borzeman/PzbElectronics/qr_code/requirements.md

## Общие сведения
Плата QR кода предназначена для подключения встраиваемых сканеров QR кода узлов
выдачи

## Назначение платы
Питать сканер QR кода и получать с него данные

## Функции
[[../requirements.md#Общие требования для всех плат]]

[[../requirements.md#Общие требования для дочерних плат]]
    Исключение:
    Нет отдельного отладочного UART порта (иначе не хватит на текущем
    контроллере; да и без надобности - любой из UART сканера можно для отладки
    использовать)

1. Сканер QR
   1. Число сканеров: 2
   2. Напряжение питания: 3.2..3.4 В
   3. Выдаваемый ток на каждый сканер: \>= 0.3 А
   4. Интерфейс подключения: UART, изолированный
      Каждый сканер подключается на отдельный UART
   5. Baudrate: \> 115200
   6. Задержка передачи: \< 100 мкс
      (от фронта на коннекторе до фронта на пине мк)
   6. Нужны и чтение, и запись
      сканер настраивается отправкой на него определённых байтов

## Механические свойства
### Изолированные крепления
Все места на плате, которые должны быть куда-то закреплены, должны быть
изолированы (т.е., например, если на плате есть выносной симистор, он должен
быть на изолированной подложке)
Т.е. монтаж платы выглядит так: взяли плату, вкрутили винты в отверстия, всё.
Никаких изоляторов (втулок и прочего) во время монтажа не используется

## Разъёмы
- Выведены штырьковые разъёмы обоих UART'ов
