borzeman/PzbElectronics/requirements.md

## Общие требования для всех плат
1. Наличие отладочных функций
   1. диоды
   2. gpio
   3. usart

2. Разъём отладочный универсальный
   1. содержит пины программатора, отладочные gpio
   2. дополнительный пин как ключ (чтоб не подключиться не той полярностью)

3. Тестовые площадки
   универсальные по контурам (контур rs одинаковые точки прозвонки на всех
   платах)

4. Кварц. внешний тактовый генератор

5. Соблюдён лимит тока пинов мк

6. Гальваническая изоляция питания, входов, выходов (в т.ч. от внешних
   исполнительных устройств типа драйверов)

7. Бирка на шелкографии
    Для идентификации версии платы. Содержит:
    1. лого
    2. тип и версия платы
    3. место под метку номера экземпляра (будем вручную вписывать)

## Общие требования для дочерних плат
1. Шина питания
   Обощая линия питания логики дочерних плат
   1. Напряжение линии: 22-25 В
   2. Допустимый потребляемый платой ток: \< 1 А
2. Шина данных
   Общая линия rs-485 с питанием для изоляторов, плюс отдельная линия rts у
   каждой дочерней платы
   1. Питание
      - Напряжение линии: 3.3 В
      - Допустимый потребляемый платой ток: \< 0.1 А
   2. Контур rs
      - Изолированный
      - Baudrate: \>115200
      - Задержка передачи: \< 100 мкс
      (от фронта на дочернем мк до фронта на линиях A/B)
   3. Линия rts
      - Изолированная
      - Время передачи сигнала: \< 10 мкс
        (от фронта на дочернем мк до фронта на коннекторе)
