borzeman/PzbElectronics/triac_board/requirements.md

# Симисторная плата
## Назначение платы
Управлять двумя ячейками печи (по 2 спирали в каждой)
Независимое управление по полупериодам (=> обнаруживать переход через 0)

## Функции
[[../requirements.md#Общие требования для всех плат]]

[[../requirements.md#Общие требования для дочерних плат]]

1. Входное питание
   1. Напряжение: бытовая сеть (210..230 В переменного)
   2. Потребляемый платой ток: \<= 20 А
2. Управление спиралями
   1. Управление по полупериодам (открыт/закрыт, синусоиду не обрезаем)
   2. Независимое управление
      (в любой момент можем включить/выключить любые спирали)
   3. Не более 2х спиралей включено одновременно (в рамках полупериода)
   4. Ток на спираль: до 9 А
   5. Напряжение на спираль: \>= 95% входного напряжения
   6. Режим работы
      Для каждой спирали: до двух минут непрерывной работы на максимальной
      мощности, далее не менее одного часа паузы
3. Переход через 0
   1. Время реакции: \<= 100 мкс
   (время от перехода через 0 до фронта на мк)
4. Защита от пробоя симистора
5. Защита от короткого замыкания выходов
   (спираль оборвалась и закоротила на себя или на корпус печи)

## Габаритные размеры
????

## Коннекторы и распиновка
Силовые коннекторы 230V должны иметь запас по току минимум в 2 раза от рассчётных значений
  
## Питание
Питание 230V заводится на каждую симисторную плату отдельно (предпочтительно выполнить в виде двухпроводной медной шины с проводником не менее 1.5 кв.мм) 
Питание управляющей части заводится с внешнего блока питания через коннектор материнской платы 

## Шина данных
Шина представляет собой RS485 с одним лишь дополнением. Используется дополнительно линия RTS, по одной линии на каждый дочерний модуль, за исключением "процессорного модуля"
На "процессорном модуле" количество RTS линий соотвествует количеству возможных дочерних модулей исполнительных устройств, например 16. На "процессорном модуле"
линии RTS - входы. На дочерних - выходы.

## Режим работы нагревательного элемента
Режим работы нагревательного элемента представляет собой нагрев в течение 2 минут на высокой мощности с дальнейшей работой в режиме поддержания температуры (5-10% мощности) в течение 20 минут.

## Дополнительно
- Помехи от коммутации напряжения питания нагревательных элементов не должны влиять на работу других узлов платы управления.
- Силовая шина должна проходить через датчик тока, сигнал с которого должен обрабатываться управляющим контроллером платы
- Свободное место слоев платы должно быть покрыто медной фольгой и подтянуто на землю.
- На печатной плате должны быть обозначены в виде примитивов с нумерацией, все микросхемы и основные элементы. Все разъемы должны быть пронумерованы с обозначением первой ноги. Ножки и разъемы эл. питания должны быть подписаны с указанием уровней напряжений.
- Печатная плата должна быть покрыта защитной маской со всех сторон.
- Первичную трассировку проводов имеет смысл провести до начала разводки плат, дабы исключить коллизии проводов и чтоб появилось понимание оптимального расположения коннекторов на платах.
- Все входы-выходы должны иметь защиту от перенапряжения, обратной полярности, статики и т.п.(см IEC 61131 и прочие посказки)
