borzeman/PzbElectronics/digit_in_board/requirements.md

# Плата дискретных входов выходов

## Общие сведения
Плата с универсальными входами для сигналов и выходами для управления нагрузкой
Входы и выходы назависимые, выходы могут напрямую управлять небольшой нагрузкой

## Назначение платы
- Управлять npn транзисторами, коммутирующими светодиодные ленты
  каждым каналом независимо, с изменением яркости
- Управлять магнитными замками напрямую
- Открывать реле для управления ультразвуковыми генераторами
- Питать диоды и фототранзисторы платы led\_board
- Принимать сигналы от платы led\_board

## Функции
[[../requirements.md#Общие требования для всех плат]]

[[../requirements.md#Общие требования для дочерних плат]]

1. Входы
   логика 24 В, дискретные, независимые, с гистерезисом
   1. Время реакции: \< 1 мс
      (время от фронта на коннекторе до фронта на пине мк)
   2. Напряжение
      1. Максимум: 25 В
      2. Минимум: -0.5 В
      3. Нижний уровень: \<= 3 В
      4. Верхний уровень: \>= 20 В
   3. Ток
      1. Потребляемый: \<= 10 мА
         (т.е. плата ограничивает потребялемый ток этим значением)
      2. Достаточный для срабатывания: \<= 2 мА
   4. Независимые
      (мк получает сигналы отдельно для каждого входа)
2. Выходы
   24 В, дискретные, независимые, с ШИМом
   1. Время реакции: \< 10 мкс
      (время от фронта на пине мк до фронта на выходе)
   2. Напряжение: 0..24+-0.5 В
   3. Выдаёт ток
      1. до 1 А на канал
      2. до 3 А в сумме постоянно
      3. до 6 А в сумме в течение 30 секунд
   4. Независимое управление
   5. ШИМ
      1. Частота: \>= 500 Гц
      2. Шаг скважности: \>= 1%
3. Защита от переполюсовки питания
   Плата не должна выйти из строя от переполюсовки внешнего питания
   (выдерживает \>= 2 минуты подключения питания с обратной полярностью)
4. Без питания логической части не должен подаваться ток на выходы
   (даже если силовая часть запитана, а логика нет)
