borzeman/PzbElectronics/analog_io_board/requirements.md

## Общие сведения
Вспомогательная плата для узла печи - вмещает элементы, не вошедшие в другие,
более универсальные, платы

Её функции - управление вентиляторами, замер тока и температуры, управление
входным реле печи

Дополнительно предполагаем использовать её в холодильнике (т.к. периферия
сильно пересекается) для управления вентиляторами, компрессором и получения
температуры с датчика холодильника

## Дочерняя плата
Данная плата является дочерней, вопросы ниже в ней такие же, как в дочерних
платах:
- Питание
- Шинна данных
- Собственный контроллер
- Защита входов-выходов

## Периферия
### Вентиляторы
2 канала, управляемых независимо (на одном канале вентилятор или группа
вентиляторов)
    [в холодильнике вентиляторы объединены в 2 группы]
220VAC
До 100 Вт
    [в холодильнике на одном канале до 4х вентиляторов по 20 Вт, плюс 20%
    запас]
Должны уметь регулировать скорость вращения
    [Вентилятор инертен, поэтому предполагаем, что низкой частоты ШИМ хватит, и
    что сможем делать это симисторами]

### Датчик тока
1 штука, трансформатор
Диапазон: 0..50А
Разрешение: не менее 1А
    [на контроллер должна приходить информация о текущем токе с шагом не более
    1А
    датчик и вся схемотехника должны обеспечить такое разрешение]

Должна быть фильтрация сигнала

### Датчик температуры
2 штуки, термопара

Диапазон: -10..150 градусов Цельсия
    [чтоб использовать в т.ч. датчики из холодильника]
Разрешение: не менее 1 градуса
    [точность в градус для управления холодильником
    для печи хватило бы и 5 градусов]
Обеспечить режим работы холодильника 2..8 градусов
    [вся схемотехника и датчики такие, чтоб можно было получить нужный
    гистерезис]

Должна быть фильтрация сигнала

### Входное реле
Реле, размыкающее питание на всю силовую часть печи
Используется для программной защиты от ошибок (например, когда какой-то
симистор пробит, автомат не сработает, т.к. ток через него не превышает лимит;
программно обнаружим превышение тока и отключим реле)
Пример: SSR-100-DA

1 штука
Тип: твердотельное или механическое
    учесть диод для подключения механического реле
Управляющий сигнал:
    Включение: 24VDC
    Выключение: <3.5VDC
    НЕ ограничивать ток (будут использоваться реле с входным сопротивлением)

## Механические свойства
### Изолированные крепления
Все места на плате, которые должны быть куда-то закреплены, должны быть
изолированы (т.е., например, если на плате есть выносной симистор, он должен
быть на изолированной подложке)
Т.е. монтаж платы выглядит так: взяли плату, вкрутили винты в отверстия, всё.
Никаких изоляторов (втулок и прочего) во время монтажа не используется
