borzeman/PzbElectronics/led_and_photodiode_board/led_and_photodiode_board.kicad_pcb

## KiCad design led_and_photodiode_board/led_and_photodiode_board.kicad_pcb (2025-10-31)

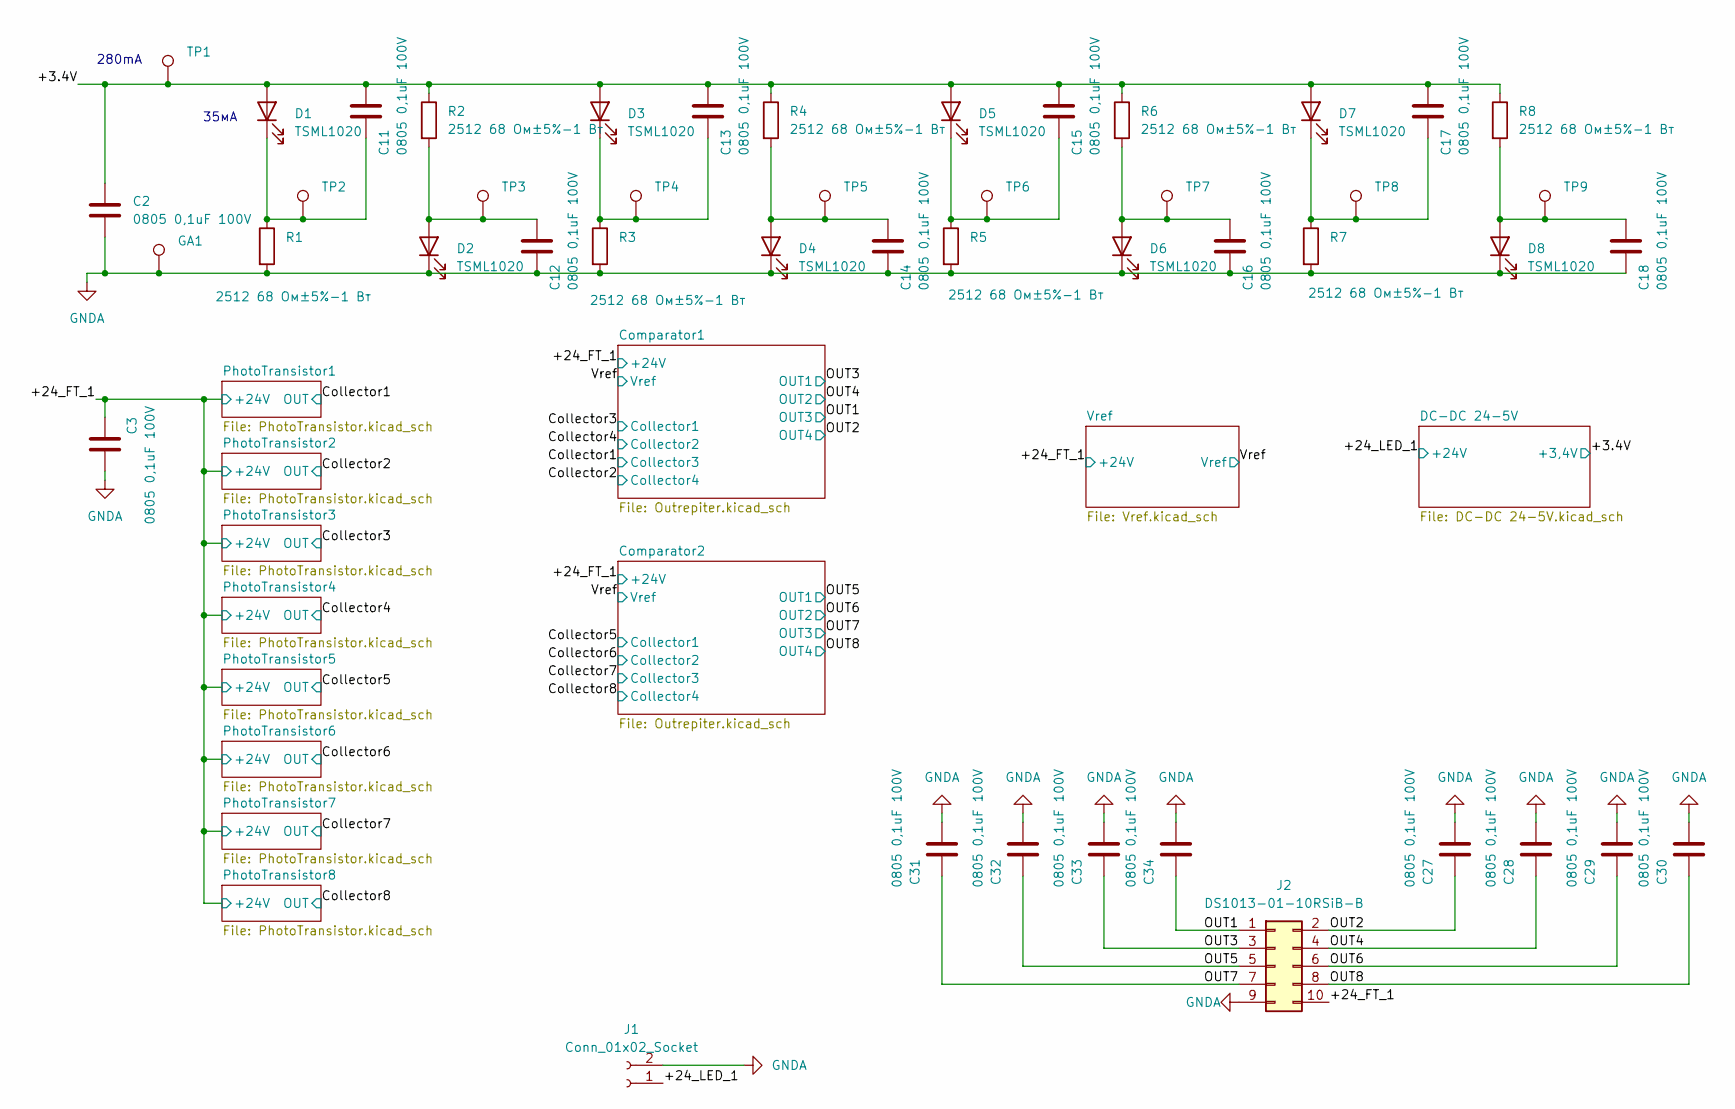
[picture p1: schematic led_and_photodiode_board.kicad_sch]

Parts:
C2, C3, C11, C12, C13, C14, C15, C16, C17, C18, C27, C28, C29, C30, C31, C32, C33, C34: 0805 0,1uF 100V; C_0805_2012Metric
D1, D2, D3, D4, D5, D6, D7, D8: TSML1020; D_MiniMELF
GA1: TestPoint; TestPoint_Pad_D1.0mm
J1: Conn_01x02_Socket; SolderWire-0.75sqmm_1x02_P7mm_D1.25mm_OD3.5mm
J2: DS1013-01-10RSiB-B; IDC-Header_2x05_P2.54mm_Horizontal
R1, R2, R3, R4, R5, R6, R7, R8: 2512 68 Ом±5%-1 Вт; R_2512_6332Metric
TP1, TP2, TP3, TP4, TP5, TP6, TP7, TP8, TP9: TestPoint; TestPoint_Pad_D1.0mm

Connections:
/+3.4V: C2.1, C11.1, C13.1, C15.1, C17.1, D1.2 (A), D3.2 (A), D5.2 (A), D7.2 (A), R2.1, R4.1, R6.1, R8.1, TP1.1; also elsewhere on the board
/+24_FT_1: C3.1, J2.10; also elsewhere on the board
/+24_LED_1: J1.1; also elsewhere on the board
/OUT1: C34.1, J2.1; also elsewhere on the board
/OUT2: C27.1, J2.2; also elsewhere on the board
/OUT3: C33.1, J2.3; also elsewhere on the board
/OUT4: C28.1, J2.4; also elsewhere on the board
/OUT5: C32.1, J2.5; also elsewhere on the board
/OUT6: C29.1, J2.6; also elsewhere on the board
/OUT7: C31.1, J2.7; also elsewhere on the board
/OUT8: C30.1, J2.8; also elsewhere on the board
GNDA: C2.2, C3.2, C12.2, C14.2, C16.2, C18.2, C27.2, C28.2, C29.2, C30.2, C31.2, C32.2, C33.2, C34.2, D2.1 (K), D4.1 (K), D6.1 (K), D8.1 (K), GA1.1, J1.2, J2.9, R1.2, R3.2, R5.2, R7.2; also elsewhere on the board
unnamed: C11.2, D1.1 (K), R1.1, TP2.1
unnamed: C12.1, D2.2 (A), R2.2, TP3.1
unnamed: C13.2, D3.1 (K), R3.1, TP4.1
unnamed: C14.1, D4.2 (A), R4.2, TP5.1
unnamed: C15.2, D5.1 (K), R5.1, TP6.1
unnamed: C16.1, D6.2 (A), R6.2, TP7.1
unnamed: C17.2, D7.1 (K), R7.1, TP8.1
unnamed: C18.1, D8.2 (A), R8.2, TP9.1

Notes on the sheet:
35мА
280mA

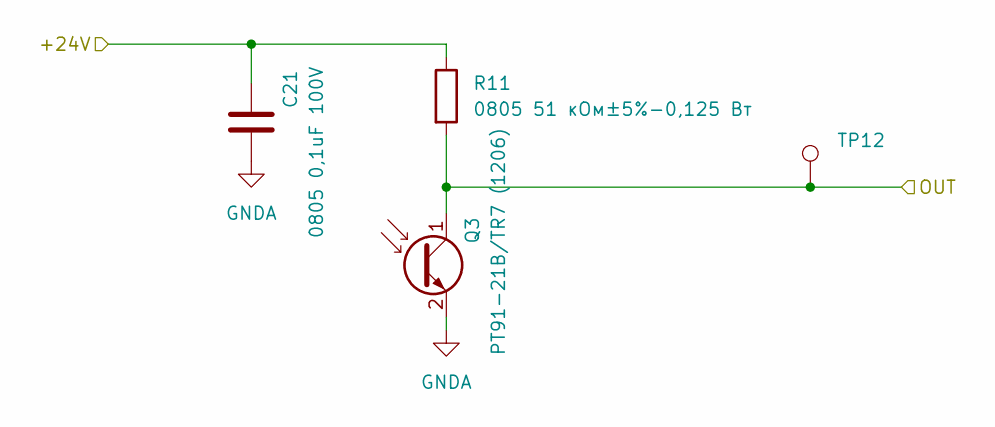
[picture p2: schematic PhotoTransistor.kicad_sch]

Parts:
C21: 0805 0,1uF 100V; C_0805_2012Metric
Q3: PT91-21B/TR7 (1206); D_1206_3216Metric_Pad1.42x1.75mm_HandSolder
R11: 0805 51 кОм±5%-0,125 Вт; R_0805_2012Metric
TP12: TestPoint; TestPoint_Pad_D1.0mm

Connections:
/+24_FT_1: C21.1, R11.1; also elsewhere on the board
/Collector3: Q3.1 (C), R11.2, TP12.1; also elsewhere on the board
GNDA: C21.2, Q3.2 (E); also elsewhere on the board

Parts of its further copies:
C19, C20, C22, C23, C24, C25, C26: 0805 0,1uF 100V; C_0805_2012Metric
Q1, Q2, Q4, Q5, Q6, Q7, Q8: PT91-21B/TR7 (1206); D_1206_3216Metric_Pad1.42x1.75mm_HandSolder
R9, R10, R12, R13, R14, R15, R16: 0805 51 кОм±5%-0,125 Вт; R_0805_2012Metric
TP10, TP11, TP13, TP14, TP15, TP16, TP17: TestPoint; TestPoint_Pad_D1.0mm

Connections of its further copies:
/+24_FT_1: C19.1, C20.1, C22.1, C23.1, C24.1, C25.1, C26.1, R9.1, R10.1, R12.1, R13.1, R14.1, R15.1, R16.1; also elsewhere on the board
/Collector1: Q1.1 (C), R9.2, TP10.1; also elsewhere on the board
/Collector2: Q2.1 (C), R10.2, TP11.1; also elsewhere on the board
/Collector4: Q4.1 (C), R12.2, TP13.1; also elsewhere on the board
/Collector5: Q5.1 (C), R13.2, TP14.1; also elsewhere on the board
/Collector6: Q6.1 (C), R14.2, TP15.1; also elsewhere on the board
/Collector7: Q7.1 (C), R15.2, TP16.1; also elsewhere on the board
/Collector8: Q8.1 (C), R16.2, TP17.1; also elsewhere on the board
GNDA: C19.2, C20.2, C22.2, C23.2, C24.2, C25.2, C26.2, Q1.2 (E), Q2.2 (E), Q4.2 (E), Q5.2 (E), Q6.2 (E), Q7.2 (E), Q8.2 (E); also elsewhere on the board

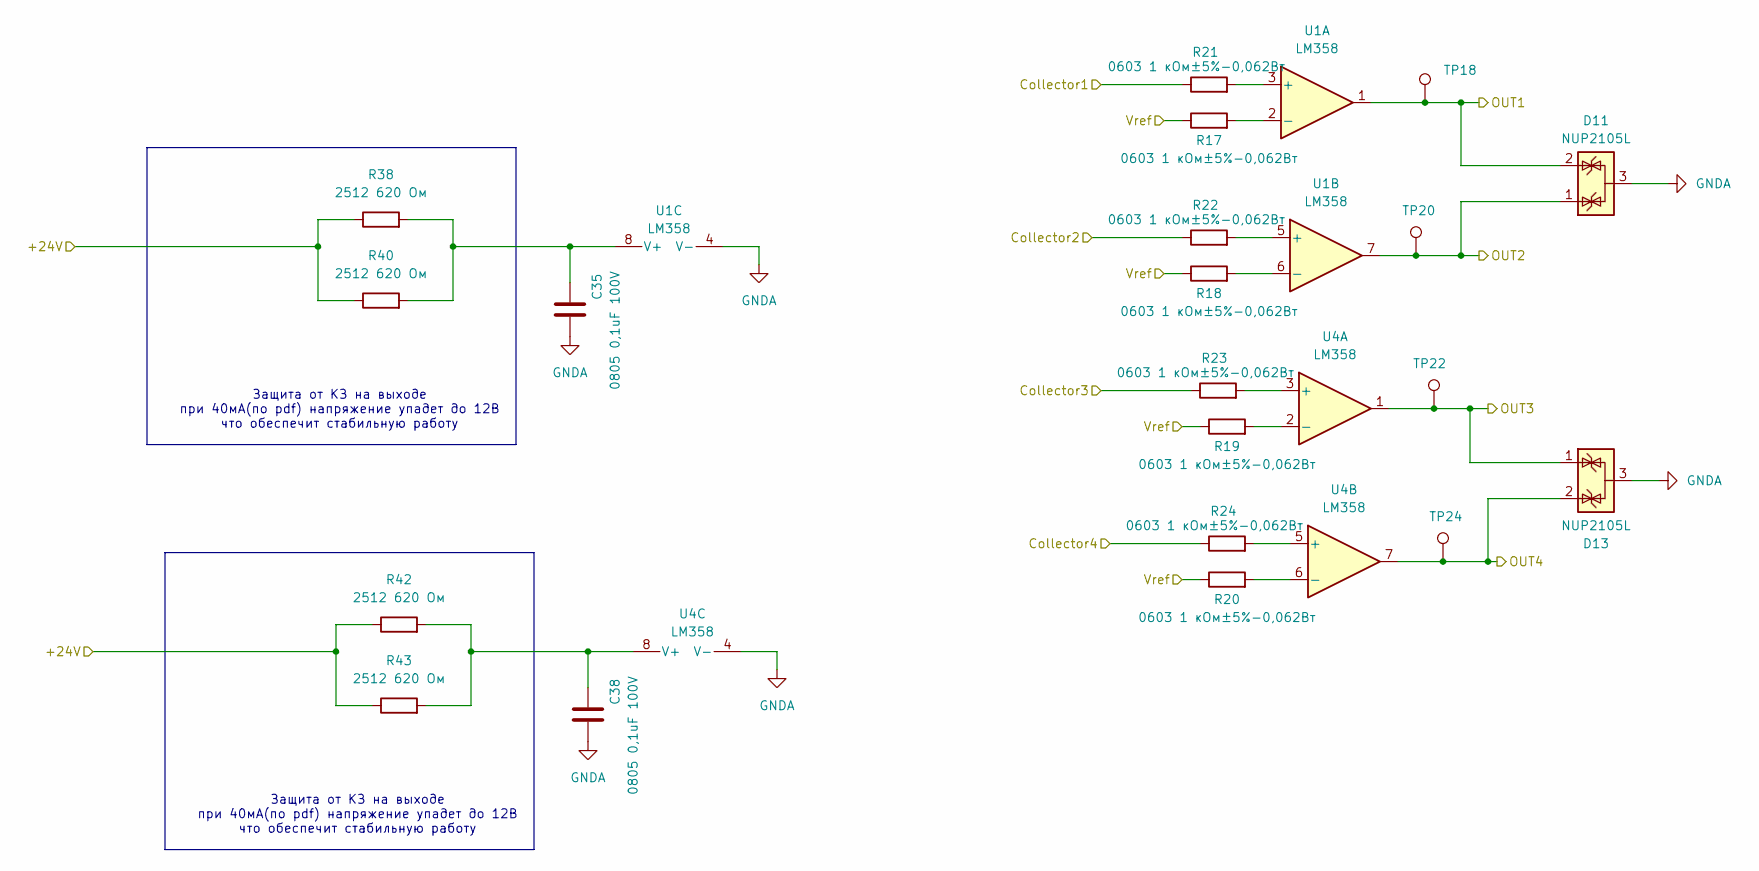
[picture p3: schematic Outrepiter.kicad_sch]

Parts:
C35, C38: 0805 0,1uF 100V; C_0805_2012Metric
D11, D13: NUP2105L; SOT-23
R17, R18, R19, R20, R21, R22, R23, R24: 0603 1 кОм±5%-0,062Вт; R_0603_1608Metric
R38, R40, R42, R43: 2512 620 Ом; R_2512_6332Metric
TP18, TP20, TP22, TP24: TestPoint; TestPoint_Pad_D1.0mm
U1, U4: LM358; SOIC-8_3.9x4.9mm_P1.27mm

Connections:
/+24_FT_1: R38.1, R40.1, R42.1, R43.1; also elsewhere on the board
/Collector1: R23.1; also elsewhere on the board
/Collector2: R24.1; also elsewhere on the board
/Collector3: R21.1; also elsewhere on the board
/Collector4: R22.1; also elsewhere on the board
/OUT1: D13.1 (K), TP22.1, U4.1; also elsewhere on the board
/OUT2: D13.2 (K), TP24.1, U4.7; also elsewhere on the board
/OUT3: D11.2 (K), TP18.1, U1.1; also elsewhere on the board
/OUT4: D11.1 (K), TP20.1, U1.7; also elsewhere on the board
/Vref: R17.1, R18.1, R19.1, R20.1; also elsewhere on the board
GNDA: C35.2, C38.2, D11.3 (A), D13.3 (A), U1.4 (V-), U4.4 (V-); also elsewhere on the board
unnamed: R21.2, U1.3 (+)
unnamed: R17.2, U1.2 (-)
unnamed: R22.2, U1.5 (+)
unnamed: R18.2, U1.6 (-)
unnamed: C35.1, R38.2, R40.2, U1.8 (V+)
unnamed: R23.2, U4.3 (+)
unnamed: R19.2, U4.2 (-)
unnamed: R24.2, U4.5 (+)
unnamed: R20.2, U4.6 (-)
unnamed: C38.1, R42.2, R43.2, U4.8 (V+)

Parts of its further copies:
C1, C39: 0805 0,1uF 100V; C_0805_2012Metric
D12, D14: NUP2105L; SOT-23
R25, R26, R27, R28, R29, R30, R31, R32: 0603 1 кОм±5%-0,062Вт; R_0603_1608Metric
R39, R41, R44, R45: 2512 620 Ом; R_2512_6332Metric
TP19, TP21, TP23, TP25: TestPoint; TestPoint_Pad_D1.0mm
U2, U5: LM358; SOIC-8_3.9x4.9mm_P1.27mm

Connections of its further copies:
/+24_FT_1: R39.1, R41.1, R44.1, R45.1; also elsewhere on the board
/Collector5: R25.1; also elsewhere on the board
/Collector6: R27.1; also elsewhere on the board
/Collector7: R29.1; also elsewhere on the board
/Collector8: R31.1; also elsewhere on the board
/OUT5: D12.2 (K), TP19.1, U2.1; also elsewhere on the board
/OUT6: D12.1 (K), TP21.1, U2.7; also elsewhere on the board
/OUT7: D14.1 (K), TP23.1, U5.1; also elsewhere on the board
/OUT8: D14.2 (K), TP25.1, U5.7; also elsewhere on the board
/Vref: R26.1, R28.1, R30.1, R32.1; also elsewhere on the board
GNDA: C1.2, C39.2, D12.3 (A), D14.3 (A), U2.4 (V-), U5.4 (V-); also elsewhere on the board
unnamed: R25.2, U2.3 (+)
unnamed: R26.2, U2.2 (-)
unnamed: R27.2, U2.5 (+)
unnamed: R28.2, U2.6 (-)
unnamed: C1.1, R39.2, R41.2, U2.8 (V+)
unnamed: R29.2, U5.3 (+)
unnamed: R30.2, U5.2 (-)
unnamed: R31.2, U5.5 (+)
unnamed: R32.2, U5.6 (-)
unnamed: C39.1, R44.2, R45.2, U5.8 (V+)

Notes on the sheet:
Защита от КЗ на выходе при 40мА(по pdf) напряжение упадет до 12В что обеспечит стабильную работу

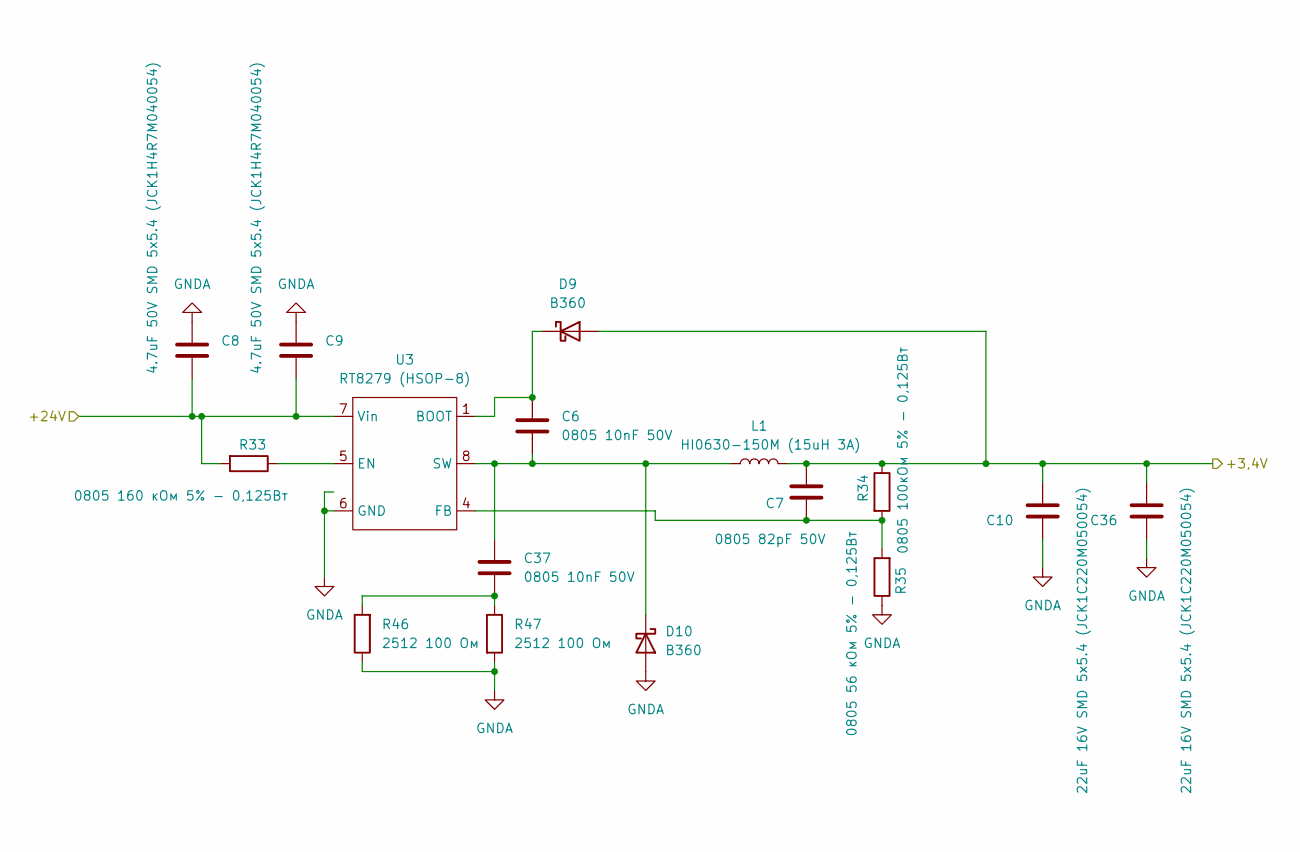
[picture p4: schematic DC-DC 24-5V.kicad_sch]

Parts:
C6, C37: 0805 10nF 50V; C_0805_2012Metric
C7: 0805 82pF 50V; C_0805_2012Metric
C8, C9: 4.7uF 50V SMD 5x5.4 (JCK1H4R7M040054); C_Elec_5x5.4
C10, C36: 22uF 16V SMD 5x5.4 (JCK1C220M050054); C_Elec_5x5.4
D9, D10: B360; D_SMC
L1: HI0630-150M (15uH 3A); L_APV_APH0630
R33: 0805 160 кОм 5% - 0,125Вт; R_0805_2012Metric
R34: 0805 100кОм 5% - 0,125Вт; R_0805_2012Metric
R35: 0805 56 кОм 5% - 0,125Вт; R_0805_2012Metric
R46, R47: 2512 100 Ом; R_2512_6332Metric_Pad1.40x3.35mm_HandSolder
U3: RT8279 (HSOP-8); HSOP-8-1EP_3.9x4.9mm_P1.27mm_EP2.41x3.1mm

Connections:
/+3.4V: C7.1, C10.2, C36.2, D9.2 (A), L1.2, R34.1; also elsewhere on the board
/+24_LED_1: C8.2, C9.2, R33.2, U3.7 (Vin); also elsewhere on the board
GNDA: C8.1, C9.1, C10.1, C36.1, D10.2 (A), R35.1, R46.1, R47.2, U3.2 (NC), U3.3 (NC), U3.6 (GND), U3.9 (GND); also elsewhere on the board
unnamed: C37.1, R46.2, R47.1
unnamed: C6.1, D9.1 (K), U3.1 (BOOT)
unnamed: C6.2, C37.2, D10.1 (K), L1.1, U3.8 (SW)
unnamed: R33.1, U3.5 (EN)
unnamed: C7.2, R34.2, R35.2, U3.4 (FB)

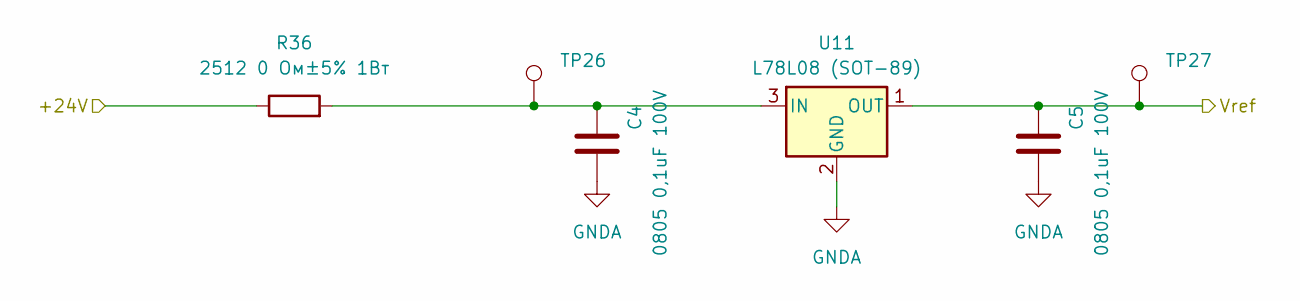
[picture p5: schematic Vref.kicad_sch]

Parts:
C4, C5: 0805 0,1uF 100V; C_0805_2012Metric
R36: 2512 0 Ом±5% 1Вт; R_2512_6332Metric
TP26, TP27: TestPoint; TestPoint_Pad_D1.0mm
U11: L78L08 (SOT-89); SOT-89-3

Connections:
/+24_FT_1: R36.1; also elsewhere on the board
/Vref: C5.1, TP27.1, U11.1 (OUT); also elsewhere on the board
GNDA: C4.2, C5.2, U11.2 (GND); also elsewhere on the board
unnamed: C4.1, R36.2, TP26.1, U11.3 (IN)

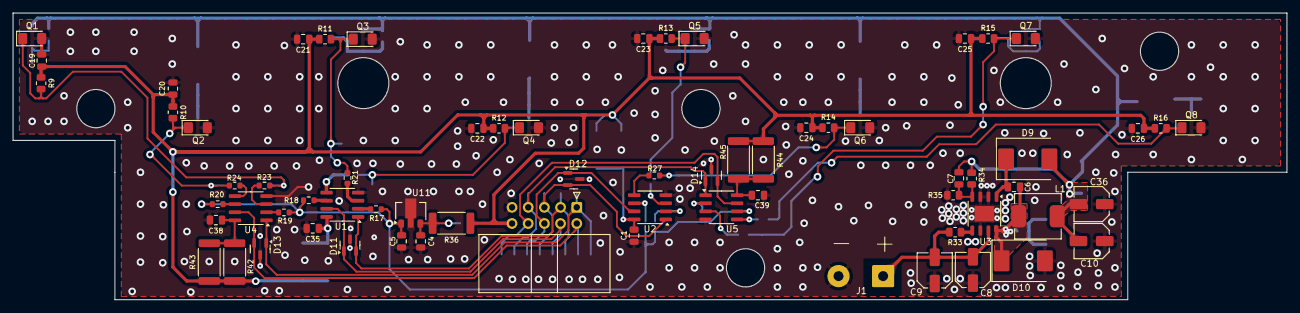
[picture p6: board led_and_photodiode_board.kicad_pcb from above]

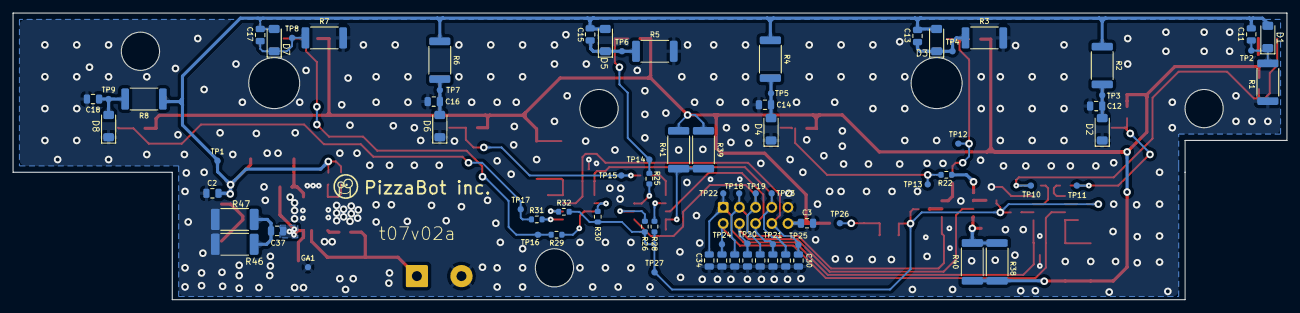
[picture p7: board led_and_photodiode_board.kicad_pcb from below]

Board: 2 copper layers, 200.0 x 45.0 mm, 144 parts (77 on the bottom side), 55 nets.
