borzeman/PzbElectronics/dc_motor_board/dc_motor_board.kicad_pcb

## KiCad design dc_motor_board/dc_motor_board.kicad_pcb (2025-10-31)

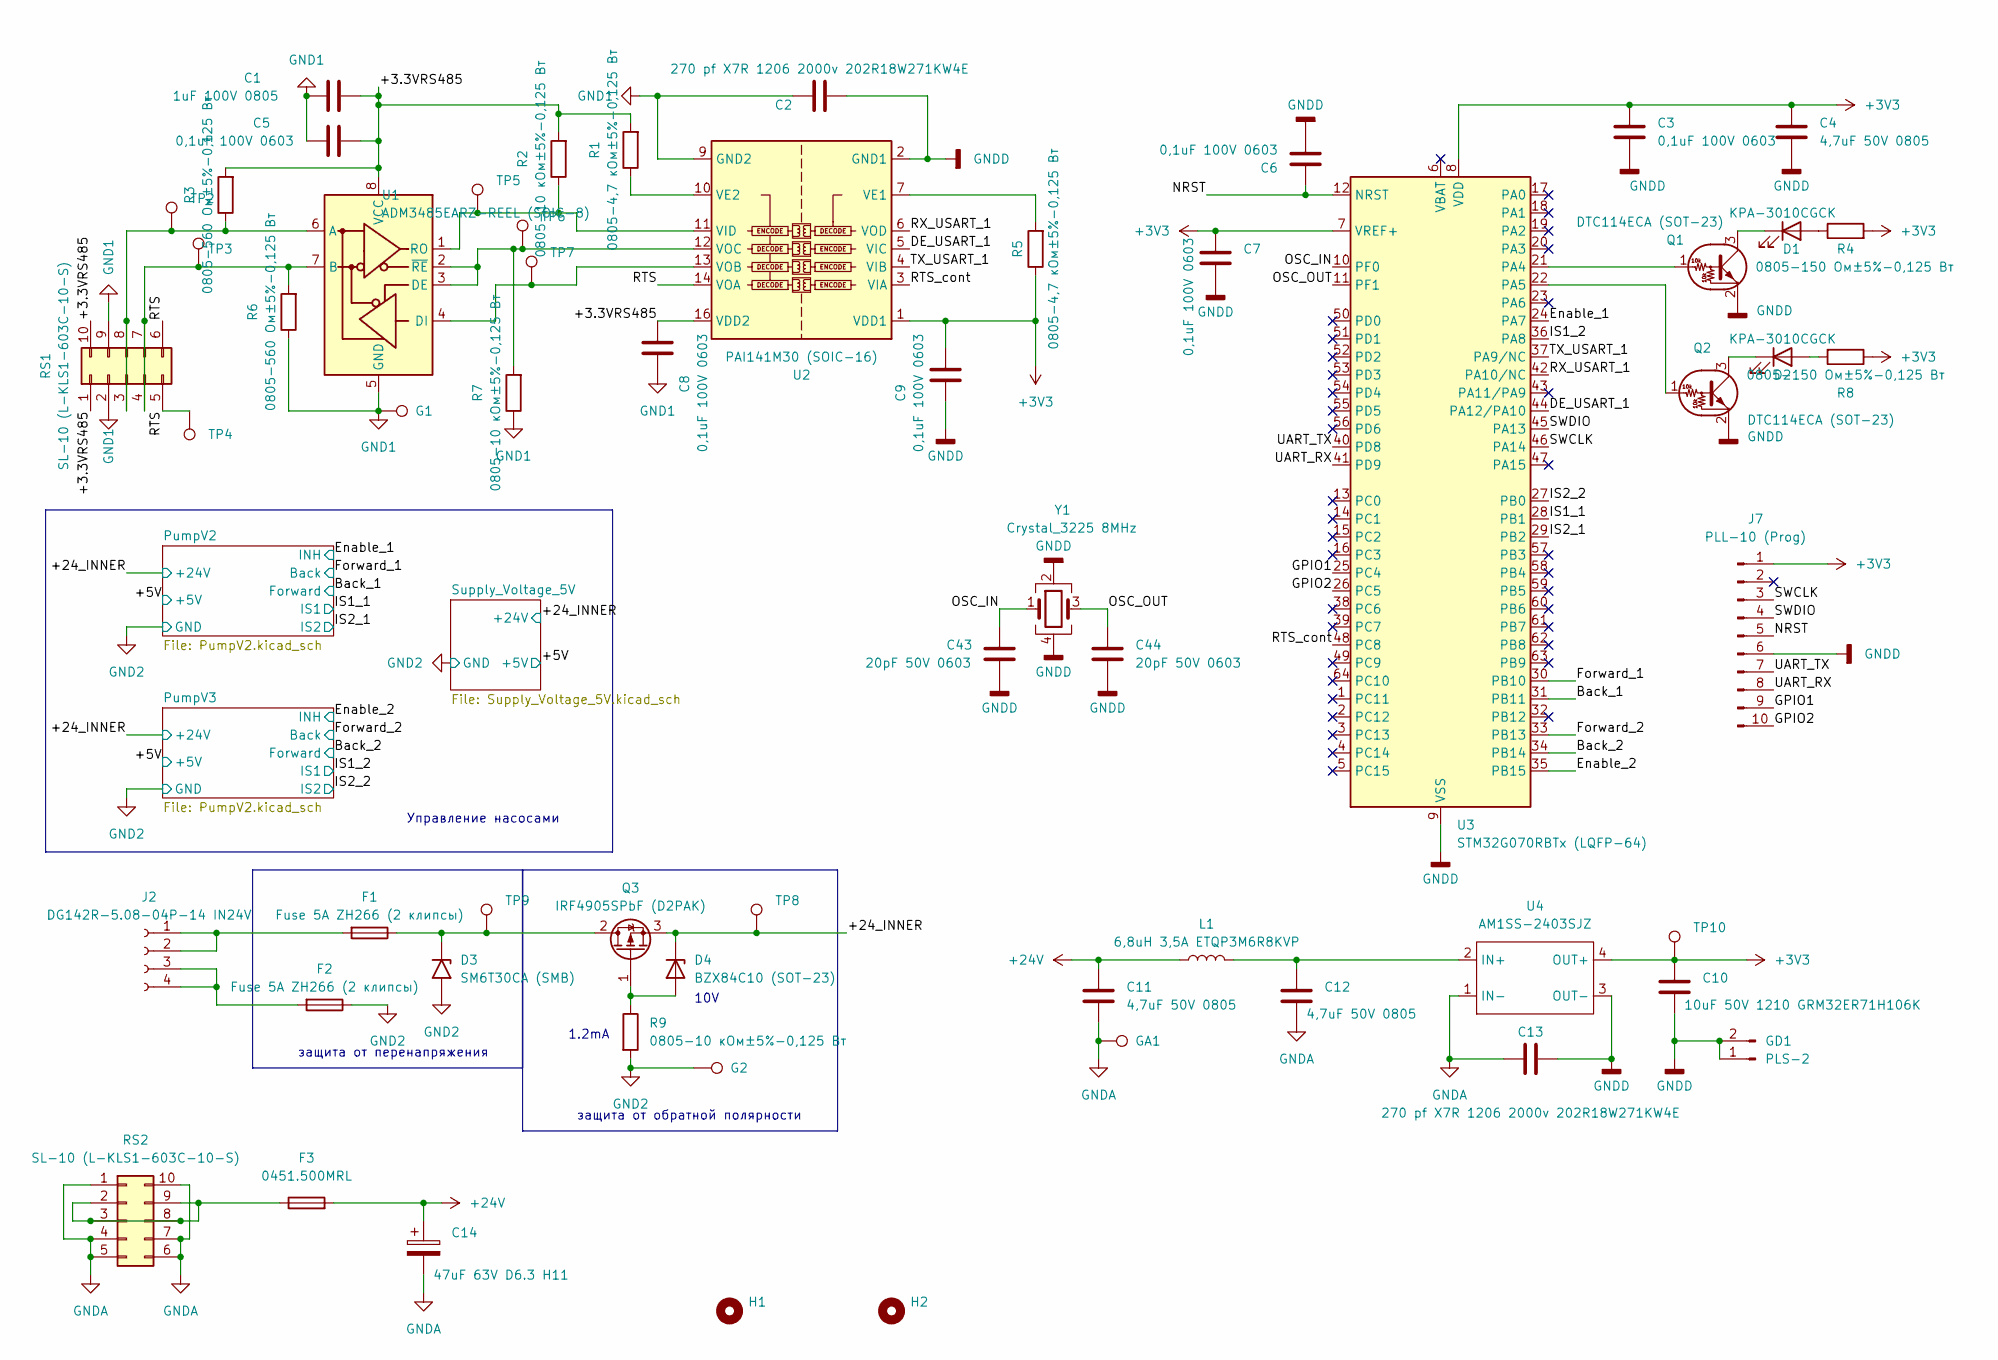
[picture p8: schematic dc_motor_board.kicad_sch]

Parts:
C1: 1uF 100V 0805; C_0805_2012Metric
C2, C13: 270 pf X7R 1206 2000v 202R18W271KW4E; C_1210_3225Metric
C3, C5, C6, C7, C8, C9: 0,1uF 100V 0603; C_0603_1608Metric
C4, C11, C12: 4,7uF 50V 0805; C_0805_2012Metric
C10: 10uF 50V 1210 GRM32ER71H106K; C_1210_3225Metric
C14: 47uF 63V D6.3 H11; CP_Radial_D6.3mm_P2.50mm
C43, C44: 20pF 50V 0603; C_0603_1608Metric
D1, D2: KPA-3010CGCK; LED_Kingbright_KPA-3010_3x2x1mm
D3: SM6T30СA (SMB); D_SMB
D4: BZX84C10 (SOT-23); SOT-23
F1, F2: Fuse 5A ZH266 (2 клипсы); Fuseholder_100_series_5x20mm_D1,5
F3: 0451.500MRL; Fuse_Littelfuse-NANO2-451_453
G1, G2: TestPoint; TestPoint_Pad_D1.0mm
GA1: TestPoint; TestPoint_Pad_D1.0mm
GD1: PLS-2; PinHeader_1x02_P2.54mm_Vertical
H1, H2: MountingHole; MountingHole_3.2mm_M3
J2: DG142R-5.08-04P-14 IN24V; DG142R-5.08-04P-14
J7: PLL-10 (Prog); PinHeader_1x10_P1.27mm_Vertical
L1: 6,8uH 3,5A ETQP3M6R8KVP; L_Bourns-SRN6028
Q1, Q2: DTC114ECA (SOT-23); SOT-23
Q3: IRF4905SPbF (D2PAK); TO-263-2
R1, R5: 0805-4,7 кОм±5%-0,125 Вт; R_0805_2012Metric
R2, R7, R9: 0805-10 кОм±5%-0,125 Вт; R_0805_2012Metric
R3, R6: 0805-560 Ом±5%-0,125 Вт; R_0805_2012Metric
R4, R8: 0805-150 Ом±5%-0,125 Вт; R_0805_2012Metric
RS1, RS2: SL-10 (L-KLS1-603C-10-S); Edge_Conn_KLS1-603-10
TP2, TP3, TP4, TP5, TP6, TP7, TP8, TP9, TP10: TestPoint; TestPoint_Pad_D1.0mm
U1: ADM3485EARZ-REEL (SOIC-8); SOIC-8_3.9x4.9mm_P1.27mm
U2: PAI141M30 (SOIC-16); SOIC-16_3.9x9.9mm_P1.27mm
U3: STM32G070RBTx (LQFP-64); LQFP-64_10x10mm_P0.5mm
U4: AM1SS-2403SJZ; Converter_DCDC_Murata_MEE1SxxxxSC_THT
Y1: Crystal_3225 8MHz; Crystal_SMD_TXC_7M-4Pin_3.2x2.5mm

Connections:
+3V3: C3.1, C4.1, C7.1, C9.2, C10.1, J7.1, R4.2, R5.1, R8.1, TP10.1, U2.1 (VDD1), U3.7 (VREF+), U3.8 (VDD), U4.4 (OUT+); also elsewhere on the board
+24V: C11.1, C14.1, F3.2, L1.1
/+3.3VRS485: C1.2, C5.2, C8.2, R1.2, R2.2, R3.2, RS1.1, RS1.10, U1.8 (VCC), U2.16 (VDD2)
/+24_INNER: D4.3 (K), Q3.3 (S), TP8.1; also elsewhere on the board
/Back_1: U3.31 (PB11); also elsewhere on the board
/Back_2: U3.34 (PB14); also elsewhere on the board
/DE_USART_1: U2.5 (VIC), U3.44 (PA12/PA10)
/Enable_1: U3.24 (PA7); also elsewhere on the board
/Enable_2: U3.35 (PB15); also elsewhere on the board
/Forward_1: U3.30 (PB10); also elsewhere on the board
/Forward_2: U3.33 (PB13); also elsewhere on the board
/GPIO1: J7.9, U3.25 (PC4)
/GPIO2: J7.10, U3.26 (PC5)
/IS1_1: U3.28 (PB1); also elsewhere on the board
/IS1_2: U3.36 (PA8); also elsewhere on the board
/IS2_1: U3.29 (PB2); also elsewhere on the board
/IS2_2: U3.27 (PB0); also elsewhere on the board
/NRST: C6.1, J7.5, U3.12 (NRST)
/OSC_IN: C43.1, U3.10 (PF0), Y1.1
/OSC_OUT: C44.1, U3.11 (PF1), Y1.3
/RTS: RS1.5, RS1.6, TP4.1, U2.14 (VOA)
/RTS_cont: U2.3 (VIA), U3.48 (PC8)
/RX_USART_1: U2.6 (VOD), U3.42 (PA10/NC)
/SWCLK: J7.3, U3.46 (PA14)
/SWDIO: J7.4, U3.45 (PA13)
/TX_USART_1: U2.4 (VIB), U3.37 (PA9/NC)
/UART_RX: J7.8, U3.41 (PD9)
/UART_TX: J7.7, U3.40 (PD8)
GND1: C1.1, C2.1, C5.1, C8.1, G1.1, R6.1, R7.1, RS1.2, RS1.9, U1.5 (GND), U2.9 (GND2), U2.15 (GND2)
GND2: D3.2 (A2), F2.1, G2.1, R9.2; also elsewhere on the board
GNDA: C11.2, C12.2, C13.1, C14.2, GA1.1, RS2.1, RS2.4, RS2.5, RS2.6, RS2.7, RS2.10, U4.1 (IN-)
GNDD: C2.2, C3.2, C4.2, C6.2, C7.2, C9.1, C10.2, C13.2, C43.2, C44.2, GD1.1, GD1.2, J7.6, Q1.2 (E), Q2.2 (E), U2.2 (GND1), U2.8 (GND1), U3.9 (VSS), U4.3 (OUT-), Y1.2, Y1.4; also elsewhere on the board
unnamed: D1.2 (A), R4.1
unnamed: D1.1 (K), Q1.3 (C)
unnamed: D2.2 (A), R8.2
unnamed: D2.1 (K), Q2.3 (C)
unnamed: D3.1 (A1), F1.1, Q3.2 (D), TP9.1
unnamed: D4.1 (A), Q3.1 (G), R9.1
unnamed: F1.2, J2.1, J2.2
unnamed: F2.2, J2.3, J2.4
unnamed: Q1.1 (B), U3.21 (PA4)
unnamed: Q2.1 (B), U3.22 (PA5)
unnamed: R3.1, RS1.3, RS1.8, TP2.1, U1.6 (A)
unnamed: R6.2, RS1.4, RS1.7, TP3.1, U1.7 (B)
unnamed: F3.1, RS2.2, RS2.3, RS2.8, RS2.9
unnamed: R7.2, TP6.1, U1.2 (~RE), U1.3 (DE), U2.12 (VOC)
unnamed: TP7.1, U1.4 (DI), U2.13 (VOB)
unnamed: R2.1, TP5.1, U1.1 (RO), U2.11 (VID)
unnamed: R5.2, U2.7 (VE1)
unnamed: R1.1, U2.10 (VE2)
unnamed: C12.1, L1.2, U4.2 (IN+)

Notes on the sheet:
Управление насосами
10V
защита от перенапряжения
1.2mA
защита от обратной полярности

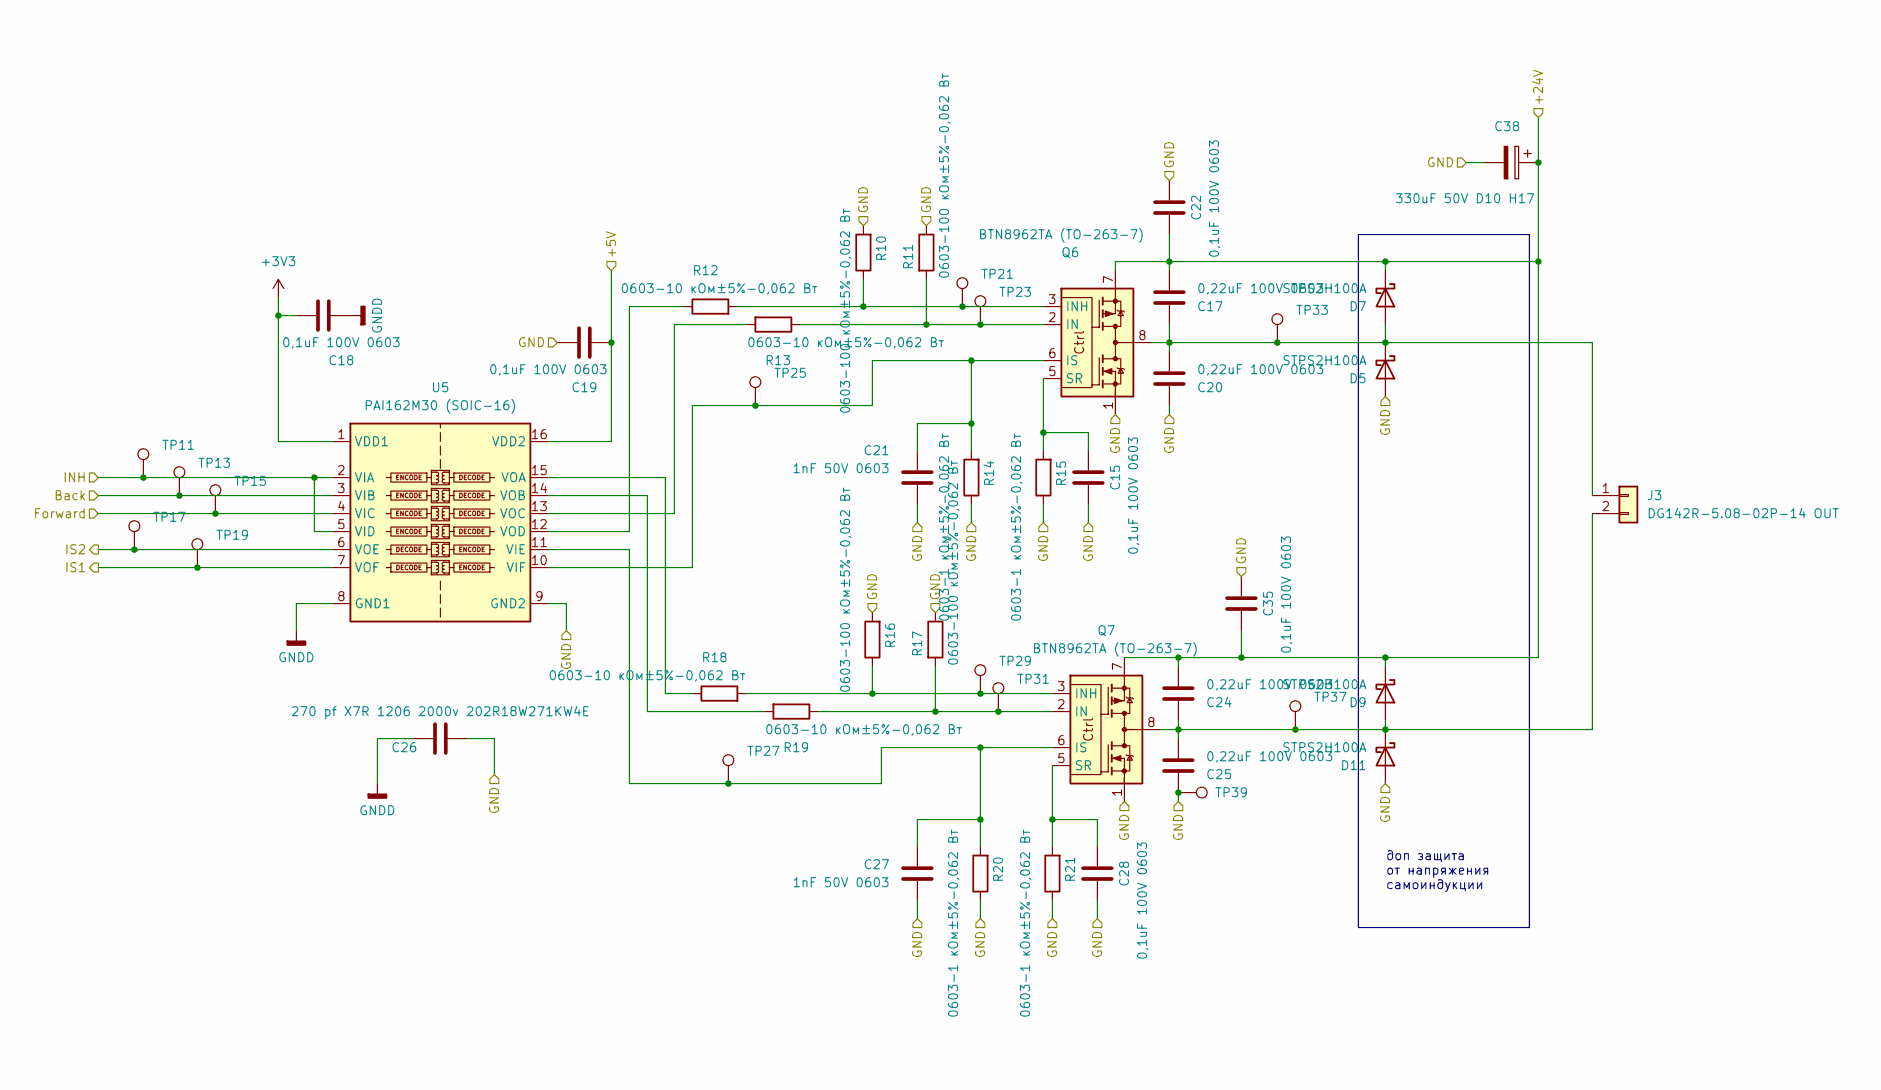
[picture p9: schematic PumpV2.kicad_sch]

Parts:
C15, C18, C19, C22, C28, C35: 0,1uF 100V 0603; C_0603_1608Metric
C17, C20, C24, C25: 0,22uF 100V 0603; C_0603_1608Metric_Pad1.08x0.95mm_HandSolder
C21, C27: 1nF 50V 0603; C_0603_1608Metric_Pad1.08x0.95mm_HandSolder
C26: 270 pf X7R 1206 2000v 202R18W271KW4E; C_1210_3225Metric
C38: 330uF 50V D10 H17; CP_Radial_D10.0mm_P5.00mm
D5, D7, D9, D11: STPS2H100A; D_SMA
J3: DG142R-5.08-02P-14 OUT; DG142R-5.08-02P-14
Q6, Q7: BTN8962TA (TO-263-7); TO-263-7_TabPin8
R10, R11, R16, R17: 0603-100 кОм±5%-0,062 Вт; R_0603_1608Metric
R12, R13, R18, R19: 0603-10 кОм±5%-0,062 Вт; R_0603_1608Metric
R14, R15, R20, R21: 0603-1 кОм±5%-0,062 Вт; R_0603_1608Metric
TP11, TP13, TP15, TP17, TP19, TP21, TP23, TP25, TP27, TP29, TP31, TP33, TP37, TP39: TestPoint; TestPoint_Pad_D1.0mm
U5: PAI162M30 (SOIC-16); SOIC-16_3.9x9.9mm_P1.27mm

Connections:
+3V3: C18.2, U5.1 (VDD1); also elsewhere on the board
/+5V: C19.1, U5.16 (VDD2); also elsewhere on the board
/+24_INNER: C17.2, C22.1, C24.2, C35.1, C38.1, D7.1 (K), D9.1 (K), Q6.7, Q7.7; also elsewhere on the board
/Back_2: TP15.1, U5.4 (VIC); also elsewhere on the board
/Enable_2: TP11.1, U5.2 (VIA), U5.5 (VID); also elsewhere on the board
/Forward_2: TP13.1, U5.3 (VIB); also elsewhere on the board
/IS1_2: TP19.1, U5.7 (VOF); also elsewhere on the board
/IS2_2: TP17.1, U5.6 (VOE); also elsewhere on the board
GND2: C15.1, C19.2, C20.1, C21.1, C22.2, C25.1, C26.2, C27.1, C28.1, C35.2, C38.2, D5.2 (A), D11.2 (A), Q6.1, Q7.1, R10.2, R11.1, R14.1, R15.1, R16.2, R17.1, R20.1, R21.1, TP39.1, U5.9 (GND2); also elsewhere on the board
GNDD: C18.1, C26.1, U5.8 (GND1); also elsewhere on the board
unnamed: C17.1, C20.2, D5.1 (K), D7.2 (A), J3.1, Q6.4, Q6.8, TP33.1
unnamed: C24.1, C25.2, D9.2 (A), D11.1 (K), J3.2, Q7.4, Q7.8, TP37.1
unnamed: Q6.2 (IN), R11.2, R13.1, TP23.1
unnamed: Q6.3 (INH), R10.1, R12.2, TP21.1
unnamed: C21.2, Q6.6 (IS), R14.2, TP25.1, U5.10 (VIF)
unnamed: C15.2, Q6.5 (SR), R15.2
unnamed: Q7.2 (IN), R17.2, R19.1, TP31.1
unnamed: Q7.3 (INH), R16.1, R18.2, TP29.1
unnamed: C27.2, Q7.6 (IS), R20.2, TP27.1, U5.11 (VIE)
unnamed: C28.2, Q7.5 (SR), R21.2
unnamed: R18.1, U5.15 (VOA)
unnamed: R19.2, U5.14 (VOB)
unnamed: R13.2, U5.13 (VOC)
unnamed: R12.1, U5.12 (VOD)

Parts of its further copies:
C16, C23, C30, C31, C34, C41: 0,1uF 100V 0603; C_0603_1608Metric
C29, C32, C36, C37: 0,22uF 100V 0603; C_0603_1608Metric_Pad1.08x0.95mm_HandSolder
C33, C46: 1nF 50V 0603; C_0603_1608Metric_Pad1.08x0.95mm_HandSolder
C42: 330uF 50V D10 H17; CP_Radial_D10.0mm_P5.00mm
C45: 270 pf X7R 1206 2000v 202R18W271KW4E; C_1210_3225Metric
D6, D8, D10, D12: STPS2H100A; D_SMA
J4: DG142R-5.08-02P-14 OUT; DG142R-5.08-02P-14
Q4, Q5: BTN8962TA (TO-263-7); TO-263-7_TabPin8
R22, R23, R28, R29: 0603-100 кОм±5%-0,062 Вт; R_0603_1608Metric
R24, R25, R30, R31: 0603-10 кОм±5%-0,062 Вт; R_0603_1608Metric
R26, R27, R32, R33: 0603-1 кОм±5%-0,062 Вт; R_0603_1608Metric
TP12, TP14, TP16, TP18, TP20, TP22, TP24, TP26, TP28, TP30, TP32, TP34, TP38, TP40: TestPoint; TestPoint_Pad_D1.0mm
U6: PAI162M30 (SOIC-16); SOIC-16_3.9x9.9mm_P1.27mm

Connections of its further copies:
+3V3: C30.2, U6.1 (VDD1); also elsewhere on the board
/+5V: C31.1, U6.16 (VDD2); also elsewhere on the board
/+24_INNER: C23.1, C29.2, C36.2, C41.1, C42.1, D8.1 (K), D10.1 (K), Q4.7, Q5.7; also elsewhere on the board
/Back_1: TP16.1, U6.4 (VIC); also elsewhere on the board
/Enable_1: TP12.1, U6.2 (VIA), U6.5 (VID); also elsewhere on the board
/Forward_1: TP14.1, U6.3 (VIB); also elsewhere on the board
/IS1_1: TP20.1, U6.7 (VOF); also elsewhere on the board
/IS2_1: TP18.1, U6.6 (VOE); also elsewhere on the board
GND2: C16.1, C23.2, C31.2, C32.1, C33.1, C34.1, C37.1, C41.2, C42.2, C45.2, C46.1, D6.2 (A), D12.2 (A), Q4.1, Q5.1, R22.2, R23.1, R26.1, R27.1, R28.2, R29.1, R32.1, R33.1, TP40.1, U6.9 (GND2); also elsewhere on the board
GNDD: C30.1, C45.1, U6.8 (GND1); also elsewhere on the board
unnamed: C29.1, C32.2, D6.1 (K), D8.2 (A), J4.1, Q4.4, Q4.8, TP34.1
unnamed: C36.1, C37.2, D10.2 (A), D12.1 (K), J4.2, Q5.4, Q5.8, TP38.1
unnamed: Q4.2 (IN), R23.2, R25.1, TP24.1
unnamed: Q4.3 (INH), R22.1, R24.2, TP22.1
unnamed: C33.2, Q4.6 (IS), R26.2, TP26.1, U6.10 (VIF)
unnamed: C16.2, Q4.5 (SR), R27.2
unnamed: Q5.2 (IN), R29.2, R31.1, TP32.1
unnamed: Q5.3 (INH), R28.1, R30.2, TP30.1
unnamed: C46.2, Q5.6 (IS), R32.2, TP28.1, U6.11 (VIE)
unnamed: C34.2, Q5.5 (SR), R33.2
unnamed: R30.1, U6.15 (VOA)
unnamed: R31.2, U6.14 (VOB)
unnamed: R25.2, U6.13 (VOC)
unnamed: R24.1, U6.12 (VOD)

Notes on the sheet:
доп защита от напряжения самоиндукции

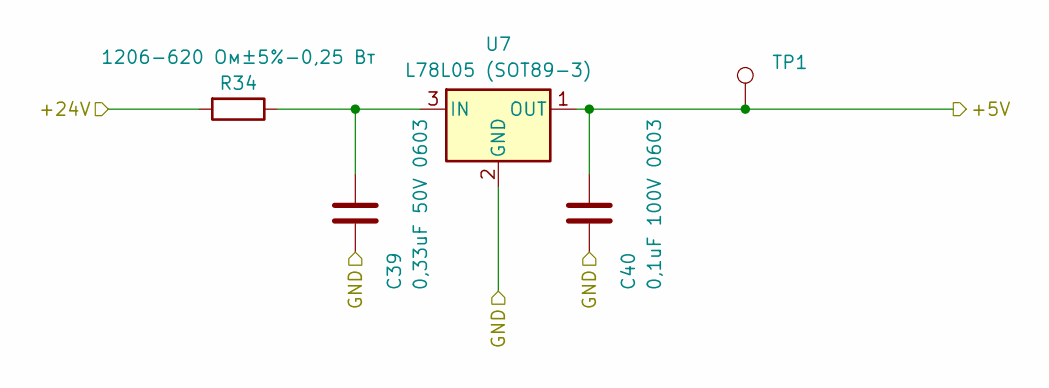
[picture p10: schematic Supply_Voltage_5V.kicad_sch]

Parts:
C39: 0,33uF 50V 0603; C_0603_1608Metric_Pad1.08x0.95mm_HandSolder
C40: 0,1uF 100V 0603; C_0603_1608Metric
R34: 1206-620 Ом±5%-0,25 Вт; R_1206_3216Metric
TP1: TestPoint; TestPoint_Pad_D1.0mm
U7: L78L05 (SOT89-3); SOT-89-3

Connections:
/+5V: C40.1, TP1.1, U7.1 (OUT); also elsewhere on the board
/+24_INNER: R34.2; also elsewhere on the board
GND2: C39.2, C40.2, U7.2 (GND); also elsewhere on the board
unnamed: C39.1, R34.1, U7.3 (IN)
