borzeman/PzbElectronics/dc_motor_board/dc_motor_board.kicad_pcb

## KiCad design dc_motor_board/dc_motor_board.kicad_pcb (continued)

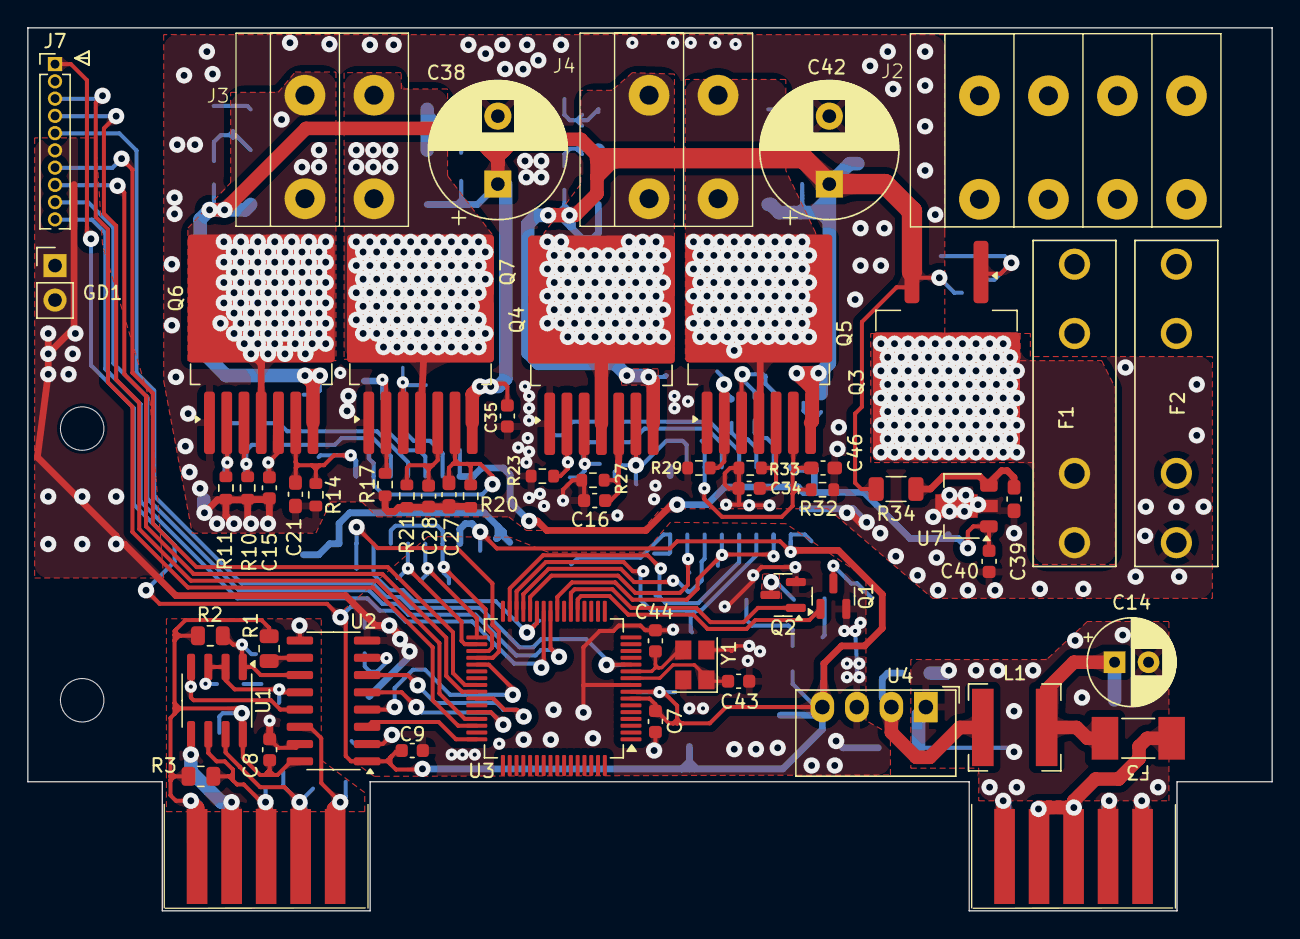
[picture p11: board dc_motor_board.kicad_pcb from above]

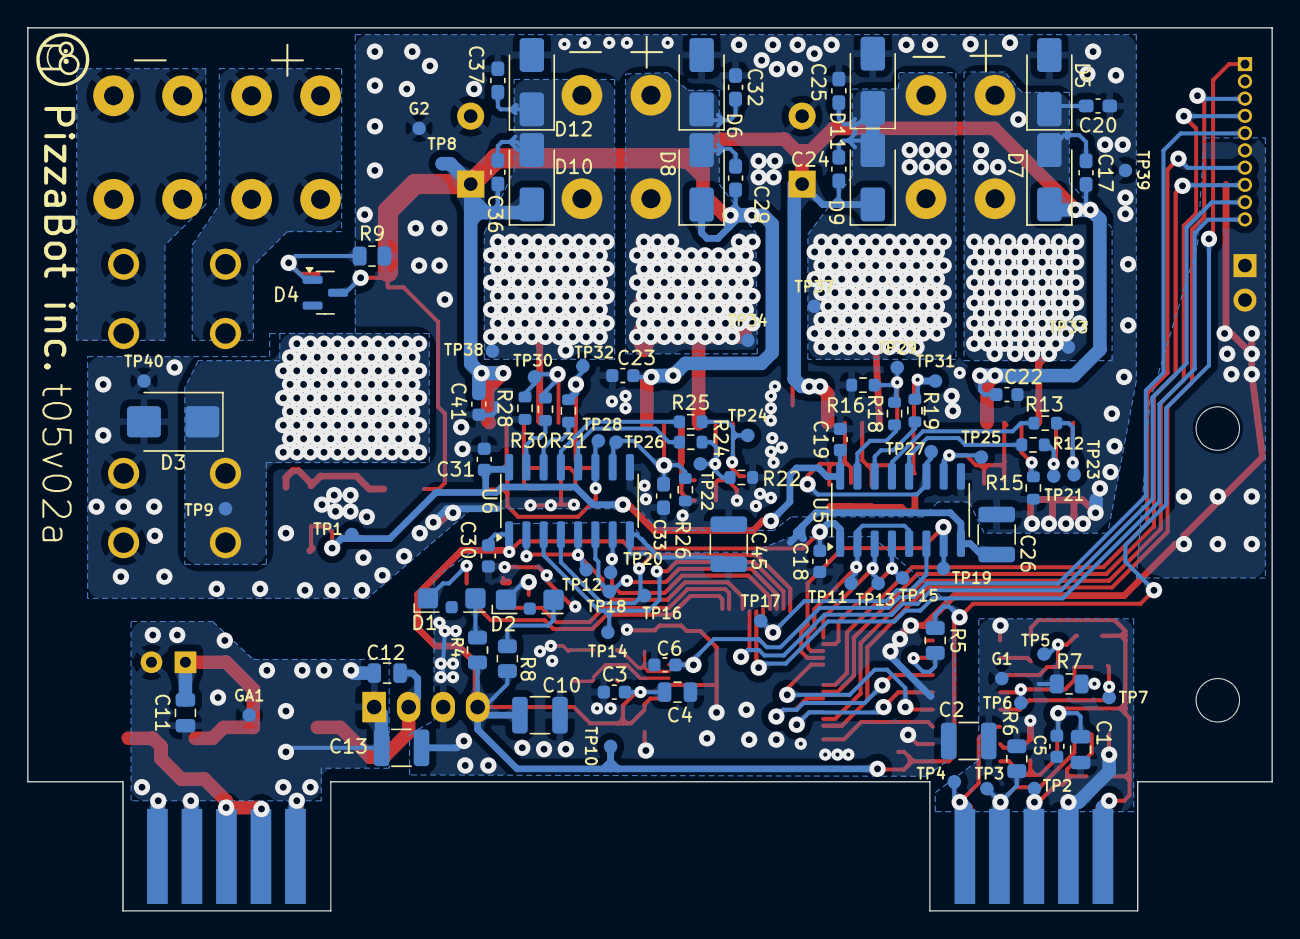
[picture p12: board dc_motor_board.kicad_pcb from below]

Board: 2 copper layers, 91.6 x 65.0 mm, 161 parts (102 on the bottom side), 81 nets.
