borzeman/PzbElectronics/step_motor_board/step_motor_board.kicad_pcb

## KiCad design step_motor_board/step_motor_board.kicad_pcb (2025-10-31)

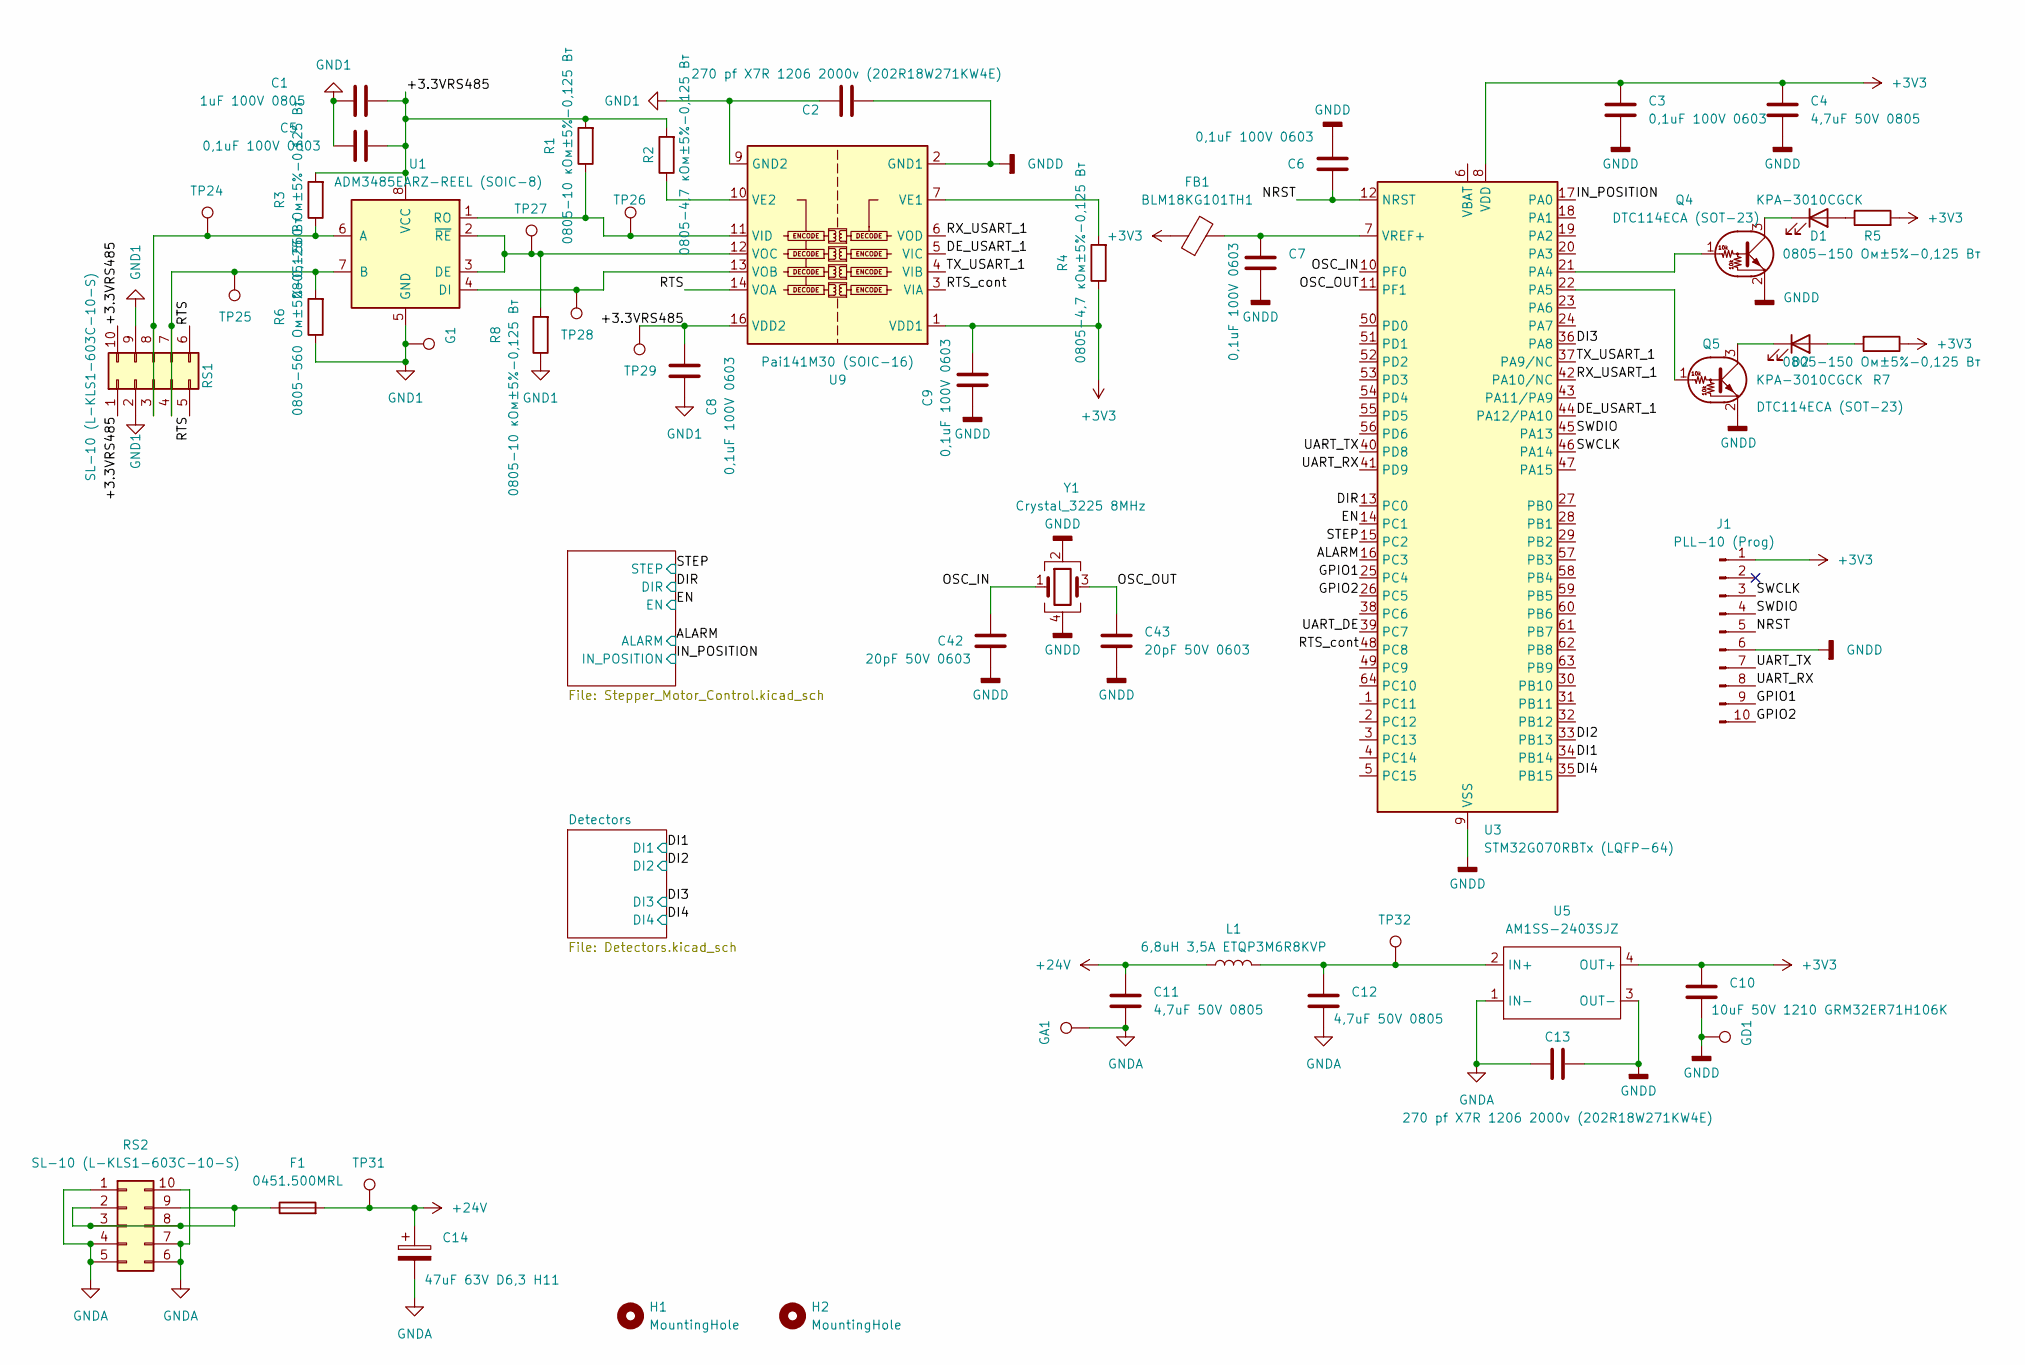
[picture p13: schematic step_motor_board.kicad_sch]

Parts:
C1: 1uF 100V 0805; C_0805_2012Metric
C2, C13: 270 pf X7R 1206 2000v (202R18W271KW4E); C_1210_3225Metric
C3, C5, C6, C7, C8, C9: 0,1uF 100V 0603; C_0603_1608Metric
C4, C11, C12: 4,7uF 50V 0805; C_0805_2012Metric
C10: 10uF 50V 1210 GRM32ER71H106K; C_1210_3225Metric
C14: 47uF 63V D6,3 H11; CP_Radial_D6.3mm_P2.50mm
C42, C43: 20pF 50V 0603; C_0603_1608Metric
D1, D2: KPA-3010CGCK; LED_Kingbright_KPA-3010_3x2x1mm
F1: 0451.500MRL; Fuse_Littelfuse-NANO2-451_453
FB1: BLM18KG101TH1; L_0603_1608Metric
G1: TestPoint; TestPoint_Pad_D1.0mm
GA1: TestPoint; TestPoint_Pad_D1.0mm
GD1: TestPoint; TestPoint_Pad_D1.0mm
H1, H2: MountingHole; MountingHole_3.2mm_M3
J1: PLL-10 (Prog); PinHeader_1x10_P1.27mm_Vertical
L1: 6,8uH 3,5A ETQP3M6R8KVP; L_Bourns-SRN6028
Q4, Q5: DTC114ECA (SOT-23); SOT-23
R1, R8: 0805-10 кОм±5%-0,125 Вт; R_0805_2012Metric
R2, R4: 0805-4,7 кОм±5%-0,125 Вт; R_0805_2012Metric
R3, R6: 0805-560 Ом±5%-0,125 Вт; R_0805_2012Metric
R5, R7: 0805-150 Ом±5%-0,125 Вт; R_0805_2012Metric
RS1, RS2: SL-10 (L-KLS1-603C-10-S); Edge_Conn_KLS1-603-10
TP24, TP25, TP26, TP27, TP28, TP29, TP31, TP32: TestPoint; TestPoint_Pad_D1.0mm
U1: ADM3485EARZ-REEL (SOIC-8); SOIC-8_3.9x4.9mm_P1.27mm
U3: STM32G070RBTx (LQFP-64); LQFP-64_10x10mm_P0.5mm
U5: AM1SS-2403SJZ; Converter_DCDC_Murata_MEE1SxxxxSC_THT
U9: Pai141M30 (SOIC-16); SOIC-16_3.9x9.9mm_P1.27mm
Y1: Crystal_3225 8MHz; Crystal_SMD_3225-4Pin_3.2x2.5mm

Connections:
+3V3: C3.1, C4.1, C9.2, C10.1, FB1.1, J1.1, R4.1, R5.2, R7.1, U3.8 (VDD), U5.4 (OUT+), U9.1 (VDD1); also elsewhere on the board
+24V: C11.1, C14.1, F1.2, L1.1, TP31.1; also elsewhere on the board
/+3.3VRS485: C1.2, C5.2, C8.2, R1.2, R2.2, R3.2, RS1.1, RS1.10, TP29.1, U1.8 (VCC), U9.16 (VDD2)
/ALARM: U3.16 (PC3); also elsewhere on the board
/DE_USART_1: U3.44 (PA12/PA10), U9.5 (VIC)
/DI1: U3.33 (PB13); also elsewhere on the board
/DI2: U3.34 (PB14); also elsewhere on the board
/DI3: U3.36 (PA8); also elsewhere on the board
/DI4: U3.35 (PB15); also elsewhere on the board
/DIR: U3.13 (PC0); also elsewhere on the board
/EN: U3.14 (PC1); also elsewhere on the board
/GPIO1: J1.9, U3.25 (PC4)
/GPIO2: J1.10, U3.26 (PC5)
/IN_POSITION: U3.17 (PA0); also elsewhere on the board
/NRST: C6.1, J1.5, U3.12 (NRST)
/OSC_IN: C42.1, U3.10 (PF0), Y1.1
/OSC_OUT: C43.1, U3.11 (PF1), Y1.3
/RTS: RS1.5, RS1.6, U9.14 (VOA)
/RTS_cont: U3.48 (PC8), U9.3 (VIA)
/RX_USART_1: U3.42 (PA10/NC), U9.6 (VOD)
/STEP: U3.15 (PC2); also elsewhere on the board
/SWCLK: J1.3, U3.46 (PA14)
/SWDIO: J1.4, U3.45 (PA13)
/TX_USART_1: U3.37 (PA9/NC), U9.4 (VIB)
/UART_DE: U3.39 (PC7)
/UART_RX: J1.8, U3.41 (PD9)
/UART_TX: J1.7, U3.40 (PD8)
GND1: C1.1, C2.1, C5.1, C8.1, G1.1, R6.1, R8.1, RS1.2, RS1.9, U1.5 (GND), U9.9 (GND2), U9.15 (GND2)
GNDA: C11.2, C12.2, C13.1, C14.2, GA1.1, RS2.1, RS2.4, RS2.5, RS2.6, RS2.7, RS2.10, U5.1 (IN-); also elsewhere on the board
GNDD: C2.2, C3.2, C4.2, C6.2, C7.2, C9.1, C10.2, C13.2, C42.2, C43.2, GD1.1, J1.6, Q4.2 (E), Q5.2 (E), U3.9 (VSS), U5.3 (OUT-), U9.2 (GND1), U9.8 (GND1), Y1.2, Y1.4; also elsewhere on the board
unnamed: D1.2 (A), R5.1
unnamed: D1.1 (K), Q4.3 (C)
unnamed: D2.2 (A), R7.2
unnamed: D2.1 (K), Q5.3 (C)
unnamed: Q4.1 (B), U3.21 (PA4)
unnamed: Q5.1 (B), U3.22 (PA5)
unnamed: R3.1, RS1.3, RS1.8, TP24.1, U1.6 (A)
unnamed: R6.2, RS1.4, RS1.7, TP25.1, U1.7 (B)
unnamed: F1.1, RS2.2, RS2.3, RS2.8, RS2.9
unnamed: R8.2, TP27.1, U1.2 (~RE), U1.3 (DE), U9.12 (VOC)
unnamed: TP28.1, U1.4 (DI), U9.13 (VOB)
unnamed: R1.1, TP26.1, U1.1 (RO), U9.11 (VID)
unnamed: C7.1, FB1.2, U3.7 (VREF+)
unnamed: C12.1, L1.2, TP32.1, U5.2 (IN+)
unnamed: R4.2, U9.7 (VE1)
unnamed: R2.1, U9.10 (VE2)

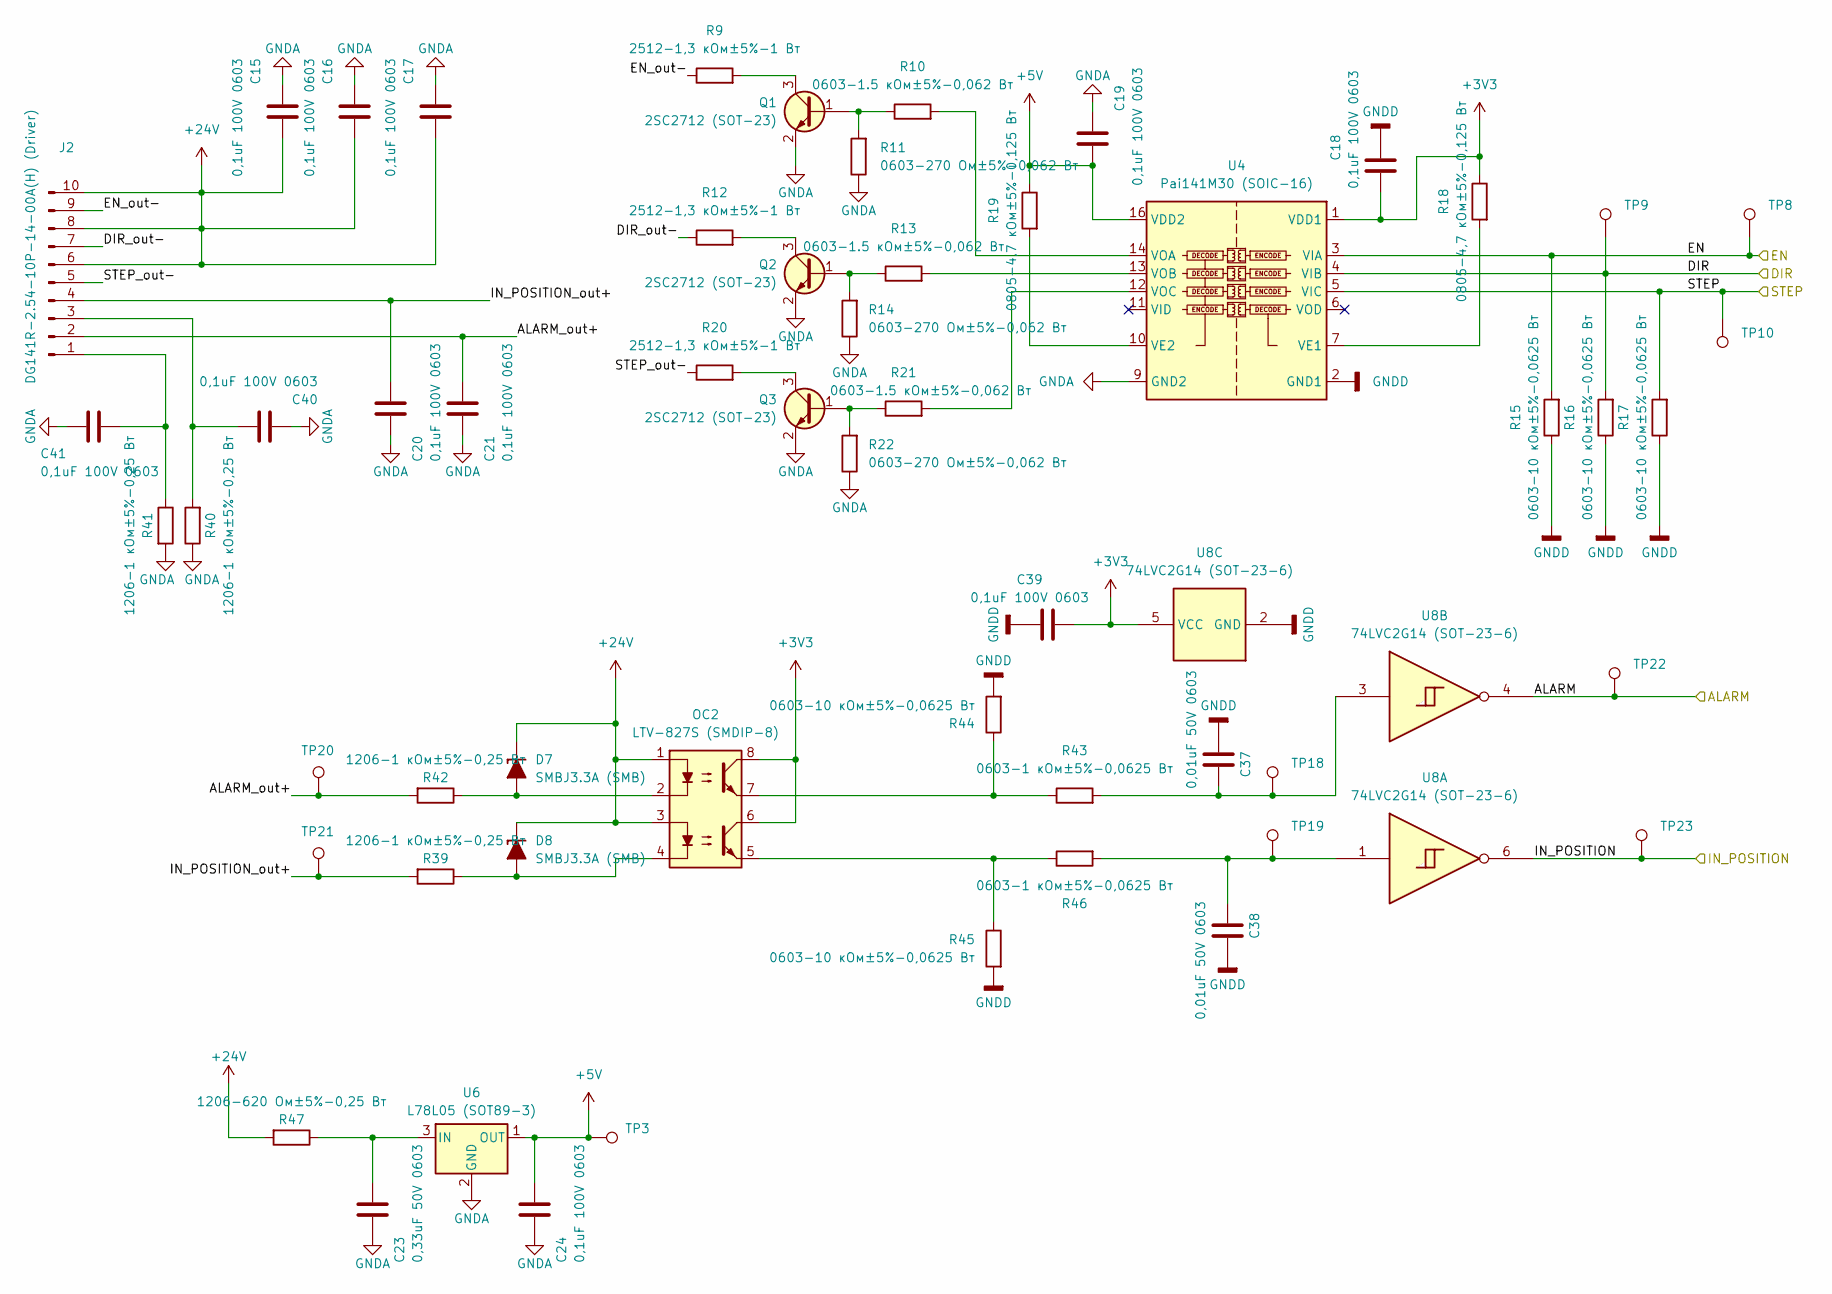
[picture p14: schematic Stepper_Motor_Control.kicad_sch]

Parts:
C15, C16, C17, C18, C19, C20, C21, C24, C39, C40, C41: 0,1uF 100V 0603; C_0603_1608Metric
C23: 0,33uF 50V 0603; C_0603_1608Metric
C37, C38: 0,01uF 50V 0603; C_0603_1608Metric
D7, D8: SMBJ3.3A (SMB); D_SMB
J2: DG141R-2.54-10P-14-00A(H) (Driver); DG141R-10
OC2: LTV-827S (SMDIP-8); SMDIP-8_W9.53mm
Q1, Q2, Q3: 2SC2712 (SOT-23); SOT-23
R9, R12, R20: 2512-1,3 кОм±5%-1 Вт; R_2512_6332Metric
R10, R13, R21: 0603-1.5 кОм±5%-0,062 Вт; R_0603_1608Metric
R11, R14, R22: 0603-270 Ом±5%-0,062 Вт; R_0603_1608Metric
R15, R16, R17, R44, R45: 0603-10 кОм±5%-0,0625 Вт; R_0603_1608Metric
R18, R19: 0805-4,7 кОм±5%-0,125 Вт; R_0805_2012Metric
R39, R40, R41, R42: 1206-1 кОм±5%-0,25 Вт; R_1206_3216Metric
R43, R46: 0603-1 кОм±5%-0,0625 Вт; R_0603_1608Metric
R47: 1206-620 Ом±5%-0,25 Вт; R_1206_3216Metric
TP3, TP8, TP9, TP10, TP18, TP19, TP20, TP21, TP22, TP23: TestPoint; TestPoint_Pad_D1.0mm
U4: Pai141M30 (SOIC-16); SOIC-16_3.9x9.9mm_P1.27mm
U6: L78L05 (SOT89-3); SOT-89-3
U8: 74LVC2G14 (SOT-23-6); SOT-23-6

Connections:
+3V3: C18.2, C39.2, OC2.6, OC2.8, R18.1, U4.1 (VDD1), U8.5 (VCC); also elsewhere on the board
+5V: C19.1, C24.1, R19.1, TP3.1, U4.16 (VDD2), U6.1 (OUT)
+24V: C15.1, C16.1, C17.1, D7.1 (K), D8.1 (K), J2.6, J2.8, J2.10, OC2.1, OC2.3, R47.2; also elsewhere on the board
/ALARM: TP22.1, U8.4; also elsewhere on the board
/DIR: R16.2, TP9.1, U4.4 (VIB); also elsewhere on the board
/EN: R15.2, TP8.1, U4.3 (VIA); also elsewhere on the board
/IN_POSITION: TP23.1, U8.6; also elsewhere on the board
/STEP: R17.2, TP10.1, U4.5 (VIC); also elsewhere on the board
/Stepper_Motor_Control/ALARM_out+: C21.1, J2.2, R42.2, TP20.1
/Stepper_Motor_Control/DIR_out-: J2.7, R12.1
/Stepper_Motor_Control/EN_out-: J2.9, R9.1
/Stepper_Motor_Control/IN_POSITION_out+: C20.1, J2.4, R39.2, TP21.1
/Stepper_Motor_Control/STEP_out-: J2.5, R20.1
GNDA: C15.2, C16.2, C17.2, C19.2, C20.2, C21.2, C23.2, C24.2, C40.2, C41.2, Q1.2 (E), Q2.2 (E), Q3.2 (E), R11.1, R14.1, R22.1, R40.1, R41.2, U4.9 (GND2), U4.15 (GND2), U6.2 (GND); also elsewhere on the board
GNDD: C18.1, C37.2, C38.2, C39.1, R15.1, R16.1, R17.1, R44.2, R45.2, U4.2 (GND1), U4.8 (GND1), U8.2 (GND); also elsewhere on the board
unnamed: C37.1, R43.2, TP18.1, U8.3
unnamed: C38.1, R46.2, TP19.1, U8.1
unnamed: D7.2 (A), OC2.2, R42.1
unnamed: D8.2 (A), OC2.4, R39.1
unnamed: C41.1, J2.1, R41.1
unnamed: C40.1, J2.3, R40.2
unnamed: OC2.5, R45.1, R46.1
unnamed: OC2.7, R43.1, R44.1
unnamed: Q1.1 (B), R10.1, R11.2
unnamed: Q1.3 (C), R9.2
unnamed: Q2.1 (B), R13.1, R14.2
unnamed: Q2.3 (C), R12.2
unnamed: Q3.1 (B), R21.1, R22.2
unnamed: Q3.3 (C), R20.2
unnamed: R18.2, U4.7 (VE1)
unnamed: R19.2, U4.10 (VE2)
unnamed: R10.2, U4.14 (VOA)
unnamed: R13.2, U4.13 (VOB)
unnamed: R21.2, U4.12 (VOC)
unnamed: C23.1, R47.1, U6.3 (IN)

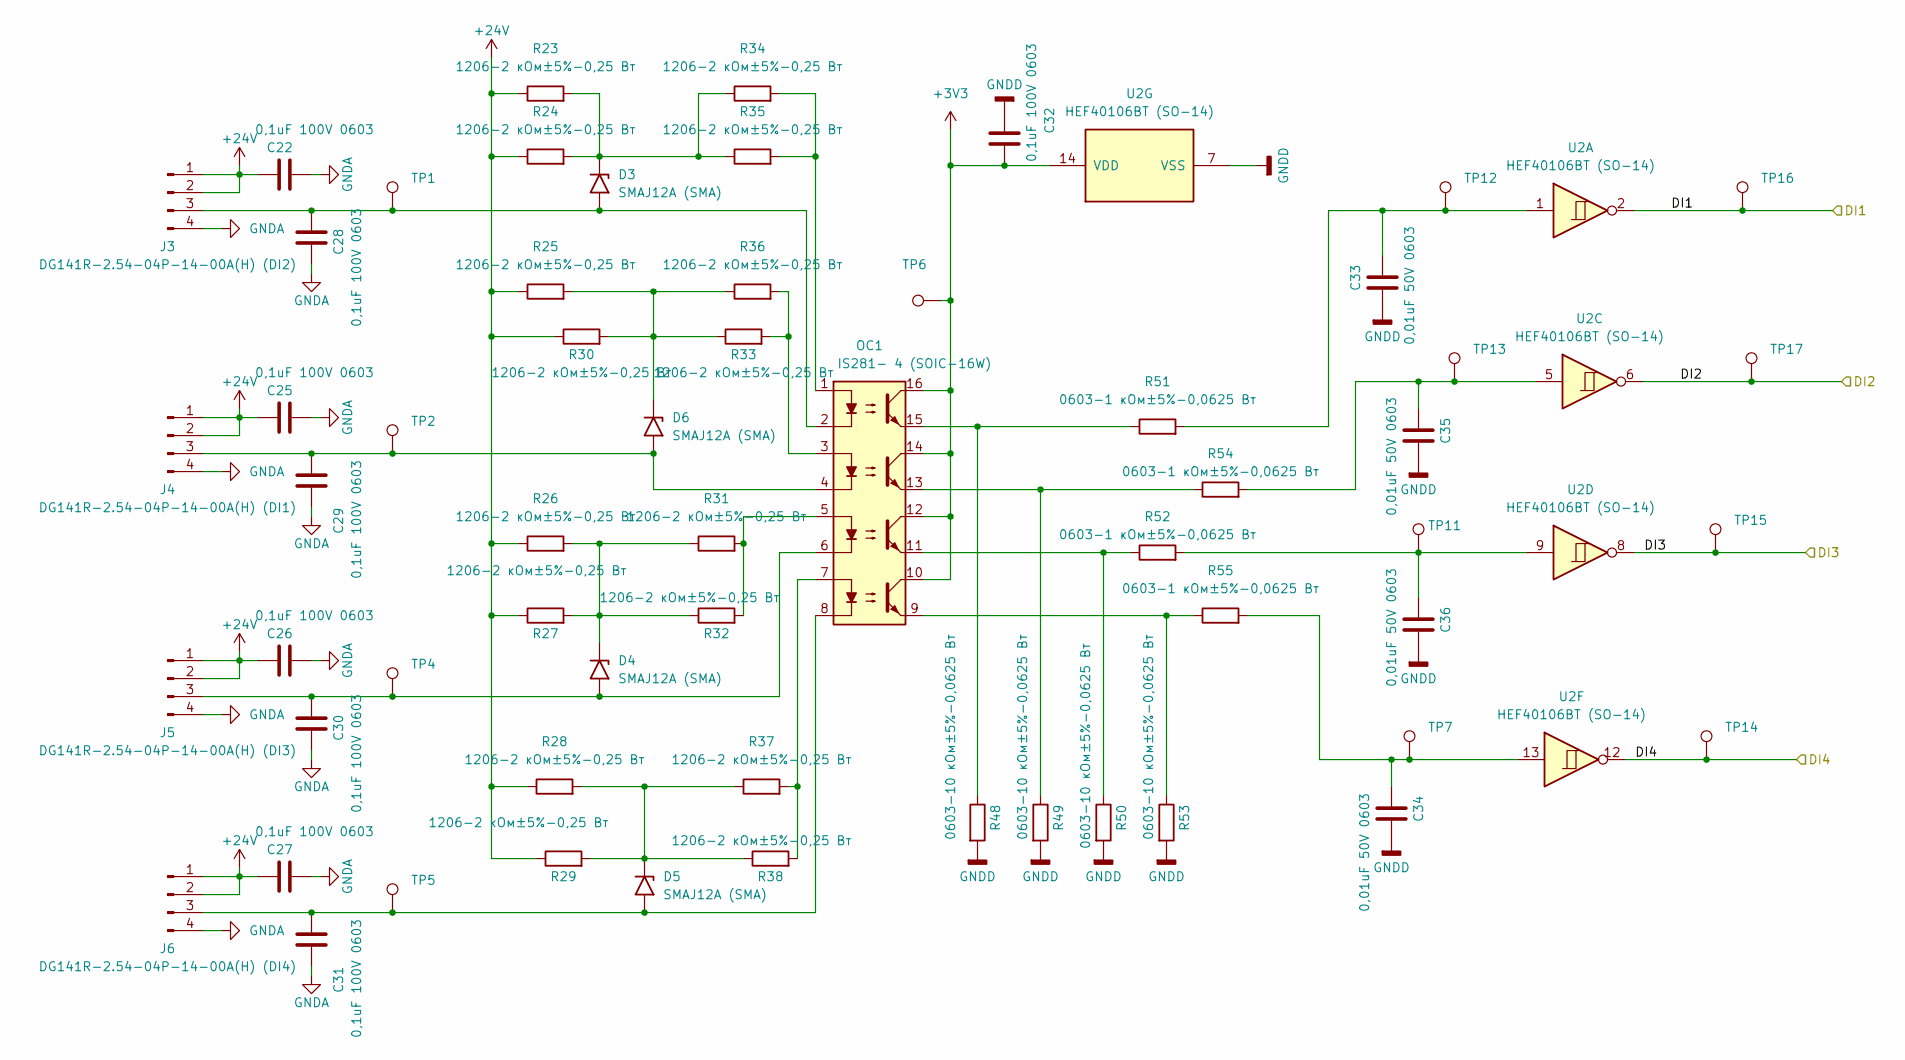
[picture p15: schematic Detectors.kicad_sch]

Parts:
C22, C25, C26, C27, C28, C29, C30, C31, C32: 0,1uF 100V 0603; C_0603_1608Metric
C33, C34, C35, C36: 0,01uF 50V 0603; C_0603_1608Metric
D3, D4, D5, D6: SMAJ12A (SMA); D_SMA
J3: DG141R-2.54-04P-14-00A(H) (DI2); DG141R-04
J4: DG141R-2.54-04P-14-00A(H) (DI1); DG141R-04
J5: DG141R-2.54-04P-14-00A(H) (DI3); DG141R-04
J6: DG141R-2.54-04P-14-00A(H) (DI4); DG141R-04
OC1: IS281- 4 (SOIC-16W); SOIC-16W_5.3x10.2mm_P1.27mm
R23, R24, R25, R26, R27, R28, R29, R30, R31, R32, R33, R34, R35, R36, R37, R38: 1206-2 кОм±5%-0,25 Вт; R_1206_3216Metric
R48, R49, R50, R53: 0603-10 кОм±5%-0,0625 Вт; R_0603_1608Metric
R51, R52, R54, R55: 0603-1 кОм±5%-0,0625 Вт; R_0603_1608Metric
TP1, TP2, TP4, TP5, TP6, TP7, TP11, TP12, TP13, TP14, TP15, TP16, TP17: TestPoint; TestPoint_Pad_D1.0mm
U2: HEF40106BT (SO-14); SO-14_5.3x10.2mm_P1.27mm

Connections:
+3V3: C32.2, OC1.10, OC1.12, OC1.14, OC1.16, TP6.1, U2.14 (VDD); also elsewhere on the board
+24V: C22.1, C25.1, C26.1, C27.1, J3.1, J3.2, J4.1, J4.2, J5.1, J5.2, J6.1, J6.2, R23.1, R24.1, R25.1, R26.1, R27.1, R28.1, R29.1, R30.1; also elsewhere on the board
/DI1: TP17.1, U2.6; also elsewhere on the board
/DI2: TP16.1, U2.2; also elsewhere on the board
/DI3: TP15.1, U2.8; also elsewhere on the board
/DI4: TP14.1, U2.12; also elsewhere on the board
GNDA: C22.2, C25.2, C26.2, C27.2, C28.2, C29.2, C30.2, C31.2, J3.4, J4.4, J5.4, J6.4; also elsewhere on the board
GNDD: C32.1, C33.2, C34.2, C35.2, C36.2, R48.2, R49.2, R50.2, R53.2, U2.7 (VSS); also elsewhere on the board
unnamed: C33.1, R51.2, TP12.1, U2.1
unnamed: C34.1, R55.2, TP7.1, U2.13
unnamed: C35.1, R54.2, TP13.1, U2.5
unnamed: C36.1, R52.2, TP11.1, U2.9
unnamed: D3.1 (A1), R23.2, R24.2, R34.1, R35.1
unnamed: C28.1, D3.2 (A2), J3.3, OC1.2, TP1.1
unnamed: D4.1 (A1), R26.2, R27.2, R31.1, R32.1
unnamed: C30.1, D4.2 (A2), J5.3, OC1.6, TP4.1
unnamed: D5.1 (A1), R28.2, R29.2, R37.1, R38.1
unnamed: C31.1, D5.2 (A2), J6.3, OC1.8, TP5.1
unnamed: D6.1 (A1), R25.2, R30.2, R33.1, R36.1
unnamed: C29.1, D6.2 (A2), J4.3, OC1.4, TP2.1
unnamed: OC1.1, R34.2, R35.2
unnamed: OC1.3, R33.2, R36.2
unnamed: OC1.5, R31.2, R32.2
unnamed: OC1.7, R37.2, R38.2
unnamed: OC1.9, R53.1, R55.1
unnamed: OC1.11, R50.1, R52.1
unnamed: OC1.13, R49.1, R54.1
unnamed: OC1.15, R48.1, R51.1

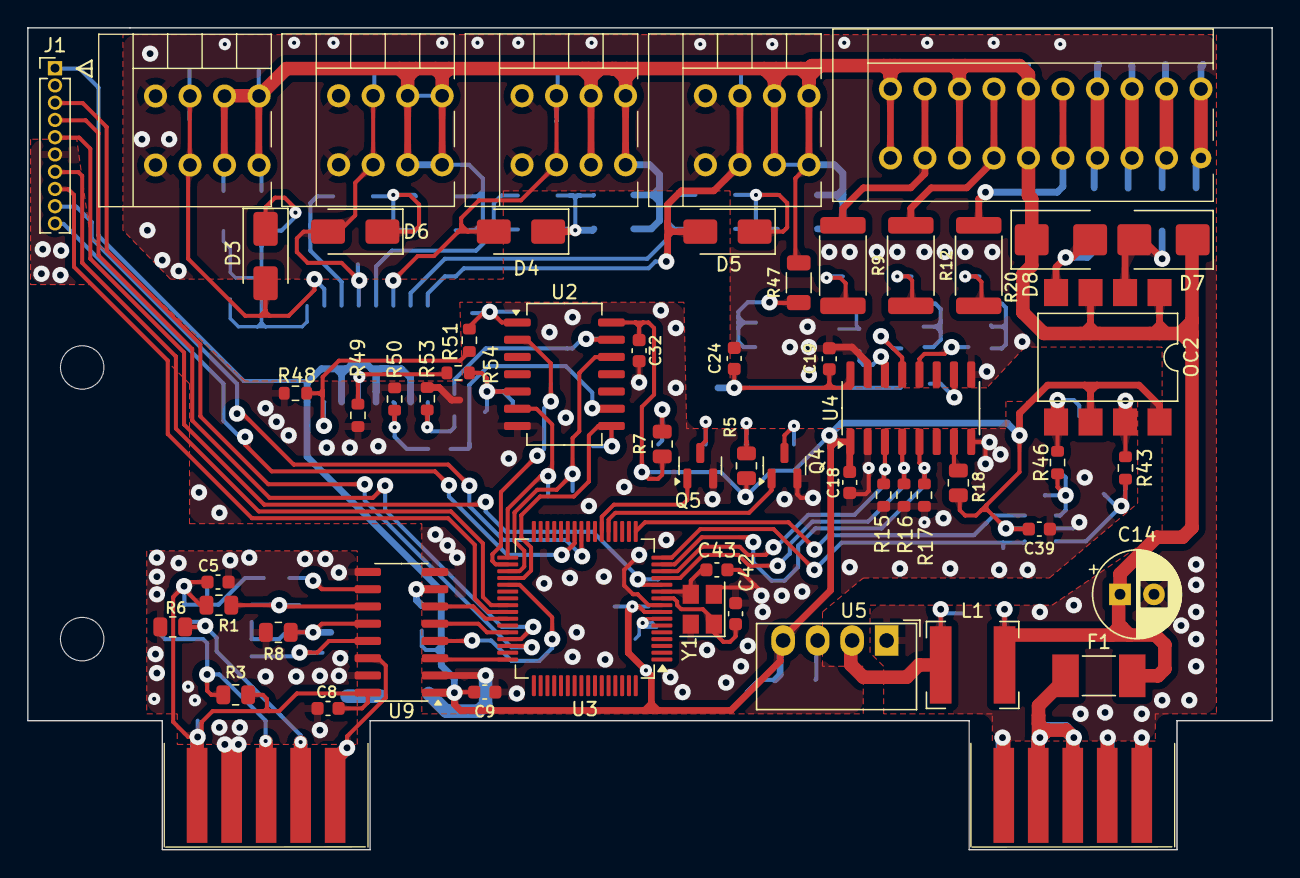
[picture p16: board step_motor_board.kicad_pcb from above]

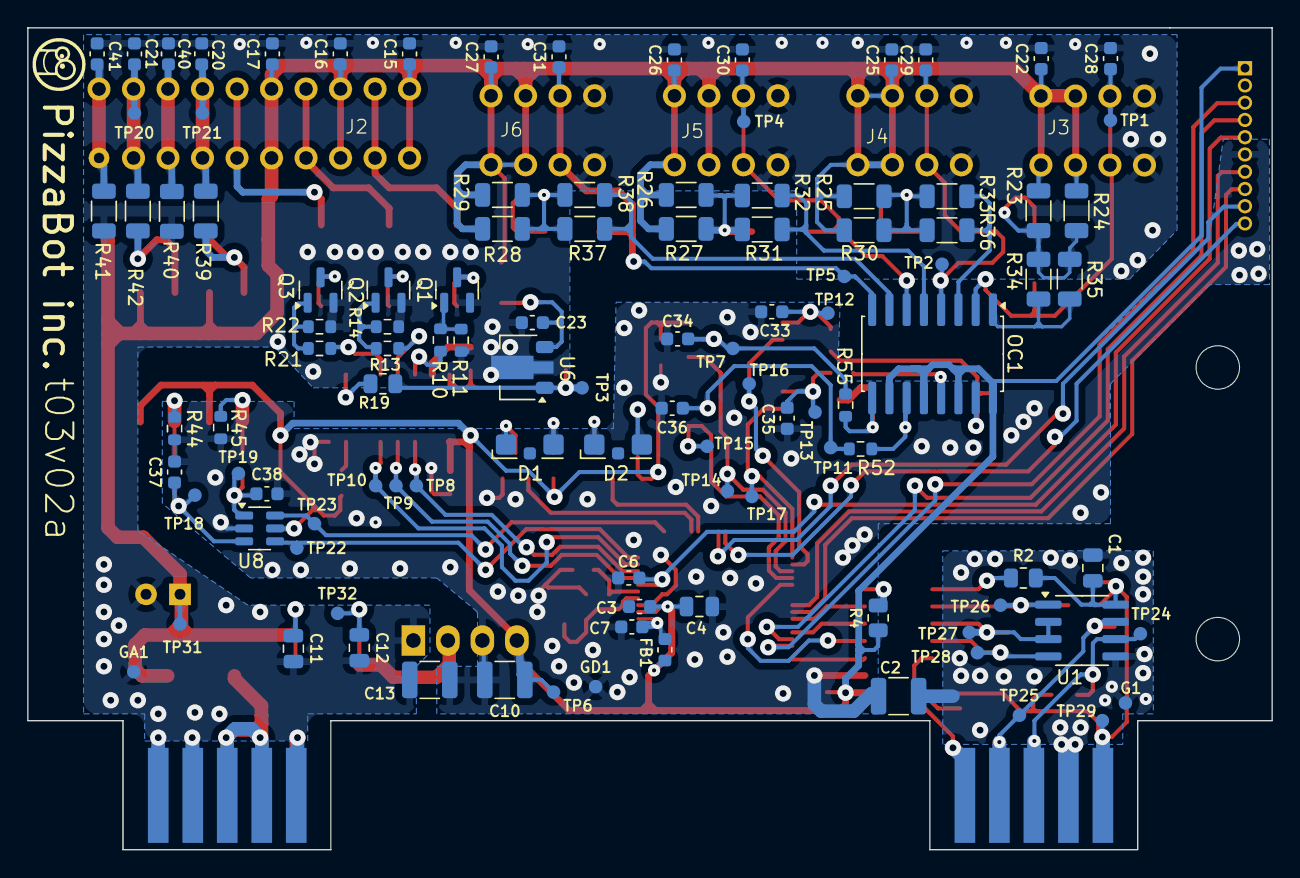
[picture p17: board step_motor_board.kicad_pcb from below]

Board: 2 copper layers, 91.6 x 60.5 mm, 169 parts (109 on the bottom side), 91 nets.
