borzeman/PzbElectronics/digit_in_board/digit_in_board.kicad_pcb

## KiCad design digit_in_board/digit_in_board.kicad_pcb (2025-10-31)

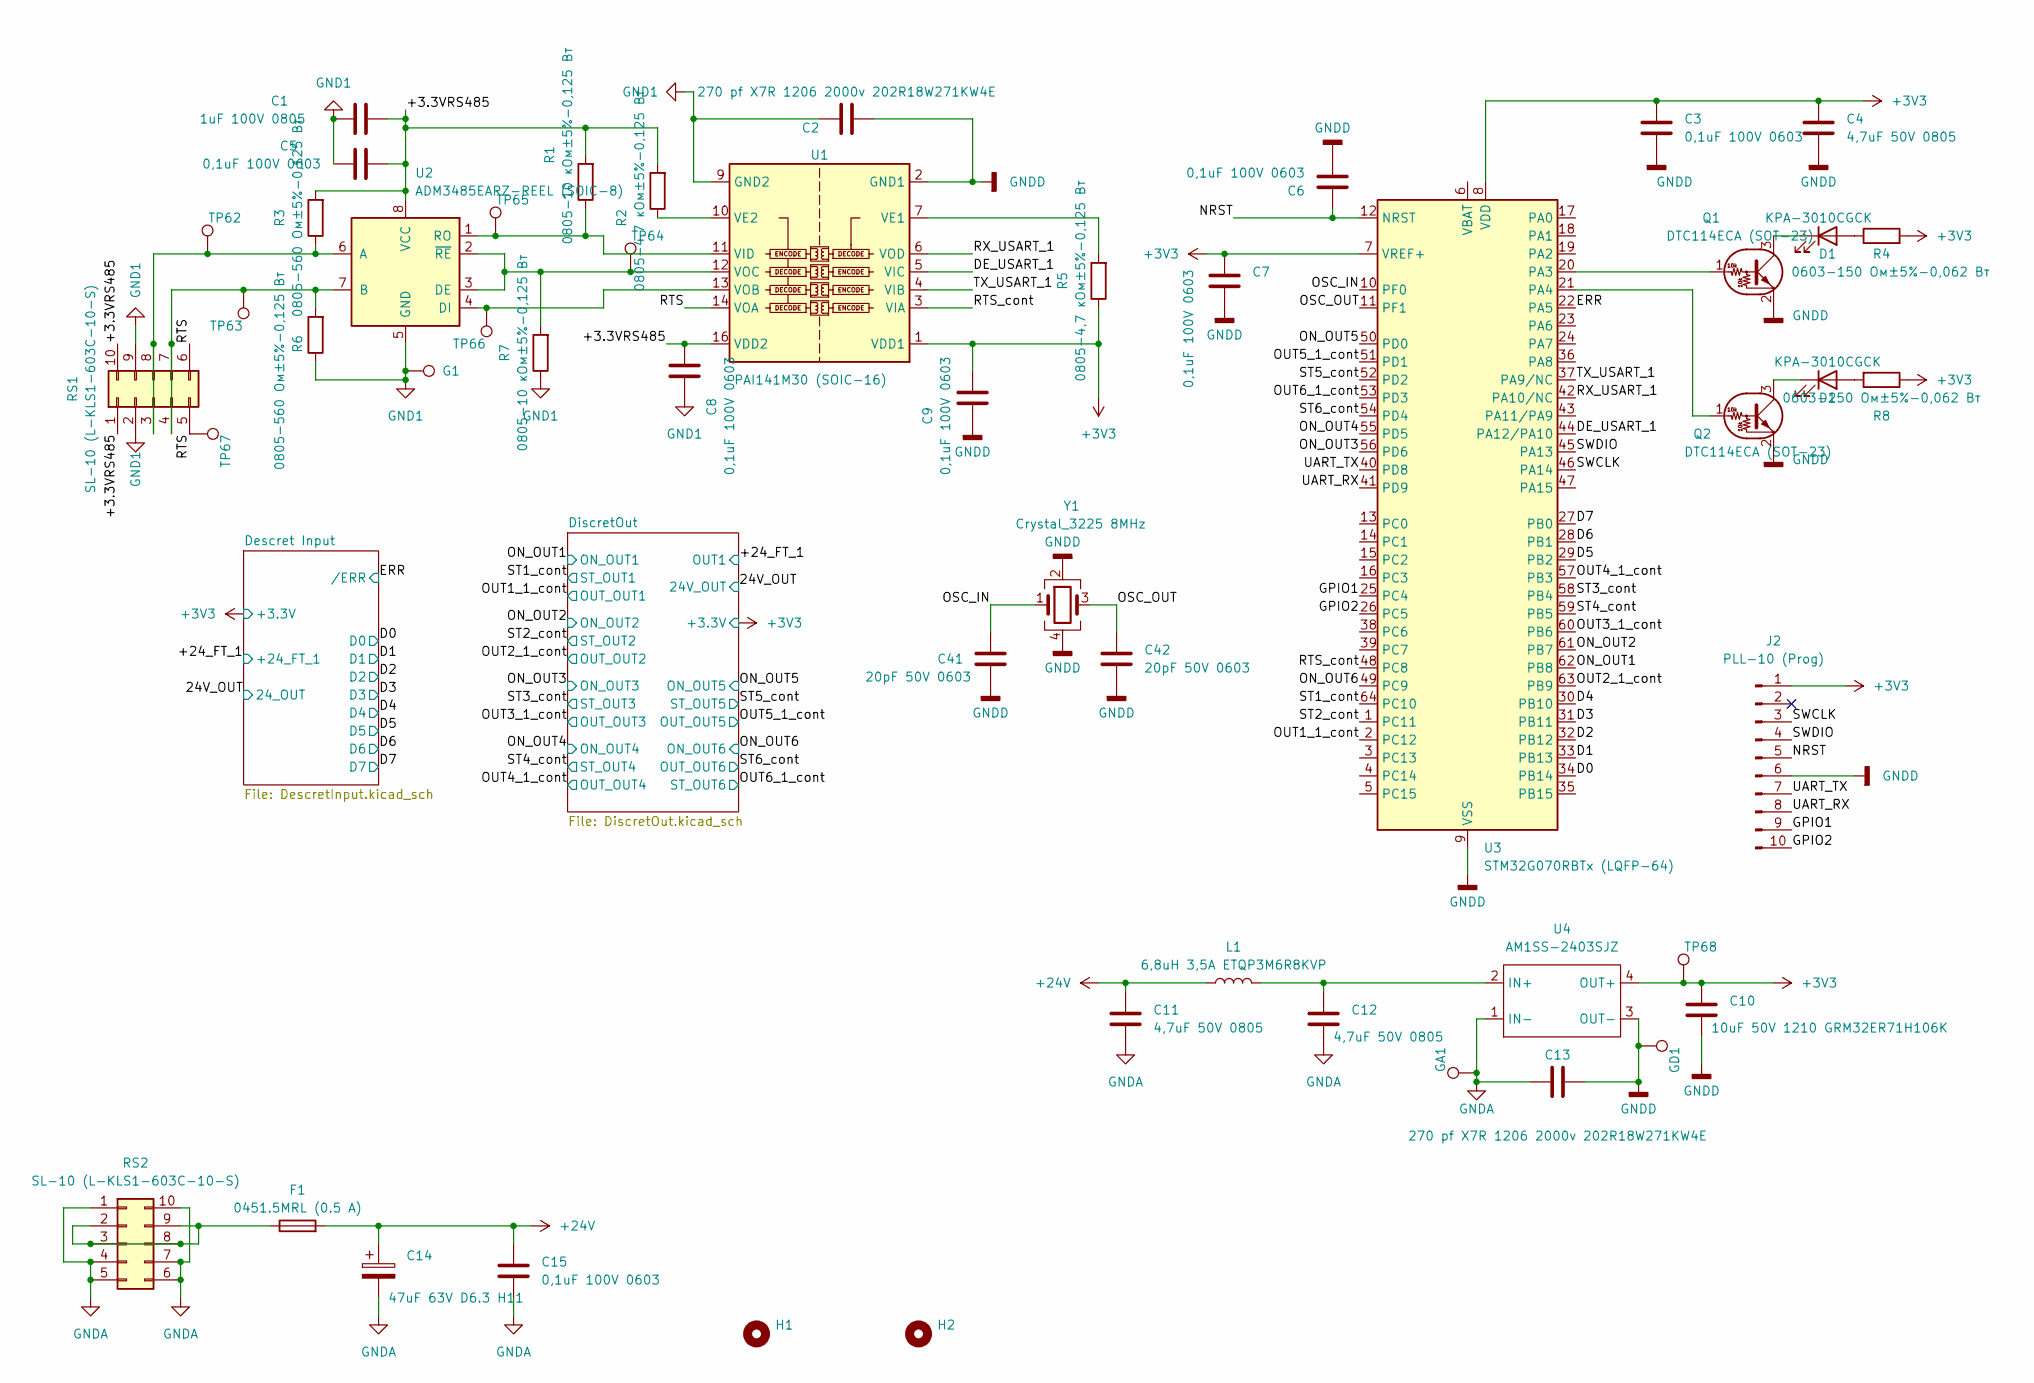
[picture p18: schematic digit_in_board.kicad_sch]

Parts:
C1: 1uF 100V 0805; C_0805_2012Metric_Pad1.18x1.45mm_HandSolder
C2, C13: 270 pf X7R 1206 2000v 202R18W271KW4E; C_1210_3225Metric_Pad1.42x2.65mm
C3, C5, C6, C7, C8, C9, C15: 0,1uF 100V 0603; C_0603_1608Metric
C4, C11, C12: 4,7uF 50V 0805; C_0805_2012Metric_Pad1.18x1.45mm_HandSolder
C10: 10uF 50V 1210 GRM32ER71H106K; C_1210_3225Metric_Pad1.42x2.65mm_HandSolder
C14: 47uF 63V D6.3 H11; CP_Radial_D6.3mm_P2.50mm
C41, C42: 20pF 50V 0603; C_0603_1608Metric
D1, D2: KPA-3010CGCK; LED_Kingbright_KPA-3010_3x2x1mm
F1: 0451.5MRL (0.5 А); Fuse_Littelfuse-NANO2-451_453
G1: TestPoint_D1
GA1: TestPoint_D1
GD1: TestPoint_D1
H1, H2: MountingHole; MountingHole_3.2mm_M3
J2: PLL-10 (Prog); PinHeader_1x10_P1.27mm_Vertical
L1: 6,8uH 3,5A ETQP3M6R8KVP; L_Bourns-SRN6028
Q1, Q2: DTC114ECA (SOT-23); SOT-23
R1, R7: 0805-10 кОм±5%-0,125 Вт; R_0805_2012Metric
R2, R5: 0805-4,7 кОм±5%-0,125 Вт; R_0805_2012Metric
R3, R6: 0805-560 Ом±5%-0,125 Вт; R_0805_2012Metric
R4, R8: 0603-150 Ом±5%-0,062 Вт; R_0603
RS1, RS2: SL-10 (L-KLS1-603C-10-S); Edge_Conn_KLS1-603-10
TP62, TP63, TP64, TP65, TP66, TP67, TP68: TestPoint_D1
U1: PAI141M30 (SOIC-16); SOIC-16_3.9x9.9mm_P1.27mm
U2: ADM3485EARZ-REEL (SOIC-8); SOIC-8_3.9x4.9mm_P1.27mm
U3: STM32G070RBTx (LQFP-64); LQFP-64_10x10mm_P0.5mm
U4: AM1SS-2403SJZ; Converter_DCDC_Murata_MEE1SxxxxSC_THT
Y1: Crystal_3225 8MHz; Crystal_SMD_3225-4Pin_3.2x2.5mm

Connections:
+3V3: C3.1, C4.1, C7.1, C9.2, C10.1, J2.1, R4.2, R5.1, R8.1, TP68.1, U1.1 (VDD1), U3.7 (VREF+), U3.8 (VDD), U4.4 (OUT+); also elsewhere on the board
/+3.3VRS485: C1.2, C5.2, C8.2, R1.2, R2.2, R3.2, RS1.1, RS1.10, U1.16 (VDD2), U2.8 (VCC)
/D0: U3.34 (PB14); also elsewhere on the board
/D1: U3.33 (PB13); also elsewhere on the board
/D2: U3.32 (PB12); also elsewhere on the board
/D3: U3.31 (PB11); also elsewhere on the board
/D4: U3.30 (PB10); also elsewhere on the board
/D5: U3.29 (PB2); also elsewhere on the board
/D6: U3.28 (PB1); also elsewhere on the board
/D7: U3.27 (PB0); also elsewhere on the board
/DE_USART_1: U1.5 (VIC), U3.44 (PA12/PA10)
/ERR: U3.22 (PA5); also elsewhere on the board
/GPIO1: J2.9, U3.25 (PC4)
/GPIO2: J2.10, U3.26 (PC5)
/NRST: C6.1, J2.5, U3.12 (NRST)
/ON_OUT1: U3.62 (PB8); also elsewhere on the board
/ON_OUT2: U3.61 (PB7); also elsewhere on the board
/ON_OUT3: U3.56 (PD6); also elsewhere on the board
/ON_OUT4: U3.55 (PD5); also elsewhere on the board
/ON_OUT5: U3.50 (PD0); also elsewhere on the board
/ON_OUT6: U3.49 (PC9); also elsewhere on the board
/OSC_IN: C41.1, U3.10 (PF0), Y1.1
/OSC_OUT: C42.1, U3.11 (PF1), Y1.3
/OUT1_1_cont: U3.2 (PC12); also elsewhere on the board
/OUT2_1_cont: U3.63 (PB9); also elsewhere on the board
/OUT3_1_cont: U3.60 (PB6); also elsewhere on the board
/OUT4_1_cont: U3.57 (PB3); also elsewhere on the board
/OUT5_1_cont: U3.51 (PD1); also elsewhere on the board
/OUT6_1_cont: U3.53 (PD3); also elsewhere on the board
/RTS: RS1.5, RS1.6, TP67.1, U1.14 (VOA)
/RTS_cont: U1.3 (VIA), U3.48 (PC8)
/RX_USART_1: U1.6 (VOD), U3.42 (PA10/NC)
/ST1_cont: U3.64 (PC10); also elsewhere on the board
/ST2_cont: U3.1 (PC11); also elsewhere on the board
/ST3_cont: U3.58 (PB4); also elsewhere on the board
/ST4_cont: U3.59 (PB5); also elsewhere on the board
/ST5_cont: U3.52 (PD2); also elsewhere on the board
/ST6_cont: U3.54 (PD4); also elsewhere on the board
/SWCLK: J2.3, U3.46 (PA14)
/SWDIO: J2.4, U3.45 (PA13)
/TX_USART_1: U1.4 (VIB), U3.37 (PA9/NC)
/UART_RX: J2.8, U3.41 (PD9)
/UART_TX: J2.7, U3.40 (PD8)
GNDA: C11.2, C12.2, C13.1, C14.2, C15.2, GA1.1, RS2.1, RS2.4, RS2.5, RS2.6, RS2.7, RS2.10, U4.1 (IN-)
unnamed: D1.2 (A), R4.1
unnamed: D1.1 (K), Q1.3 (C)
unnamed: D2.2 (A), R8.2
unnamed: Q1.1 (B), U3.20 (PA3)
unnamed: R3.1, RS1.3, RS1.8, TP62.1, U2.6 (A)
unnamed: R6.2, RS1.4, RS1.7, TP63.1, U2.7 (B)
unnamed: R5.2, U1.7 (VE1)
unnamed: R2.1, U1.10 (VE2)
unnamed: R1.1, TP65.1, U1.11 (VID), U2.1 (RO)
unnamed: TP66.1, U1.13 (VOB), U2.4 (DI)
unnamed: C12.1, L1.2, U4.2 (IN+)
