borzeman/PzbElectronics/digit_in_board/digit_in_board.kicad_pcb

## KiCad design digit_in_board/digit_in_board.kicad_pcb (continued)

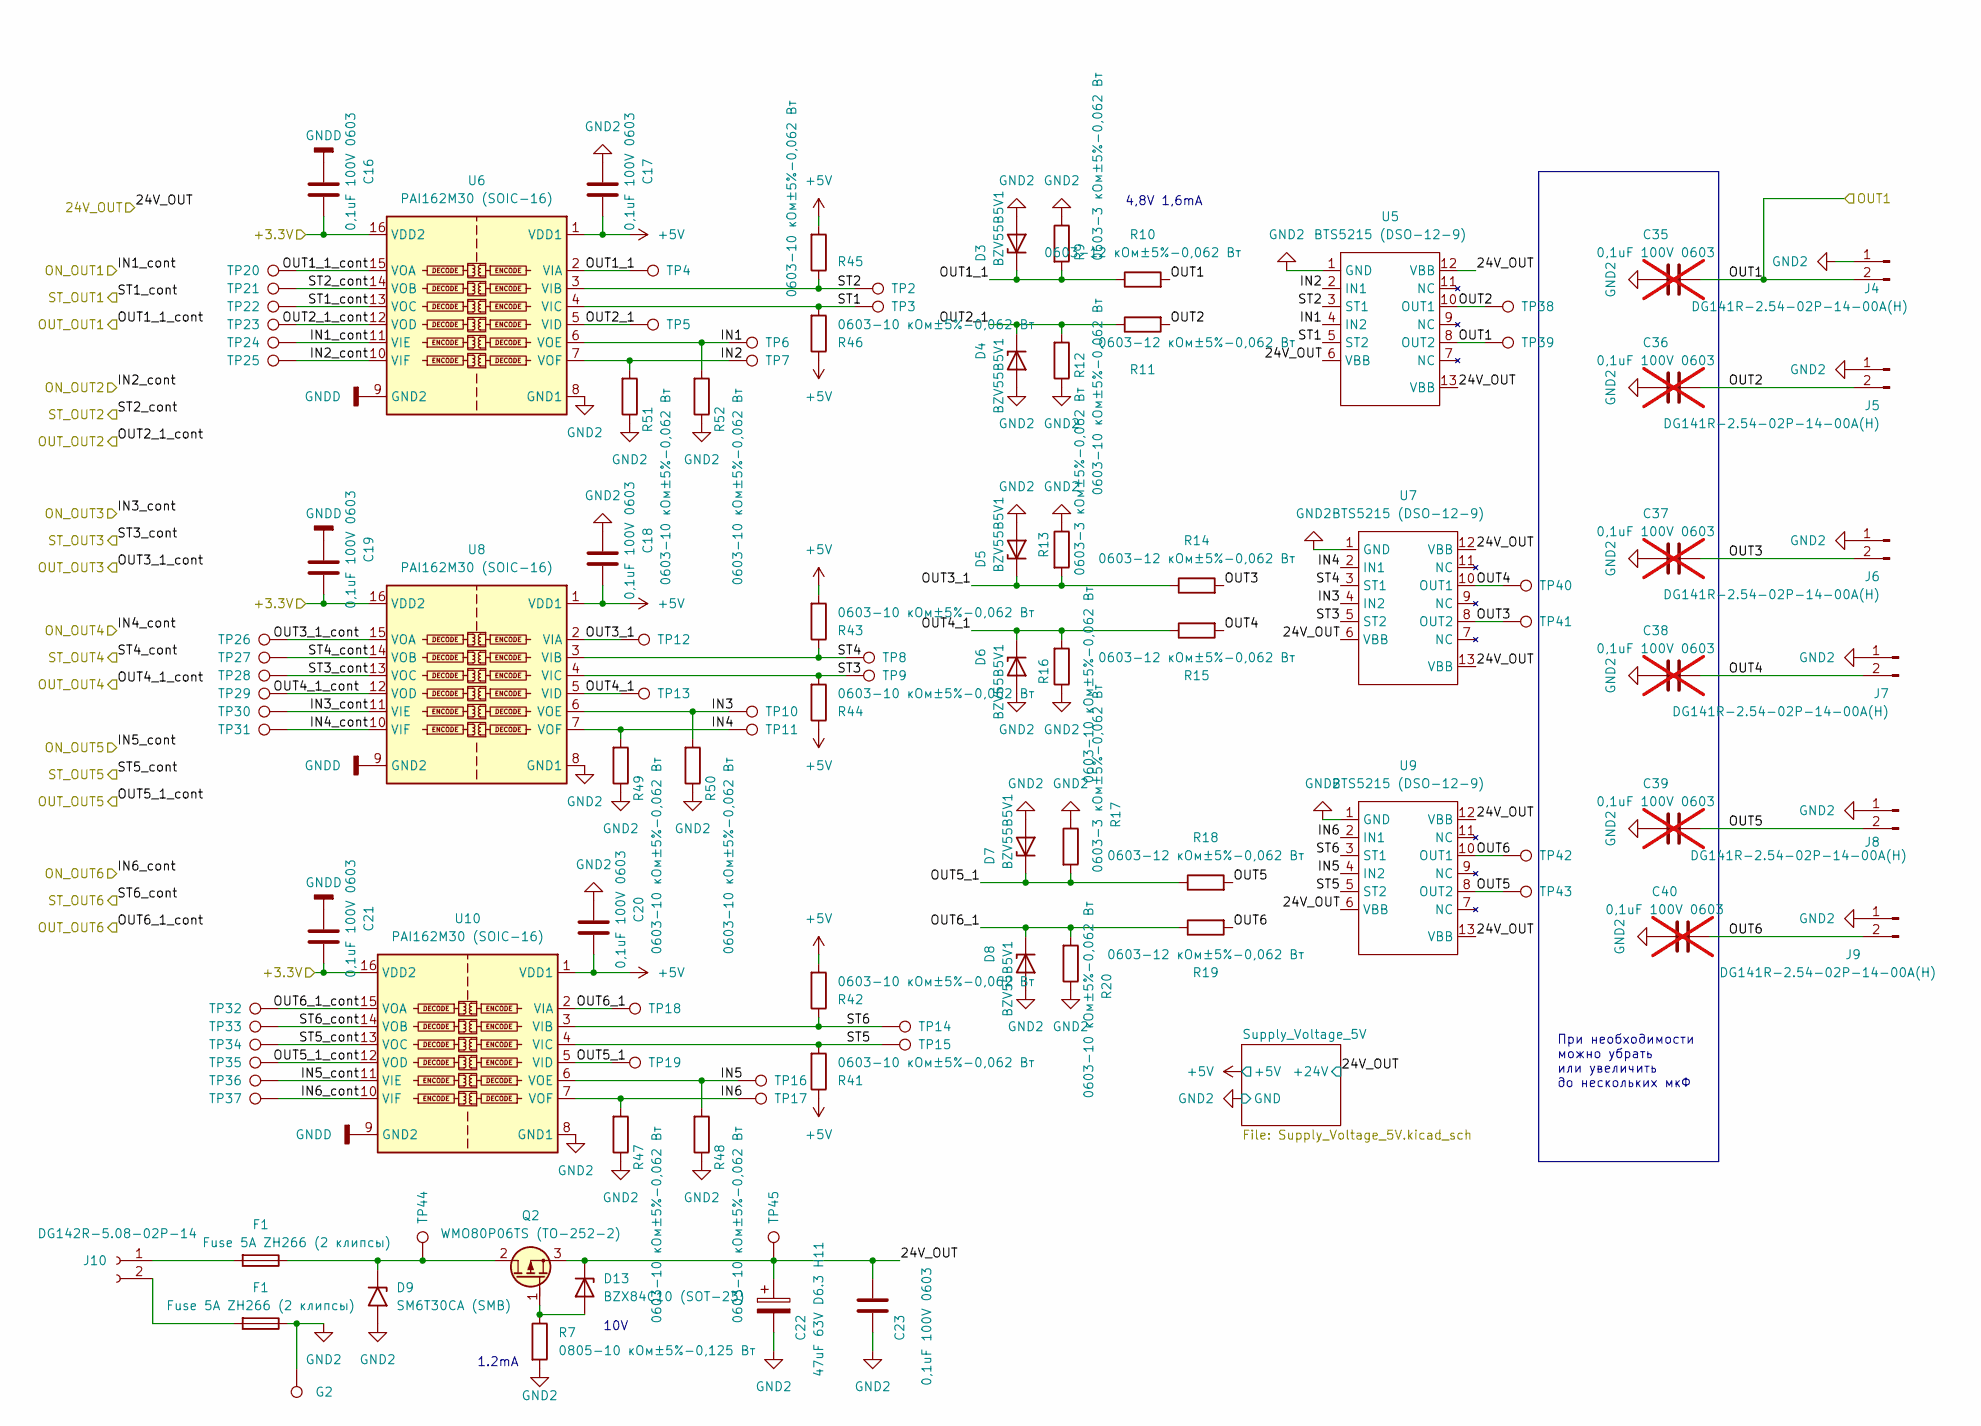
[picture p19: schematic DiscretOut.kicad_sch]

Parts:
C16, C17, C18, C19, C20, C21, C23: 0,1uF 100V 0603; C_0603_1608Metric
C22: 47uF 63V D6.3 H11; CP_Radial_D6.3mm_P2.50mm
C35, C36, C37, C38, C39, C40: 0,1uF 100V 0603; C_0603_1608Metric; not fitted
D3, D4, D5, D6, D7, D8: BZV55B5V1; D_MiniMELF
D9: SM6T30СA (SMB); D_SMB
D13: BZX84C10 (SOT-23); SOT-23
F1: Fuse 5A ZH266 (2 клипсы); Fuseholder_100_series_5x20mm_D1,5
G2: TestPoint_D1
J4, J5, J6, J7, J8, J9: DG141R-2.54-02P-14-00A(H); DG141R-02
J10: DG142R-5.08-02P-14
Q2: WMO80P06TS (TO-252-2); TO-252-2
R7: 0805-10 кОм±5%-0,125 Вт; R_0805_2012Metric
R9, R13, R17: 0603-3 кОм±5%-0,062 Вт; R_0603_1608Metric
R10, R11, R14, R15, R18, R19: 0603-12 кОм±5%-0,062 Вт; R_0603_1608Metric
R12, R16, R20, R41, R42, R43, R44, R45, R46, R47, R48, R49, R50, R51, R52: 0603-10 кОм±5%-0,062 Вт; R_0603_1608Metric
TP2, TP3, TP4, TP5, TP6, TP7, TP8, TP9, TP10, TP11, TP12, TP13, TP14, TP15, TP16, TP17, TP18, TP19, TP20, TP21, TP22, TP23, TP24, TP25, TP26, TP27, TP28, TP29, TP30, TP31, TP32, TP33, TP34, TP35, TP36, TP37, TP38, TP39, TP40, TP41, TP42, TP43, TP44, TP45: TestPoint_D1
U5, U7, U9: BTS5215 (DSO-12-9); Infineon_PG-DSO-12-9
U6, U8, U10: PAI162M30 (SOIC-16); SOIC-16_3.9x9.9mm_P1.27mm

Connections:
+3V3: C16.2, C19.2, C21.2, U6.16 (VDD2), U8.16 (VDD2), U10.16 (VDD2); also elsewhere on the board
+5V: C17.2, C18.2, C20.2, R41.1, R42.2, R43.2, R44.1, R45.2, R46.1, U6.1 (VDD1), U8.1 (VDD1), U10.1 (VDD1); also elsewhere on the board
/+24_FT_1: C35.2, J4.2, R10.2, TP39.1, U5.8 (OUT2); also elsewhere on the board
/DiscretOut/IN1: R52.2, TP6.1, U5.4 (IN2), U6.6 (VOE)
/DiscretOut/IN2: R51.2, TP7.1, U5.2 (IN1), U6.7 (VOF)
/DiscretOut/IN3: R50.2, TP10.1, U7.4 (IN2), U8.6 (VOE)
/DiscretOut/IN4: R49.2, TP11.1, U7.2 (IN1), U8.7 (VOF)
/DiscretOut/IN5: R48.2, TP16.1, U9.4 (IN2), U10.6 (VOE)
/DiscretOut/IN6: R47.2, TP17.1, U9.2 (IN1), U10.7 (VOF)
/DiscretOut/OUT1_1: D3.1 (K), R9.2, R10.1, TP4.1, U6.2 (VIA)
/DiscretOut/OUT2: C36.2, J5.2, R11.2, TP38.1, U5.10 (OUT1)
/DiscretOut/OUT2_1: D4.1 (K), R11.1, R12.2, TP5.1, U6.5 (VID)
/DiscretOut/OUT3: C37.2, J6.2, R14.2, TP41.1, U7.8 (OUT2)
/DiscretOut/OUT3_1: D5.1 (K), R13.2, R14.1, TP12.1, U8.2 (VIA)
/DiscretOut/OUT4: C38.2, J7.2, R15.2, TP40.1, U7.10 (OUT1)
/DiscretOut/OUT4_1: D6.1 (K), R15.1, R16.2, TP13.1, U8.5 (VID)
/DiscretOut/OUT5: C39.2, J8.2, R18.2, TP43.1, U9.8 (OUT2)
/DiscretOut/OUT5_1: D7.1 (K), R17.2, R18.1, TP19.1, U10.5 (VID)
/DiscretOut/OUT6: C40.2, J9.2, R19.2, TP42.1, U9.10 (OUT1)
/DiscretOut/OUT6_1: D8.1 (K), R19.1, R20.2, TP18.1, U10.2 (VIA)
/DiscretOut/ST1: R46.2, TP3.1, U5.5 (ST2), U6.4 (VIC)
/DiscretOut/ST2: R45.1, TP2.1, U5.3 (ST1), U6.3 (VIB)
/DiscretOut/ST3: R44.2, TP9.1, U7.5 (ST2), U8.4 (VIC)
/DiscretOut/ST4: R43.1, TP8.1, U7.3 (ST1), U8.3 (VIB)
/DiscretOut/ST5: R41.2, TP15.1, U9.5 (ST2), U10.4 (VIC)
/DiscretOut/ST6: R42.1, TP14.1, U9.3 (ST1), U10.3 (VIB)
/ON_OUT1: TP24.1, U6.11 (VIE); also elsewhere on the board
/ON_OUT2: TP25.1, U6.10 (VIF); also elsewhere on the board
/ON_OUT3: TP30.1, U8.11 (VIE); also elsewhere on the board
/ON_OUT4: TP31.1, U8.10 (VIF); also elsewhere on the board
/ON_OUT5: TP36.1, U10.11 (VIE); also elsewhere on the board
/ON_OUT6: TP37.1, U10.10 (VIF); also elsewhere on the board
/OUT1_1_cont: TP20.1, U6.15 (VOA); also elsewhere on the board
/OUT2_1_cont: TP23.1, U6.12 (VOD); also elsewhere on the board
/OUT3_1_cont: TP26.1, U8.15 (VOA); also elsewhere on the board
/OUT4_1_cont: TP29.1, U8.12 (VOD); also elsewhere on the board
/OUT5_1_cont: TP35.1, U10.12 (VOD); also elsewhere on the board
/OUT6_1_cont: TP33.1, U10.14 (VOB); also elsewhere on the board
/ST1_cont: TP22.1, U6.13 (VOC); also elsewhere on the board
/ST2_cont: TP21.1, U6.14 (VOB); also elsewhere on the board
/ST3_cont: TP28.1, U8.13 (VOC); also elsewhere on the board
/ST4_cont: TP27.1, U8.14 (VOB); also elsewhere on the board
/ST5_cont: TP34.1, U10.13 (VOC); also elsewhere on the board
/ST6_cont: TP32.1, U10.15 (VOA); also elsewhere on the board

Notes on the sheet:
При необходимости можно убрать или увеличить до нескольких мкФ
4,8V 1,6mA
10V
1.2mA

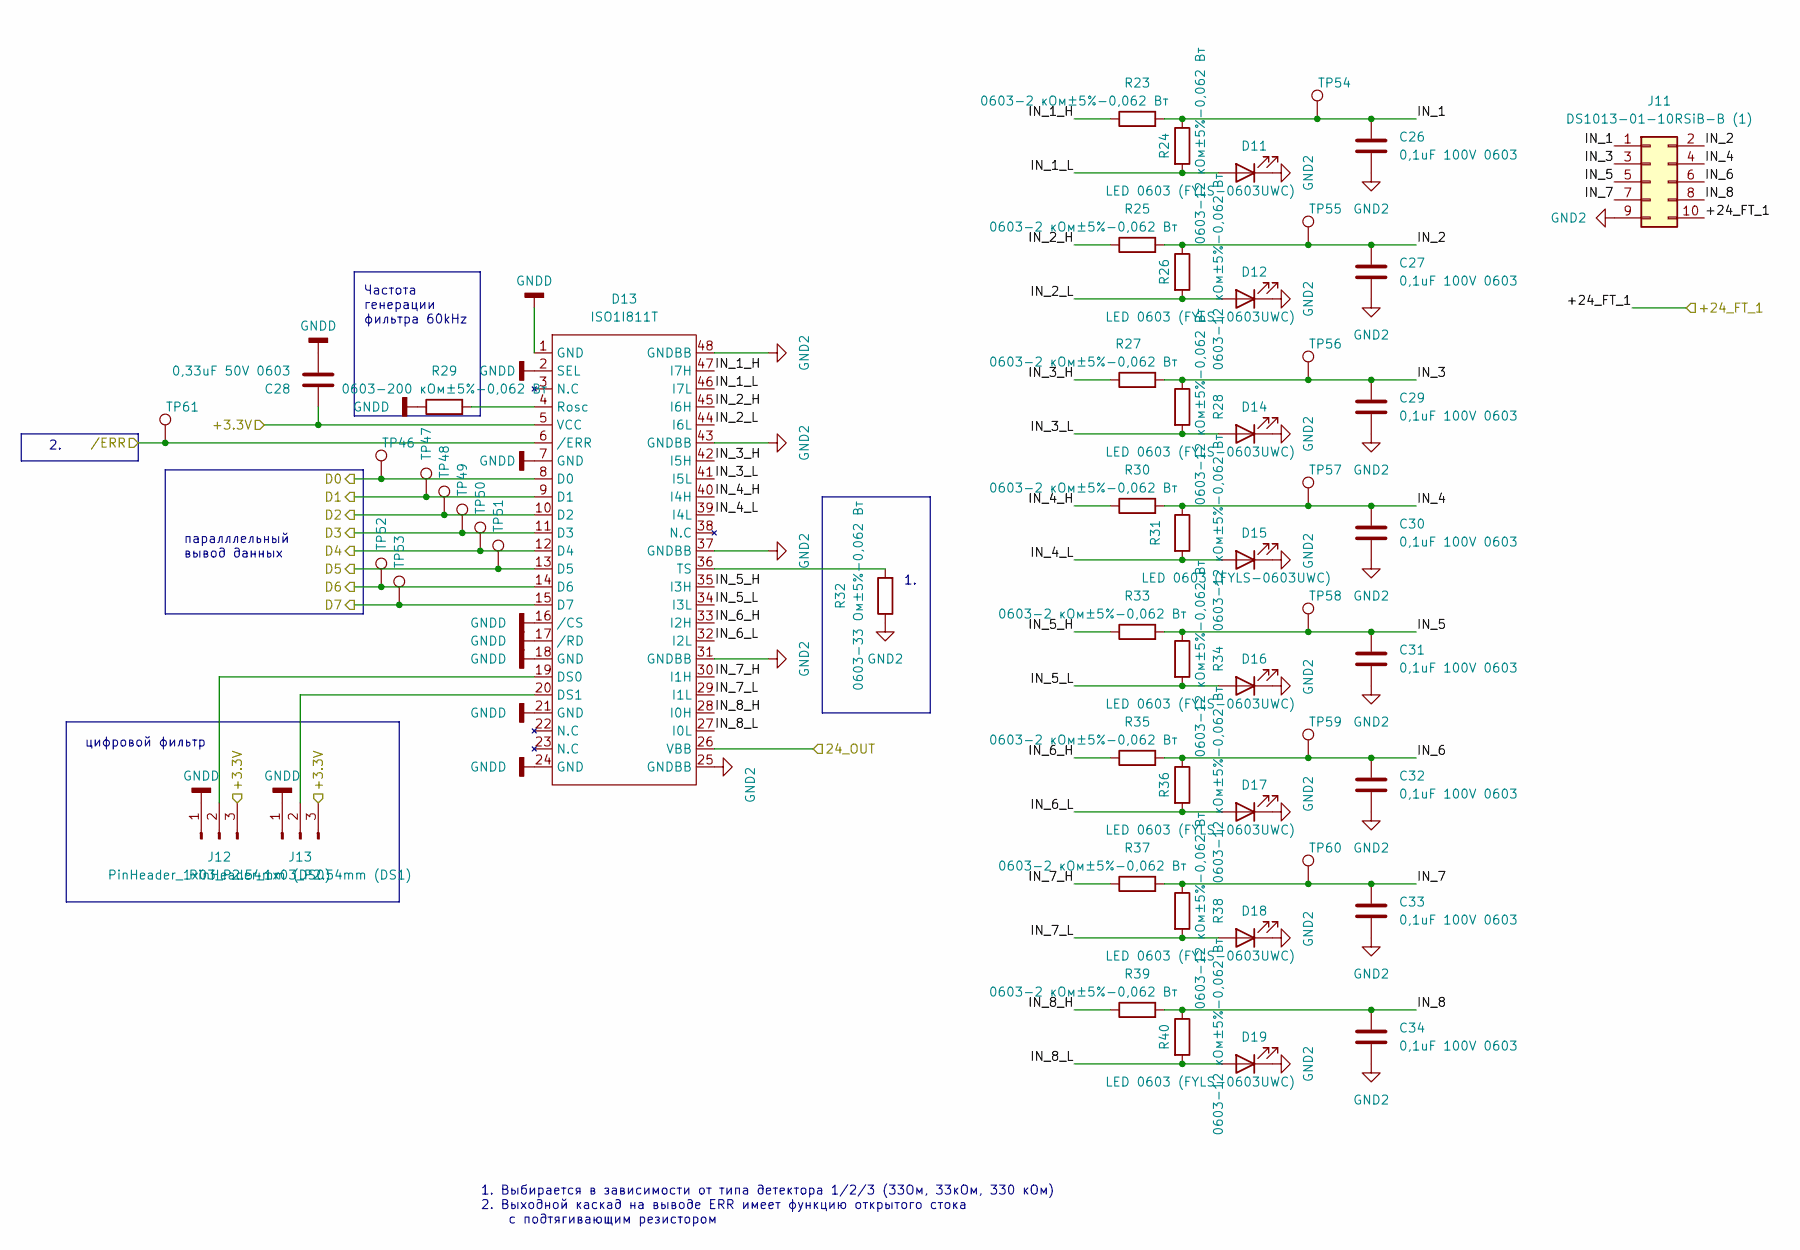
[picture p20: schematic DescretInput.kicad_sch]

Parts:
C26, C27, C29, C30, C31, C32, C33, C34: 0,1uF 100V 0603; C_0603_1608Metric
C28: 0,33uF 50V 0603; C_0603_1608Metric_Pad1.08x0.95mm_HandSolder
D11, D12, D14, D15, D16, D17, D18, D19: LED 0603 (FYLS-0603UWC); LED_0603_1608Metric_Pad1.05x0.95mm_HandSolder
D13: ISO1I811T; TSSOP-48_6.1x12.5mm_P0.5mm
J11: DS1013-01-10RSiB-B (1); IDC-Header_2x05_P2.54mm_Horizontal
J12: PinHeader_1x03_P2.54mm (DS0); PinHeader_1x03_P2.54mm_Vertical
J13: PinHeader_1x03_P2.54mm (DS1); PinHeader_1x03_P2.54mm_Vertical
R23, R25, R27, R30, R33, R35, R37, R39: 0603-2 кОм±5%-0,062 Вт; R_0603_1608Metric
R24, R26, R28, R31, R34, R36, R38, R40: 0603-12 кОм±5%-0,062 Вт; R_0603_1608Metric
R29: 0603-200 кОм±5%-0,062 Вт; R_0603_1608Metric
R32: 0603-33 Ом±5%-0,062 Вт; R_0603_1608Metric
TP46, TP47, TP48, TP49, TP50, TP51, TP52, TP53, TP54, TP55, TP56, TP57, TP58, TP59, TP60, TP61: TestPoint_D1

Connections:
+3V3: C28.1, D13.5 (VCC), J12.3, J13.3; also elsewhere on the board
/+24_FT_1: J11.10; also elsewhere on the board
/D0: D13.8 (D0), TP46.1; also elsewhere on the board
/D1: D13.9 (D1), TP47.1; also elsewhere on the board
/D2: D13.10 (D2), TP48.1; also elsewhere on the board
/D3: D13.11 (D3), TP49.1; also elsewhere on the board
/D4: D13.12 (D4), TP50.1; also elsewhere on the board
/D5: D13.13 (D5), TP51.1; also elsewhere on the board
/D6: D13.14 (D6), TP52.1; also elsewhere on the board
/D7: D13.15 (D7), TP53.1; also elsewhere on the board
/Descret Input/IN_1: C26.1, J11.1, R23.2, R24.1, TP54.1
/Descret Input/IN_1_H: D13.47 (I7H), R23.1
/Descret Input/IN_1_L: D11.2 (A), D13.46 (I7L), R24.2
/Descret Input/IN_2: C27.1, J11.2, R25.2, R26.1, TP55.1
/Descret Input/IN_2_H: D13.45 (I6H), R25.1
/Descret Input/IN_2_L: D12.2 (A), D13.44 (I6L), R26.2
/Descret Input/IN_3: C29.1, J11.3, R27.2, R28.1, TP56.1
/Descret Input/IN_3_H: D13.42 (I5H), R27.1
/Descret Input/IN_3_L: D13.41 (I5L), D14.2 (A), R28.2
/Descret Input/IN_4: C30.1, J11.4, R30.2, R31.1, TP57.1
/Descret Input/IN_4_H: D13.40 (I4H), R30.1
/Descret Input/IN_4_L: D13.39 (I4L), D15.2 (A), R31.2
/Descret Input/IN_5: C31.1, J11.5, R33.2, R34.1, TP58.1
/Descret Input/IN_5_H: D13.35 (I3H), R33.1
/Descret Input/IN_5_L: D13.34 (I3L), D16.2 (A), R34.2
/Descret Input/IN_6: C32.1, J11.6, R35.2, R36.1, TP59.1
/Descret Input/IN_6_H: D13.33 (I2H), R35.1
/Descret Input/IN_6_L: D13.32 (I2L), D17.2 (A), R36.2
/Descret Input/IN_7: C33.1, J11.7, R37.2, R38.1, TP60.1
/Descret Input/IN_7_H: D13.30 (I1H), R37.1
/Descret Input/IN_7_L: D13.29 (I1L), D18.2 (A), R38.2
/Descret Input/IN_8: C34.1, J11.8, R39.2, R40.1
/Descret Input/IN_8_H: D13.28 (I0H), R39.1
/Descret Input/IN_8_L: D13.27 (I0L), D19.2 (A), R40.2
/ERR: D13.6 (/ERR), TP61.1; also elsewhere on the board
unnamed: D13.19 (DS0), J12.2
unnamed: D13.20 (DS1), J13.2
unnamed: D13.4 (Rosc), R29.2
unnamed: D13.36 (TS), R32.2

Notes on the sheet:
1. Выбирается в зависимости от типа детектора 1/2/3 (33Ом, 33кОм, 330 кОм) 2. Выходной каскад на выводе ERR имеет функцию открытого стока с подтягивающим резистором
паралллельный вывод данных
цифровой фильтр
Частота генерации фильтра 60kHz

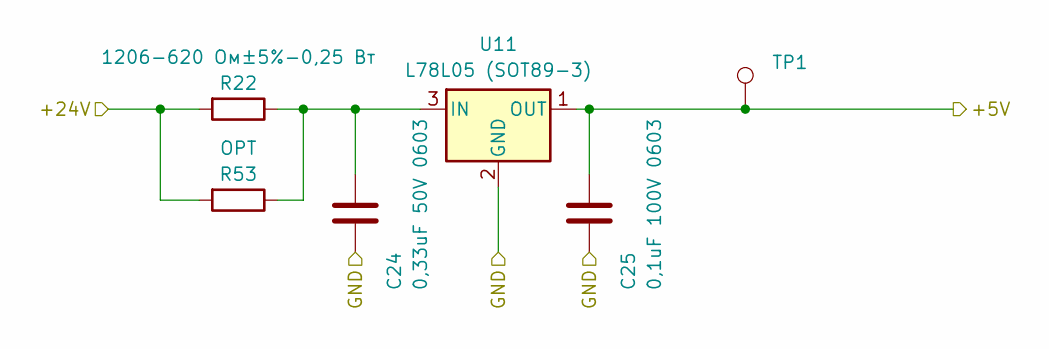
[picture p21: schematic Supply_Voltage_5V.kicad_sch]

Parts:
C24: 0,33uF 50V 0603; C_0603_1608Metric_Pad1.08x0.95mm_HandSolder
C25: 0,1uF 100V 0603; C_0603_1608Metric
R22: 1206-620 Ом±5%-0,25 Вт; R_1206_3216Metric_Pad1.42x1.75mm_HandSolder
R53: OPT; R_1206_3216Metric_Pad1.42x1.75mm_HandSolder
TP1: TestPoint_D1
U11: L78L05 (SOT89-3); SOT-89-3

Connections:
+5V: C25.1, TP1.1, U11.1 (OUT); also elsewhere on the board
unnamed: C24.1, R22.1, R53.1, U11.3 (IN)

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
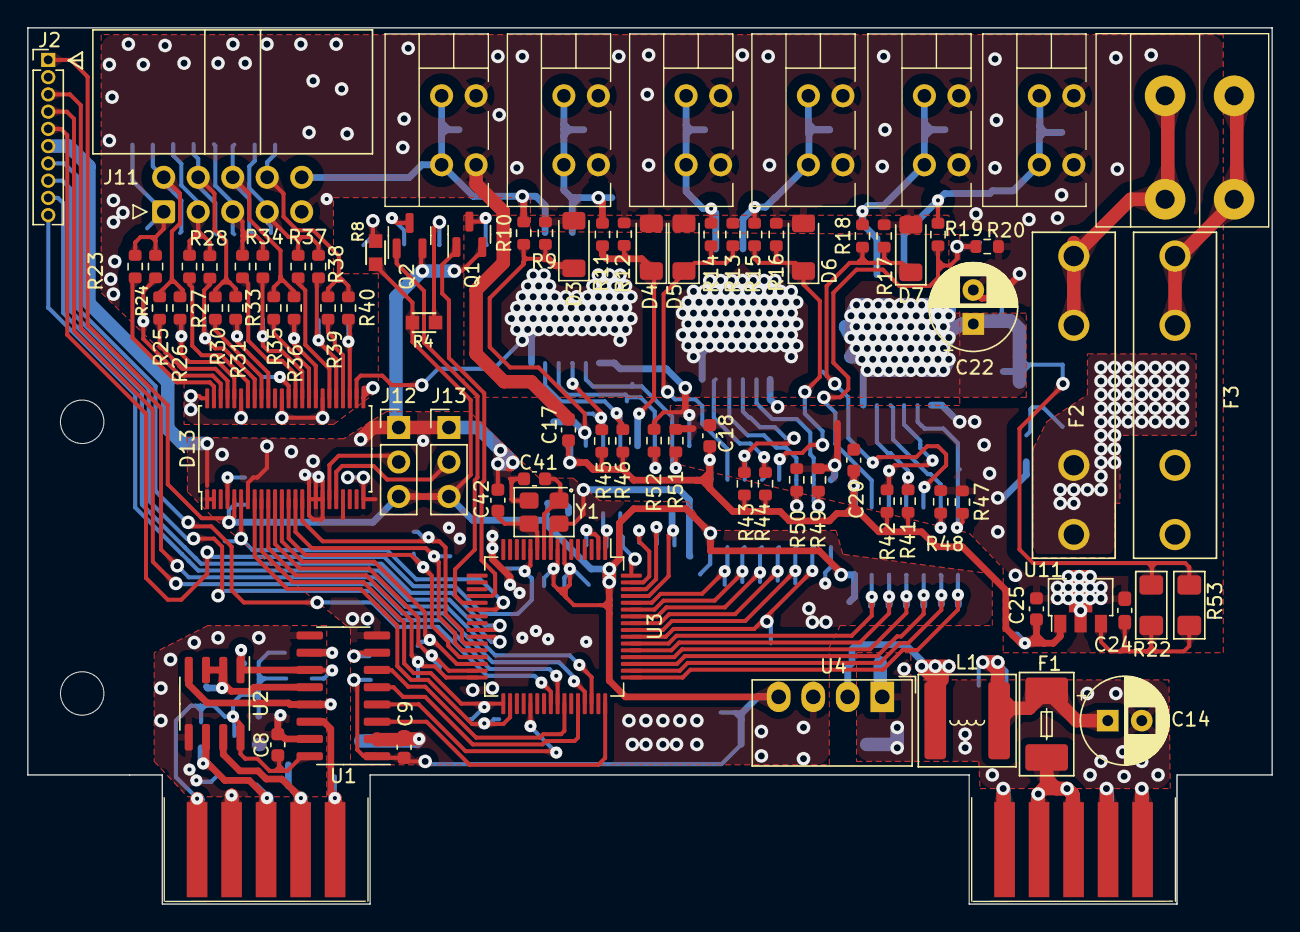
[picture p22: board digit_in_board.kicad_pcb from above]

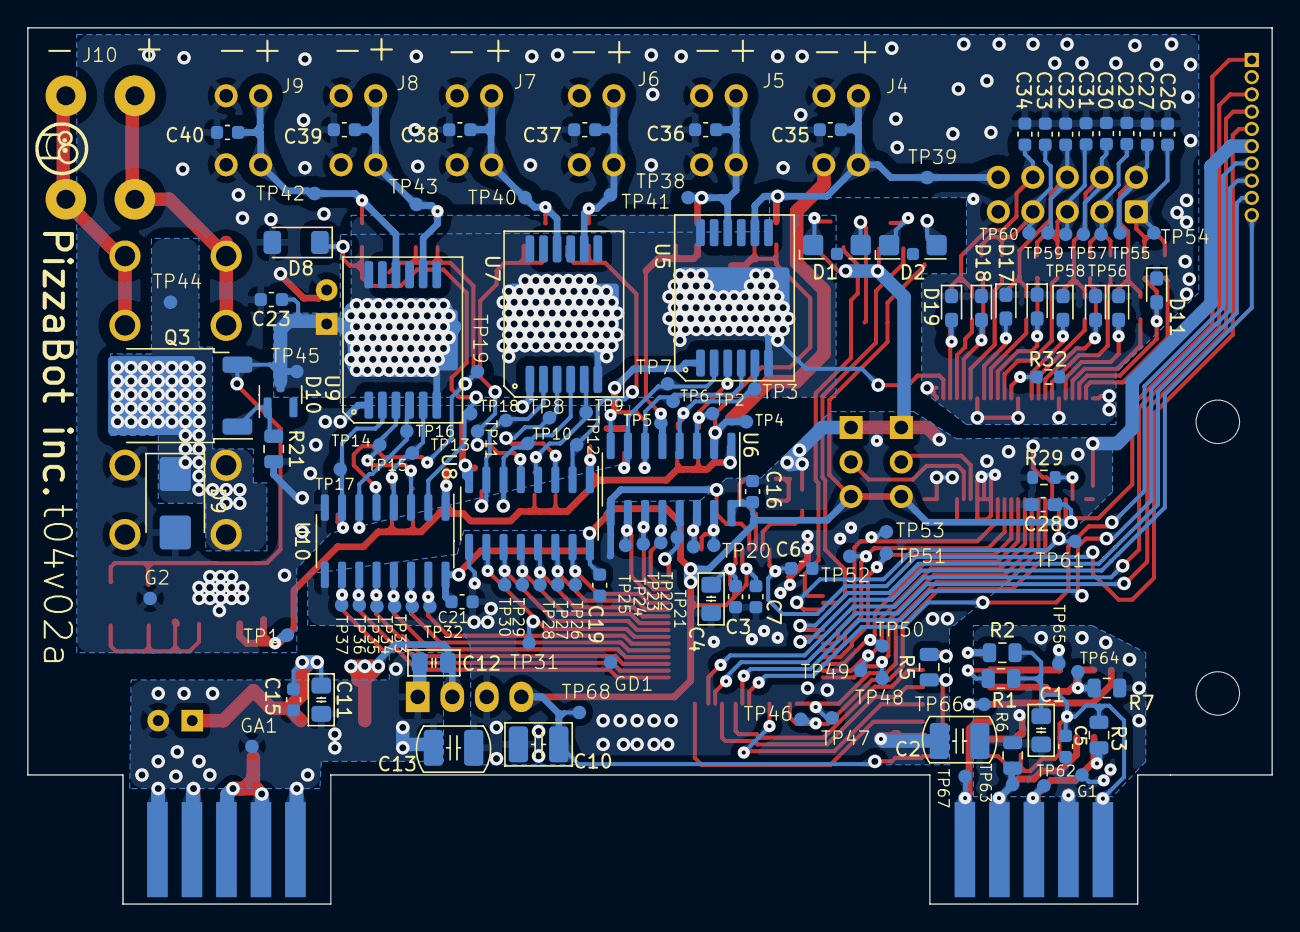
[picture p23: board digit_in_board.kicad_pcb from below]

Board: 2 copper layers, 91.6 x 64.5 mm, 220 parts (132 on the bottom side), 122 nets.

Other parts of the board:
D10: BZX84C10 (SOT-23); SOT-23
F2, F3: Fuse 5A ZH266 (2 клипсы); Fuseholder_100_series_5x20mm_D1,5
Q3: WMO80P06TS (TO-252-2); TO-252-2
R21: 0805-10 кОм±5%-0,125 Вт; R_0805_2012Metric

Their connections:
unnamed: D10.1 (A), Q3.1 (G), R21.1
