borzeman/PzbElectronics/triac_board/triac_board.kicad_pcb

## KiCad design triac_board/triac_board.kicad_pcb (2025-10-31)

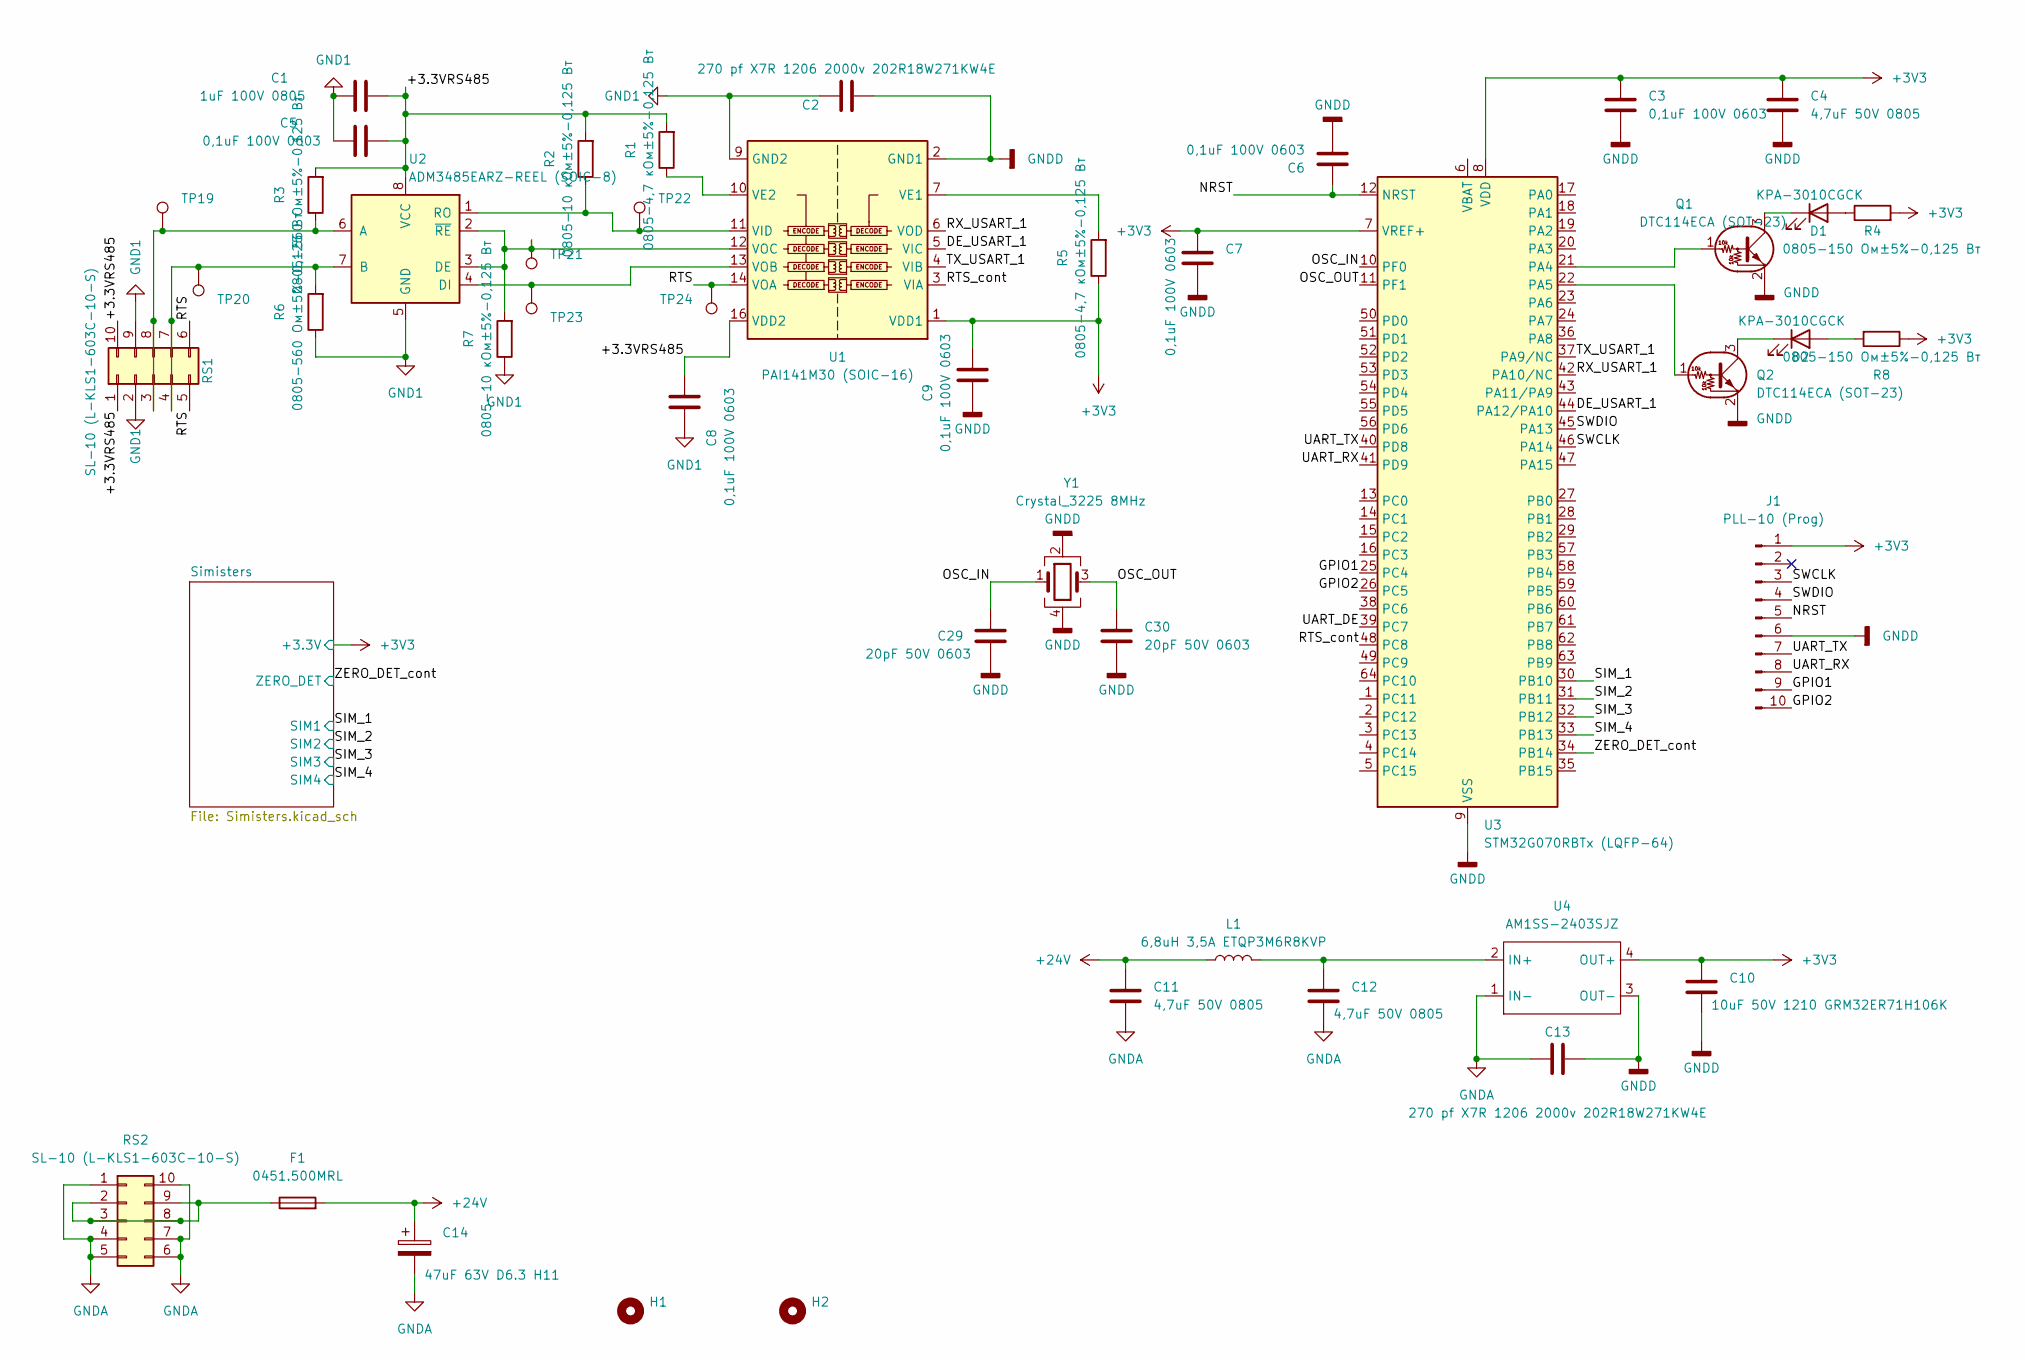
[picture p24: schematic triac_board.kicad_sch]

Parts:
C1: 1uF 100V 0805; C_0805_2012Metric_Pad1.18x1.45mm_HandSolder
C2, C13: 270 pf X7R 1206 2000v 202R18W271KW4E; C_1210_3225Metric_Pad1.42x2.65mm
C3, C5, C6, C7, C8, C9: 0,1uF 100V 0603; C_0603_1608Metric
C4, C11, C12: 4,7uF 50V 0805; C_0805_2012Metric_Pad1.18x1.45mm_HandSolder
C10: 10uF 50V 1210 GRM32ER71H106K; C_1210_3225Metric_Pad1.42x2.65mm_HandSolder
C14: 47uF 63V D6.3 H11; CP_Radial_D6.3mm_P2.50mm
C29, C30: 20pF 50V 0603; C_0603_1608Metric
D1, D2: KPA-3010CGCK; LED_Kingbright_KPA-3010_3x2x1mm
F1: 0451.500MRL; Fuse_Littelfuse-NANO2-451_453
H1, H2: MountingHole; MountingHole_3.2mm_M3
J1: PLL-10 (Prog); PinHeader_1x10_P1.27mm_Vertical
L1: 6,8uH 3,5A ETQP3M6R8KVP; L_Bourns-SRN6028
Q1, Q2: DTC114ECA (SOT-23); SOT-23
R1, R5: 0805-4,7 кОм±5%-0,125 Вт; R_0805_2012Metric
R2, R7: 0805-10 кОм±5%-0,125 Вт; R_0805_2012Metric
R3, R6: 0805-560 Ом±5%-0,125 Вт; R_0805_2012Metric
R4, R8: 0805-150 Ом±5%-0,125 Вт; R_0805_2012Metric
RS1, RS2: SL-10 (L-KLS1-603C-10-S); Edge_Conn_KLS1-603-10
TP19, TP20, TP21, TP22, TP23, TP24: TestPoint; TestPoint_D1
U1: PAI141M30 (SOIC-16); SOIC-16_3.9x9.9mm_P1.27mm
U2: ADM3485EARZ-REEL (SOIC-8); SOIC-8_3.9x4.9mm_P1.27mm
U3: STM32G070RBTx (LQFP-64); LQFP-64_10x10mm_P0.5mm
U4: AM1SS-2403SJZ; Converter_DCDC_Murata_MEE3SxxxxSC_THT
Y1: Crystal_3225 8MHz; Crystal_SMD_3225-4Pin_3.2x2.5mm

Connections:
+3V3: C3.1, C4.1, C7.1, C9.2, C10.1, J1.1, R4.2, R5.1, R8.1, U1.1 (VDD1), U3.7 (VREF+), U3.8 (VDD), U4.4 (OUT+); also elsewhere on the board
+24V: C11.1, C14.1, F1.2, L1.1
/+3.3VRS485: C1.2, C5.2, C8.2, R1.2, R2.2, R3.2, RS1.1, RS1.10, U1.16 (VDD2), U2.8 (VCC)
/DE_USART_1: U1.5 (VIC), U3.44 (PA12/PA10)
/GPIO1: J1.9, U3.25 (PC4)
/GPIO2: J1.10, U3.26 (PC5)
/NRST: C6.1, J1.5, U3.12 (NRST)
/OSC_IN: C29.1, U3.10 (PF0), Y1.1
/OSC_OUT: C30.1, U3.11 (PF1), Y1.3
/RTS: RS1.5, RS1.6, TP24.1, U1.14 (VOA)
/RTS_cont: U1.3 (VIA), U3.48 (PC8)
/RX_USART_1: U1.6 (VOD), U3.42 (PA10/NC)
/SIM_1: U3.30 (PB10); also elsewhere on the board
/SIM_2: U3.31 (PB11); also elsewhere on the board
/SIM_3: U3.32 (PB12); also elsewhere on the board
/SIM_4: U3.33 (PB13); also elsewhere on the board
/SWCLK: J1.3, U3.46 (PA14)
/SWDIO: J1.4, U3.45 (PA13)
/TX_USART_1: U1.4 (VIB), U3.37 (PA9/NC)
/UART_DE: U3.39 (PC7)
/UART_RX: J1.8, U3.41 (PD9)
/UART_TX: J1.7, U3.40 (PD8)
/ZERO_DET_cont: U3.34 (PB14); also elsewhere on the board
GND1: C1.1, C2.1, C5.1, C8.1, R6.1, R7.1, RS1.2, RS1.9, U1.9 (GND2), U1.15 (GND2), U2.5 (GND)
GNDA: C11.2, C12.2, C13.1, C14.2, RS2.1, RS2.4, RS2.5, RS2.6, RS2.7, RS2.10, U4.1 (IN-)
GNDD: C2.2, C3.2, C4.2, C6.2, C7.2, C9.1, C10.2, C13.2, C29.2, C30.2, J1.6, Q1.2 (E), Q2.2 (E), U1.2 (GND1), U1.8 (GND1), U3.9 (VSS), U4.3 (OUT-), Y1.2, Y1.4; also elsewhere on the board
unnamed: D1.2 (A), R4.1
unnamed: D1.1 (K), Q1.3 (C)
unnamed: D2.2 (A), R8.2
unnamed: D2.1 (K), Q2.3 (C)
unnamed: Q1.1 (B), U3.21 (PA4)
unnamed: Q2.1 (B), U3.22 (PA5)
unnamed: R3.1, RS1.3, RS1.8, TP19.1, U2.6 (A)
unnamed: R6.2, RS1.4, RS1.7, TP20.1, U2.7 (B)
unnamed: F1.1, RS2.2, RS2.3, RS2.8, RS2.9
unnamed: R5.2, U1.7 (VE1)
unnamed: R1.1, U1.10 (VE2)
unnamed: R2.1, TP22.1, U1.11 (VID), U2.1 (RO)
unnamed: TP23.1, U1.13 (VOB), U2.4 (DI)
unnamed: R7.2, TP21.1, U1.12 (VOC), U2.2 (~RE), U2.3 (DE)
unnamed: C12.1, L1.2, U4.2 (IN+)

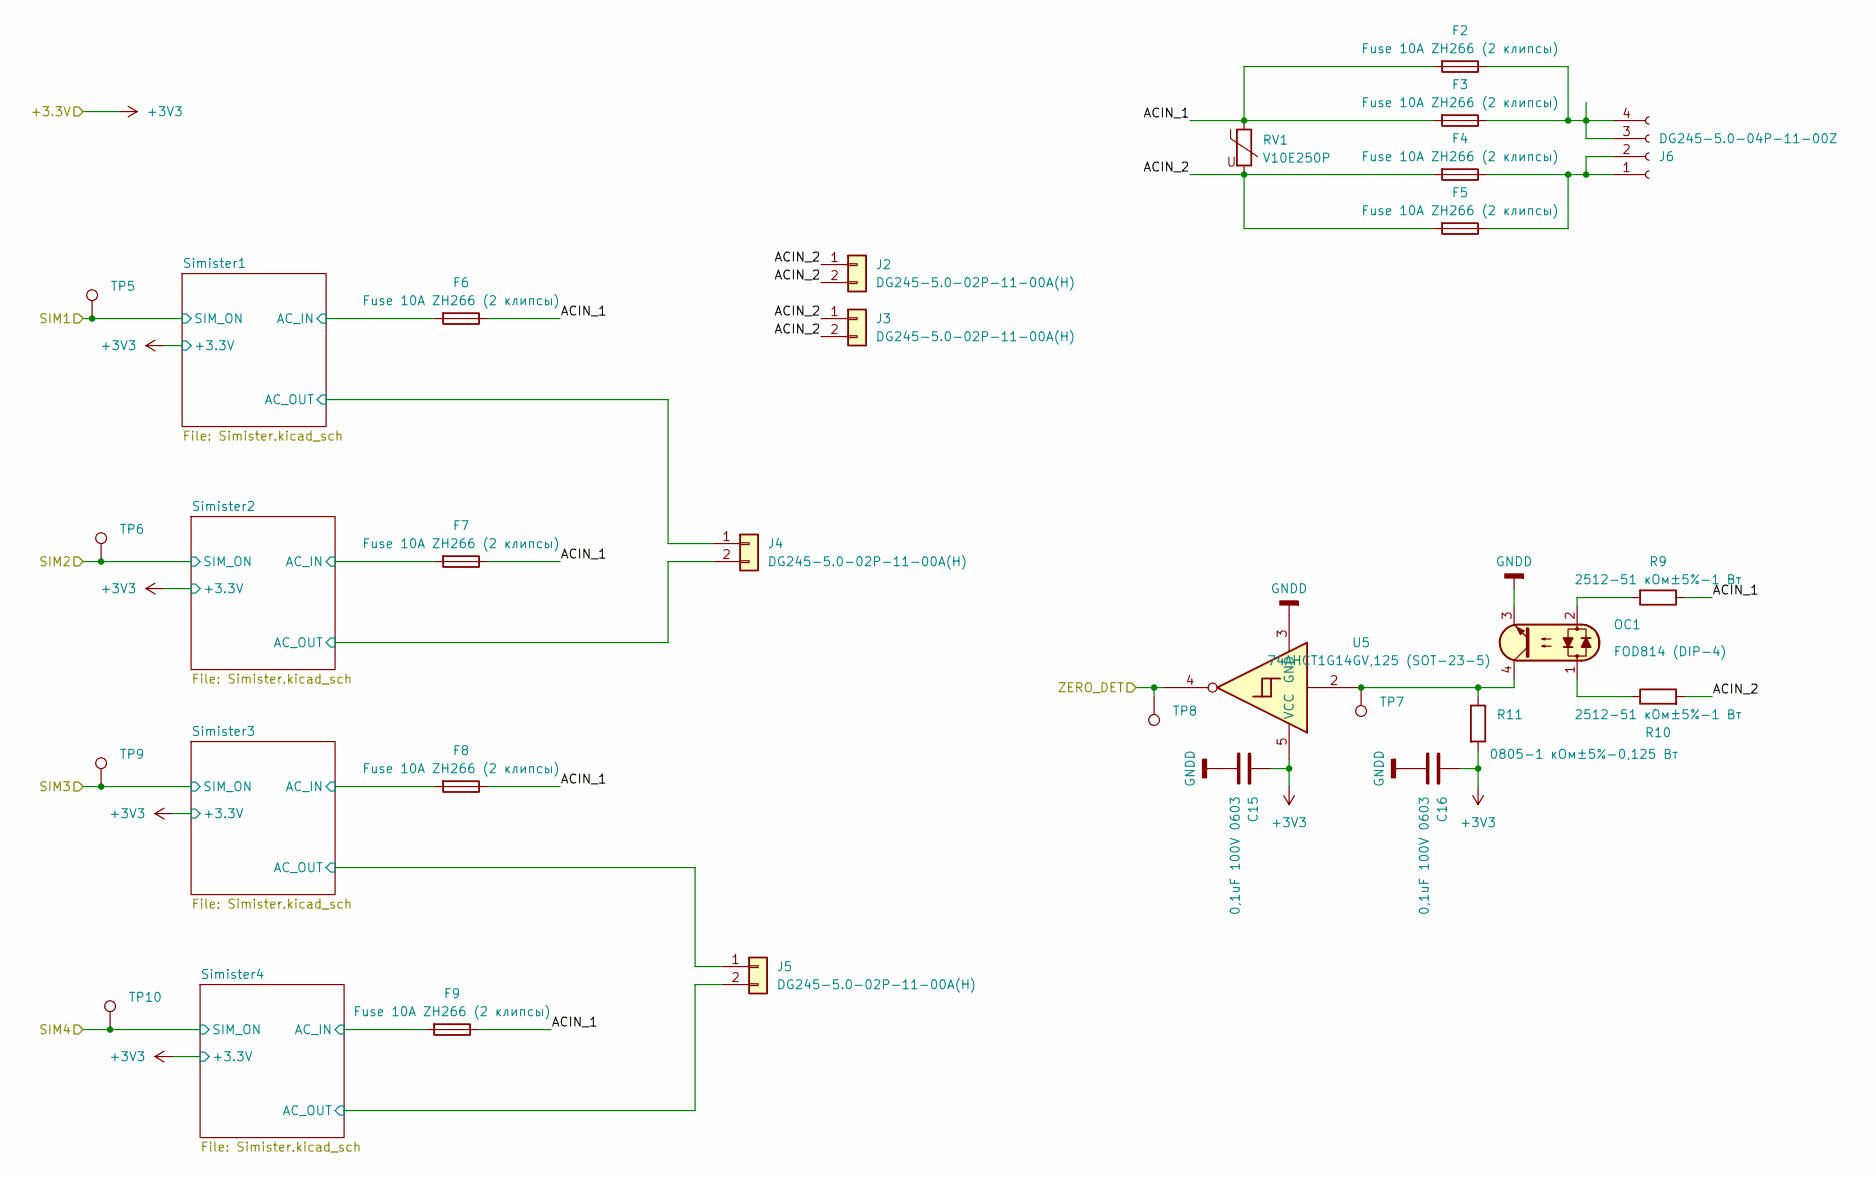
[picture p25: schematic Simisters.kicad_sch]

Parts:
C15, C16: 0,1uF 100V 0603; C_0603_1608Metric
F2, F3, F4, F5, F6, F7, F8, F9: Fuse 10A ZH266 (2 клипсы); Fuseholder_100_series_5x20mm_D1,5
J2, J3, J4, J5: DG245-5.0-02P-11-00A(H); DG245-5.0-02P
J6: DG245-5.0-04P-11-00Z; DG245-5.0-04P
OC1: FOD814 (DIP-4); DIP-4_W7.62mm_LongPads
R9, R10: 2512-51 кОм±5%-1 Вт; R_2512_6332Metric
R11: 0805-1 кОм±5%-0,125 Вт; R_0805_2012Metric_Pad1.20x1.40mm_HandSolder
RV1: V10E250P; RV_Disc_D12mm_W5.8mm_P7.5mm
TP5, TP6, TP7, TP8, TP9, TP10: TestPoint; TestPoint_D1
U5: 74AHCT1G14GV,125 (SOT-23-5); SOT-23-5

Connections:
+3V3: C15.1, C16.1, R11.2, U5.5 (VCC); also elsewhere on the board
/SIM_1: TP5.1; also elsewhere on the board
/SIM_2: TP6.1; also elsewhere on the board
/SIM_3: TP9.1; also elsewhere on the board
/SIM_4: TP10.1; also elsewhere on the board
/Simisters/ACIN_1: F2.2, F3.2, F6.1, F7.1, F8.1, F9.1, R9.1, RV1.1
/Simisters/ACIN_2: F4.2, F5.2, J2.1, J2.2, J3.1, J3.2, R10.2, RV1.2
/Simisters/Simister1/AC_IN: F6.2; also elsewhere on the board
/Simisters/Simister1/AC_OUT: J4.1; also elsewhere on the board
/Simisters/Simister2/AC_IN: F7.2; also elsewhere on the board
/Simisters/Simister2/AC_OUT: J4.2; also elsewhere on the board
/Simisters/Simister3/AC_IN: F8.2; also elsewhere on the board
/Simisters/Simister3/AC_OUT: J5.1; also elsewhere on the board
/Simisters/Simister4/AC_IN: F9.2; also elsewhere on the board
/Simisters/Simister4/AC_OUT: J5.2; also elsewhere on the board
/ZERO_DET_cont: TP8.1, U5.4; also elsewhere on the board
GNDD: C15.2, C16.2, OC1.3, U5.3 (GND); also elsewhere on the board
unnamed: F4.1, F5.1, J6.1, J6.2
unnamed: F2.1, F3.1, J6.3, J6.4
unnamed: OC1.1, R10.1
unnamed: OC1.2, R9.2
unnamed: OC1.4, R11.1, TP7.1, U5.2

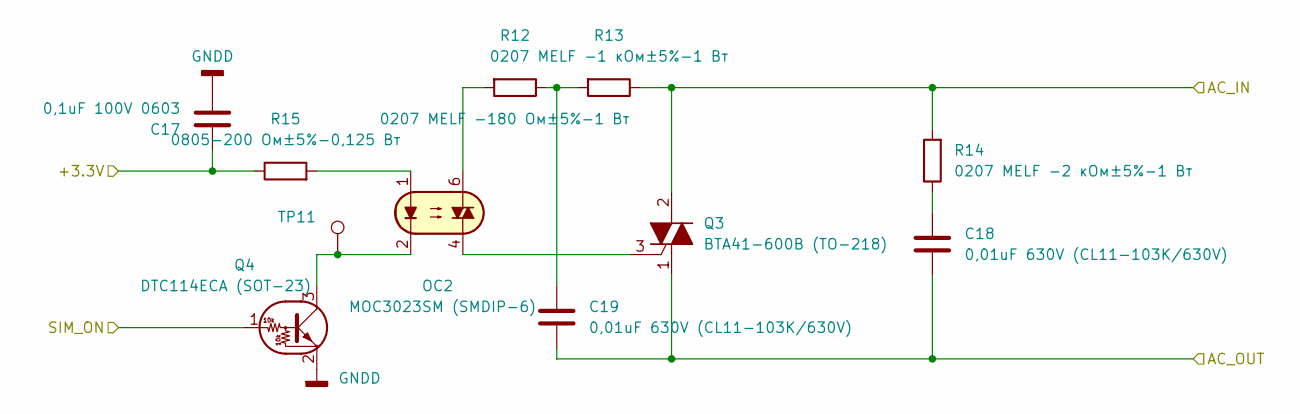
[picture p26: schematic Simister.kicad_sch]

Parts:
C17: 0,1uF 100V 0603; C_0603_1608Metric
C18, C19: 0,01uF 630V (CL11-103K/630V); C_Rect_L7.0mm_W4.5mm_P5.00mm
OC2: MOC3023SM (SMDIP-6); SMDIP-6_W9.53mm
Q3: BTA41-600B (TO-218); TO-218-3_Horizontal_TabDown
Q4: DTC114ECA (SOT-23); SOT-23
R12: 0207 MELF -180 Ом±5%-1 Вт; R_MELF_MMB-0207
R13: 0207 MELF -1 кОм±5%-1 Вт; R_MELF_MMB-0207
R14: 0207 MELF -2 кОм±5%-1 Вт; R_MELF_MMB-0207
R15: 0805-200 Ом±5%-0,125 Вт; R_0805_2012Metric
TP11: TestPoint; TestPoint_D1

Connections:
+3V3: C17.1, R15.1; also elsewhere on the board
/SIM_1: Q4.1 (B); also elsewhere on the board
/Simisters/Simister1/AC_IN: Q3.2 (A2), R13.1, R14.2; also elsewhere on the board
/Simisters/Simister1/AC_OUT: C18.2, C19.2, Q3.1 (A1); also elsewhere on the board
GNDD: C17.2, Q4.2 (E); also elsewhere on the board
unnamed: C18.1, R14.1
unnamed: C19.1, R12.1, R13.2
unnamed: OC2.1, R15.2
unnamed: OC2.6, R12.2
unnamed: OC2.4, Q3.3 (G)
unnamed: OC2.2, Q4.3 (C), TP11.1

Parts of its further copies:
C20, C23, C26: 0,1uF 100V 0603; C_0603_1608Metric
C21, C22, C24, C25, C27, C28: 0,01uF 630V (CL11-103K/630V); C_Rect_L7.0mm_W4.5mm_P5.00mm
OC3, OC4, OC5: MOC3023SM (SMDIP-6); SMDIP-6_W9.53mm
Q5, Q7, Q9: BTA41-600B (TO-218); TO-218-3_Horizontal_TabDown
Q6, Q8, Q10: DTC114ECA (SOT-23); SOT-23
R16, R20, R24: 0207 MELF -180 Ом±5%-1 Вт; R_MELF_MMB-0207
R17, R21, R25: 0207 MELF -1 кОм±5%-1 Вт; R_MELF_MMB-0207
R18, R22, R26: 0207 MELF -2 кОм±5%-1 Вт; R_MELF_MMB-0207
R19, R23, R27: 0805-200 Ом±5%-0,125 Вт; R_0805_2012Metric
TP13, TP15, TP17: TestPoint; TestPoint_D1

Connections of its further copies:
+3V3: C20.1, C23.1, C26.1, R19.1, R23.1, R27.1; also elsewhere on the board
/SIM_2: Q6.1 (B); also elsewhere on the board
/SIM_3: Q8.1 (B); also elsewhere on the board
/SIM_4: Q10.1 (B); also elsewhere on the board
/Simisters/Simister2/AC_IN: Q5.2 (A2), R17.1, R18.2; also elsewhere on the board
/Simisters/Simister2/AC_OUT: C21.2, C22.2, Q5.1 (A1); also elsewhere on the board
/Simisters/Simister3/AC_IN: Q7.2 (A2), R21.1, R22.2; also elsewhere on the board
/Simisters/Simister3/AC_OUT: C24.2, C25.2, Q7.1 (A1); also elsewhere on the board
/Simisters/Simister4/AC_IN: Q9.2 (A2), R25.1, R26.2; also elsewhere on the board
/Simisters/Simister4/AC_OUT: C27.2, C28.2, Q9.1 (A1); also elsewhere on the board
GNDD: C20.2, C23.2, C26.2, Q6.2 (E), Q8.2 (E), Q10.2 (E); also elsewhere on the board
unnamed: C21.1, R18.1
unnamed: C22.1, R16.1, R17.2
unnamed: C24.1, R22.1
unnamed: C25.1, R20.1, R21.2
unnamed: C27.1, R26.1
unnamed: C28.1, R24.1, R25.2
unnamed: OC3.1, R19.2
unnamed: OC3.6, R16.2
unnamed: OC4.1, R23.2
unnamed: OC4.6, R20.2
unnamed: OC5.1, R27.2
unnamed: OC5.6, R24.2
unnamed: OC3.4, Q5.3 (G)
unnamed: OC3.2, Q6.3 (C), TP13.1
unnamed: OC4.4, Q7.3 (G)
unnamed: OC4.2, Q8.3 (C), TP15.1
unnamed: OC5.4, Q9.3 (G)
unnamed: OC5.2, Q10.3 (C), TP17.1
