borzeman/PzbElectronics/triac_board/triac_board.kicad_pcb

## KiCad design triac_board/triac_board.kicad_pcb (continued)

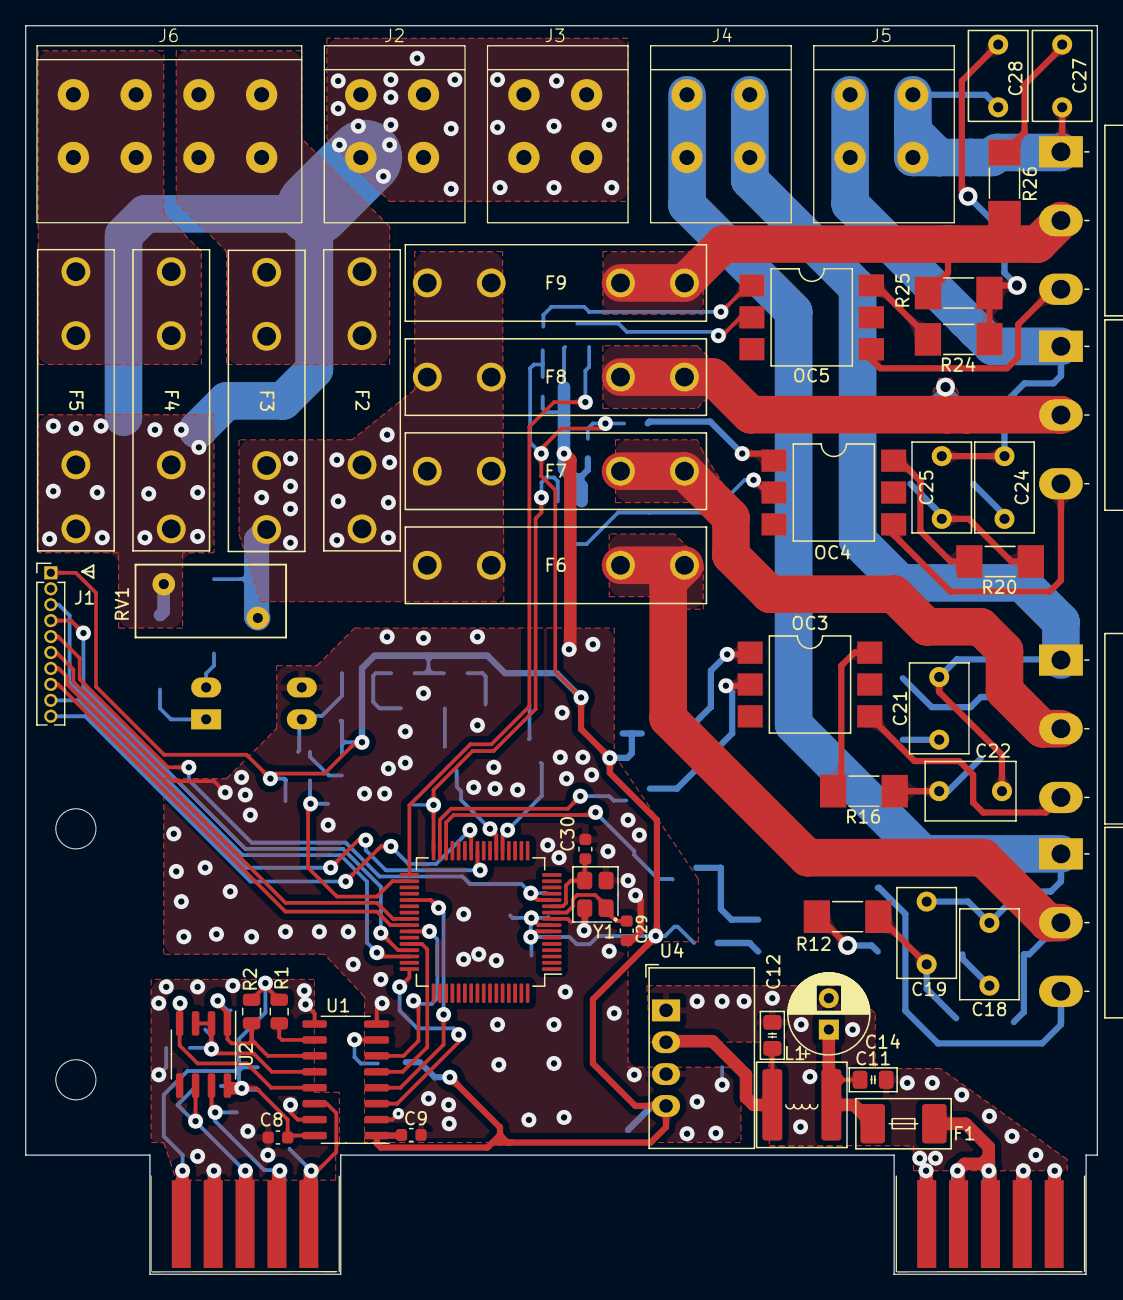
[picture p27: board triac_board.kicad_pcb from above]

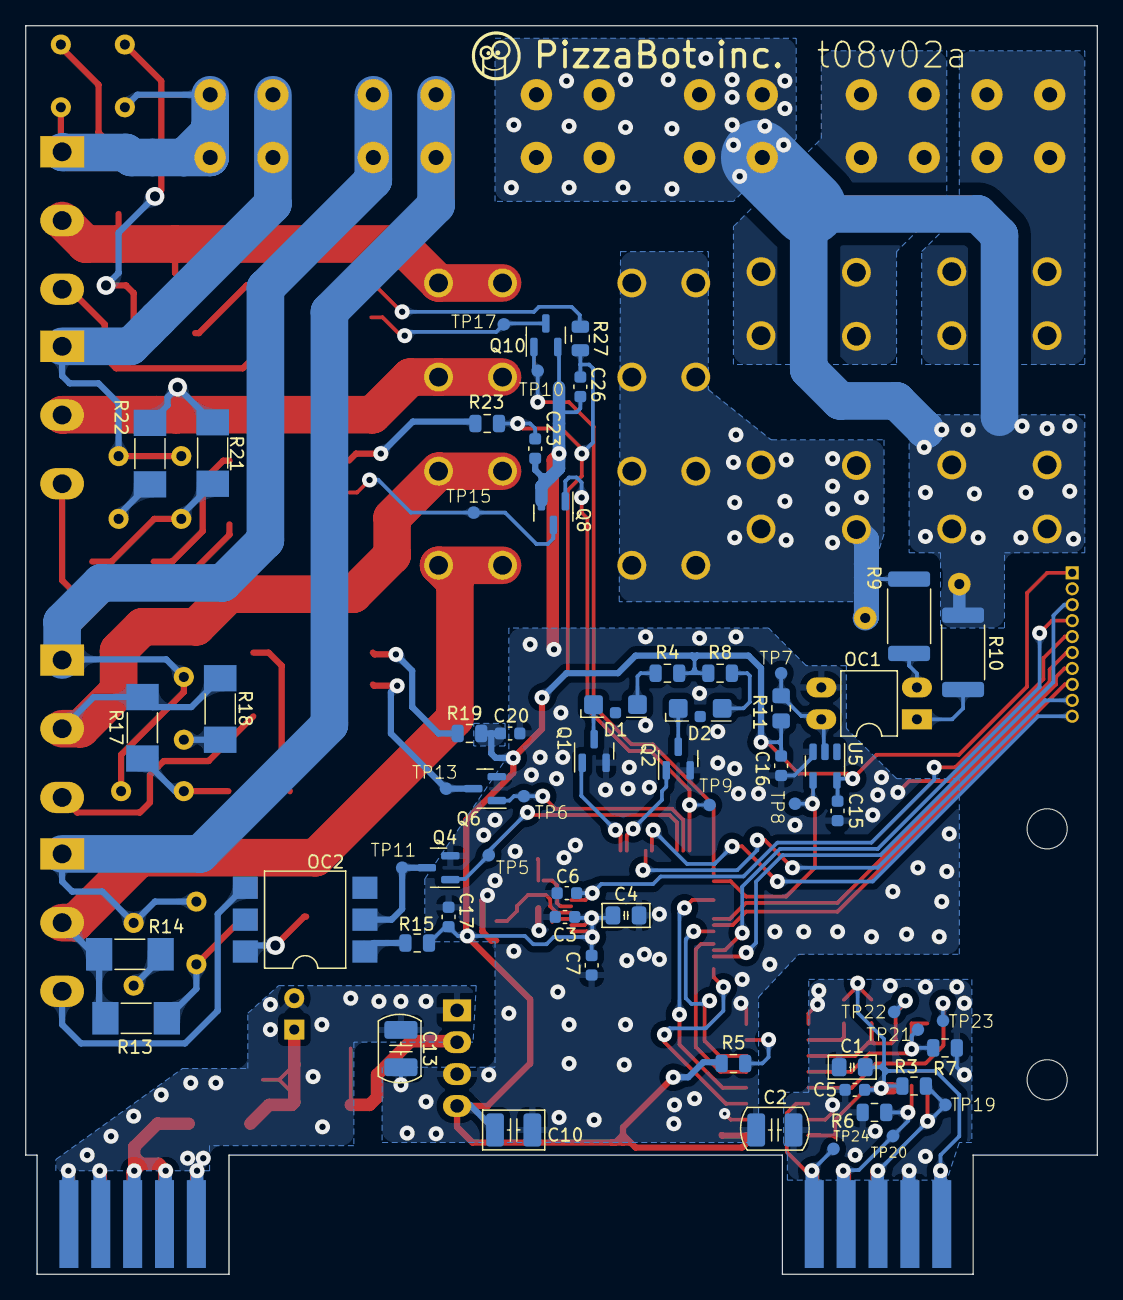
[picture p28: board triac_board.kicad_pcb from below]

Board: 2 copper layers, 85.4 x 99.5 mm, 117 parts (61 on the bottom side), 79 nets.
