borzeman/PzbElectronics/analog_io_board/analog_io_board.kicad_pcb

## KiCad design analog_io_board/analog_io_board.kicad_pcb (2025-10-31)

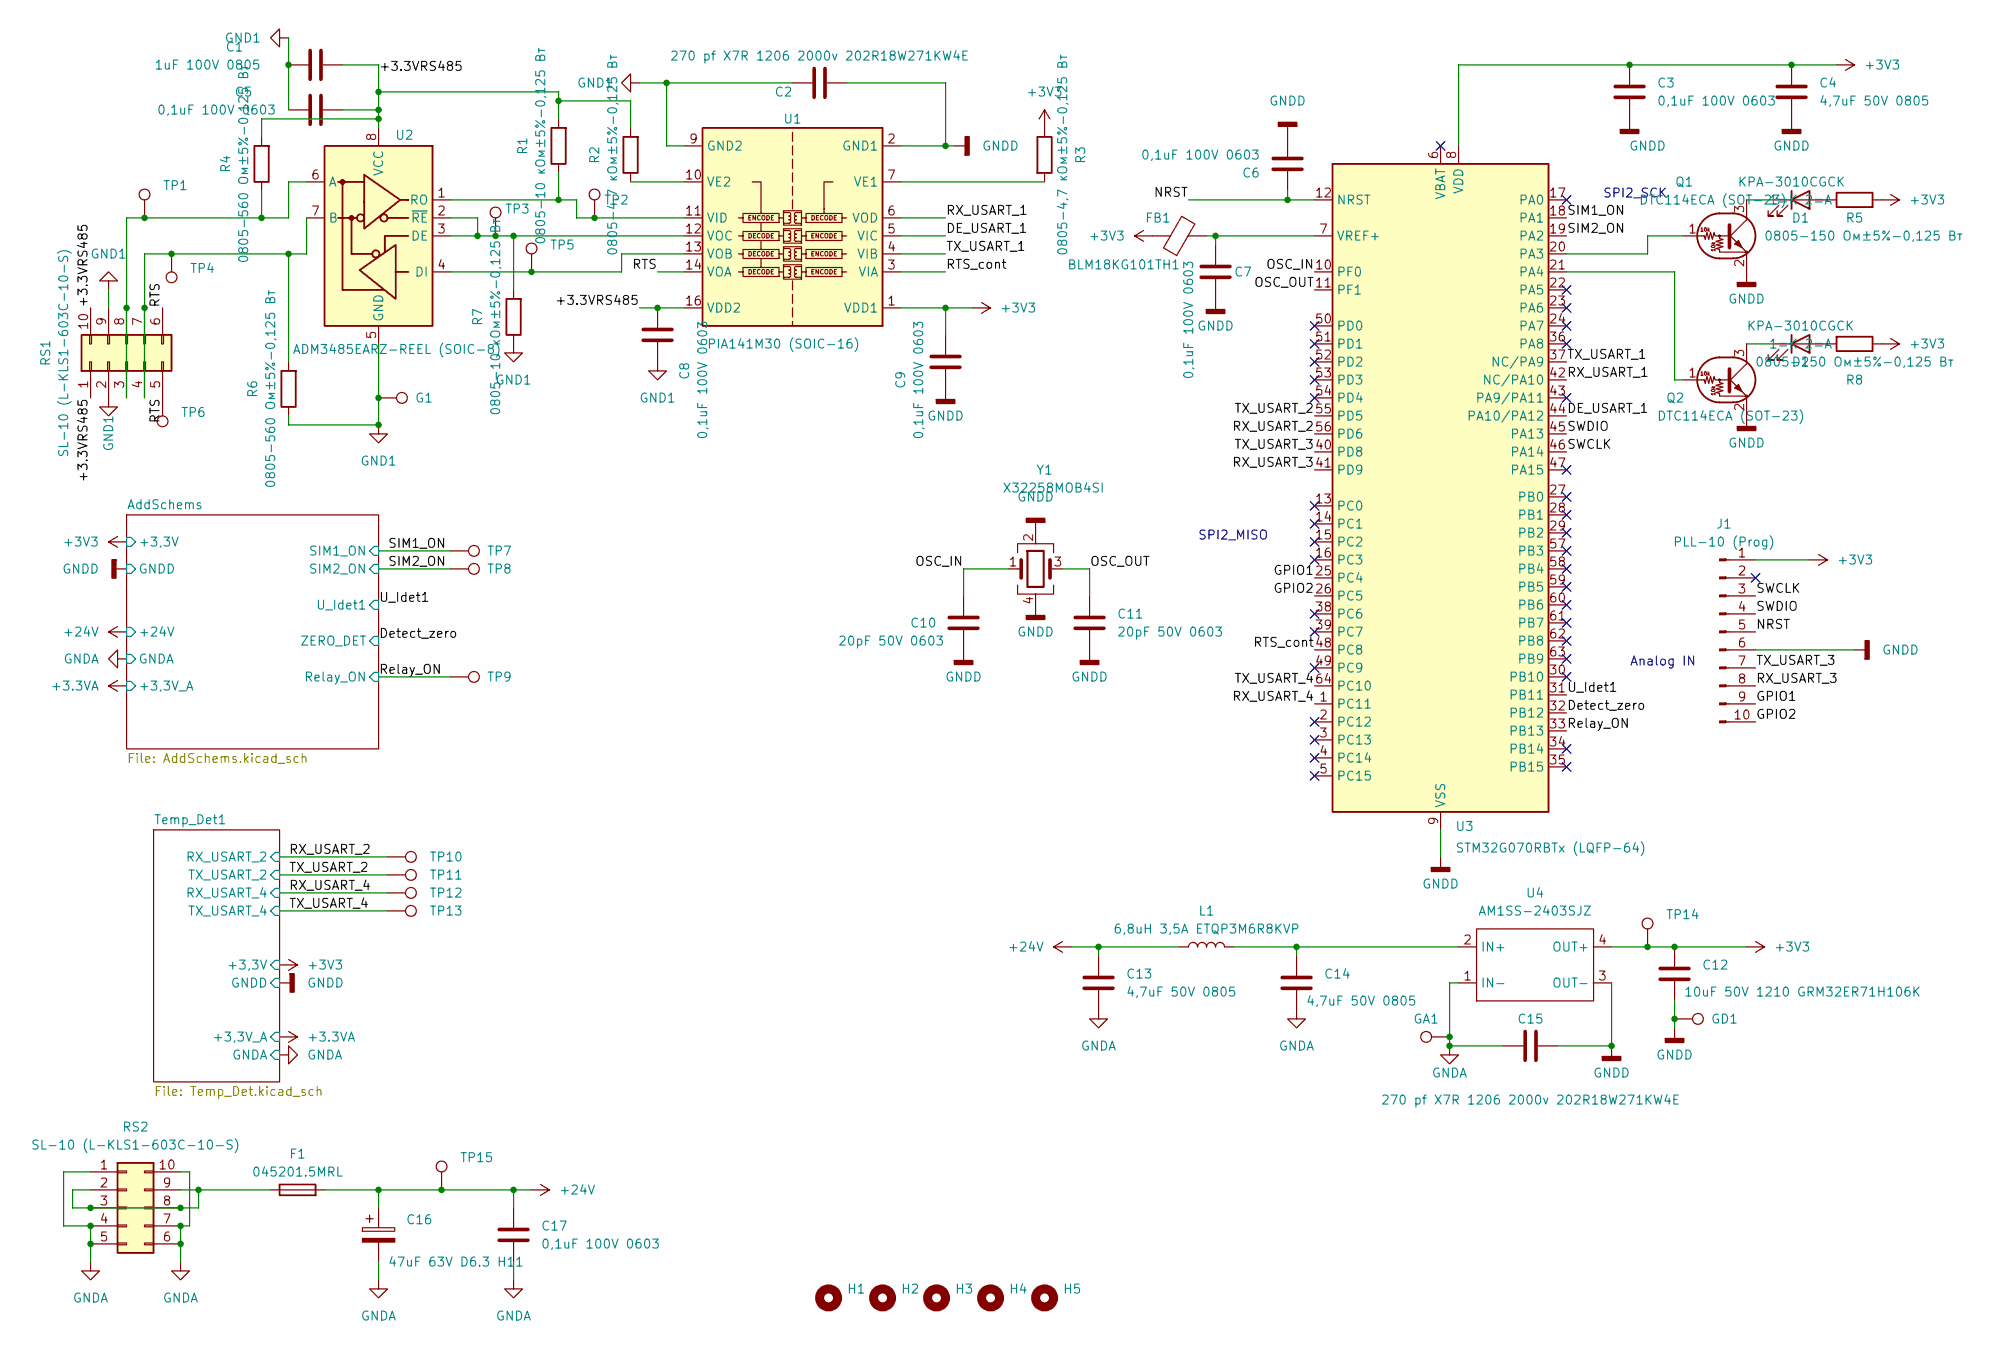
[picture p29: schematic analog_io_board.kicad_sch]

Parts:
C1: 1uF 100V 0805; C_0805_2012Metric
C2, C15: 270 pf X7R 1206 2000v 202R18W271KW4E; L_1210_3225Metric
C3, C5, C6, C7, C8, C9, C17: 0,1uF 100V 0603; C_0603_1608Metric
C4, C13, C14: 4,7uF 50V 0805; C_0805_2012Metric
C10, C11: 20pF 50V 0603; C_0603_1608Metric
C12: 10uF 50V 1210 GRM32ER71H106K; C_1210_3225Metric
C16: 47uF 63V D6.3 H11; C_Radial_D6.3mm_H11.0mm_P2.50mm
D1, D2: KPA-3010CGCK; LED_Kingbright_KPA-3010_3x2x1mm
F1: 045201.5MRL; Fuse_Littelfuse-NANO2-451_453
FB1: BLM18KG101TH1; L_0603_1608Metric
G1: TestPoint; TestPoint_Pad_D1.0mm
GA1: TestPoint; TestPoint_Pad_D1.0mm
GD1: TestPoint; TestPoint_Pad_D1.0mm
H1, H2, H3, H4, H5: MountingHole; MountingHole_3.2mm_M3
J1: PLL-10 (Prog); PinHeader_1x10_P1.27mm_Vertical
L1: 6,8uH 3,5A ETQP3M6R8KVP; L_Bourns-SRN6028
Q1, Q2: DTC114ECA (SOT-23); SOT-23
R1, R7: 0805-10 кОм±5%-0,125 Вт; R_0805_2012Metric
R2, R3: 0805-4,7 кОм±5%-0,125 Вт; R_0805_2012Metric
R4, R6: 0805-560 Ом±5%-0,125 Вт; R_0805_2012Metric
R5, R8: 0805-150 Ом±5%-0,125 Вт; R_0805_2012Metric
RS1, RS2: SL-10 (L-KLS1-603C-10-S); Edge_Conn_KLS1-603-10
TP1, TP2, TP3, TP4, TP5, TP6, TP7, TP8, TP9, TP10, TP11, TP12, TP13, TP14, TP15: TestPoint; TestPoint_Pad_D1.0mm
U1: PIA141M30 (SOIC-16); SOIC-16_3.9x9.9mm_P1.27mm
U2: ADM3485EARZ-REEL (SOIC-8); SOIC-8_3.9x4.9mm_P1.27mm
U3: STM32G070RBTx (LQFP-64); LQFP-64_10x10mm_P0.5mm
U4: AM1SS-2403SJZ; Converter_DCDC_Murata_MEE1SxxxxSC_THT
Y1: X32258MOB4SI; Crystal_SMD_3225-4Pin_3.2x2.5mm

Connections:
+3V3: C3.1, C4.1, C9.2, C12.1, FB1.1, J1.1, R3.1, R5.2, R8.1, TP14.1, U1.1 (VDD1), U3.8 (VDD), U4.4 (OUT+); also elsewhere on the board
+24V: C13.1, C16.1, C17.1, F1.2, L1.1, TP15.1; also elsewhere on the board
/+3.3VRS485: C1.2, C5.2, C8.2, R1.2, R2.2, R4.2, RS1.1, RS1.10, U1.16 (VDD2), U2.8 (VCC)
/DE_USART_1: U1.5 (VIC), U3.44 (PA10/PA12)
/Detect_zero: U3.32 (PB12); also elsewhere on the board
/GPIO1: J1.9, U3.25 (PC4)
/GPIO2: J1.10, U3.26 (PC5)
/NRST: C6.1, J1.5, U3.12 (NRST)
/OSC_IN: C10.1, U3.10 (PF0), Y1.1
/OSC_OUT: C11.1, U3.11 (PF1), Y1.3
/RTS: RS1.5, RS1.6, TP6.1, U1.14 (VOA)
/RTS_cont: U1.3 (VIA), U3.48 (PC8)
/RX_USART_1: U1.6 (VOD), U3.42 (NC/PA10)
/RX_USART_2: TP10.1, U3.56 (PD6); also elsewhere on the board
/RX_USART_3: J1.8, U3.41 (PD9)
/RX_USART_4: TP12.1, U3.1 (PC11); also elsewhere on the board
/Relay_ON: TP9.1, U3.33 (PB13); also elsewhere on the board
/SIM1_ON: TP7.1, U3.18 (PA1); also elsewhere on the board
/SIM2_ON: TP8.1, U3.19 (PA2); also elsewhere on the board
/SWCLK: J1.3, U3.46 (PA14)
/SWDIO: J1.4, U3.45 (PA13)
/TX_USART_1: U1.4 (VIB), U3.37 (NC/PA9)
/TX_USART_2: TP11.1, U3.55 (PD5); also elsewhere on the board
/TX_USART_3: J1.7, U3.40 (PD8)
/TX_USART_4: TP13.1, U3.64 (PC10); also elsewhere on the board
/U_Idet1: U3.31 (PB11); also elsewhere on the board
GND1: C1.1, C2.1, C5.1, C8.1, G1.1, R6.1, R7.1, RS1.2, RS1.9, U1.9 (GND2), U1.15 (GND2), U2.5 (GND)
GNDA: C13.2, C14.2, C15.1, C16.2, C17.2, GA1.1, RS2.1, RS2.4, RS2.5, RS2.6, RS2.7, RS2.10, U4.1 (IN-); also elsewhere on the board
GNDD: C2.2, C3.2, C4.2, C6.2, C7.2, C9.1, C10.2, C11.2, C12.2, C15.2, GD1.1, J1.6, Q1.2 (E), Q2.2 (E), U1.2 (GND1), U1.8 (GND1), U3.9 (VSS), U4.3 (OUT-), Y1.2, Y1.4; also elsewhere on the board
unnamed: D1.2 (A), R5.1
unnamed: D1.1 (K), Q1.3 (C)
unnamed: D2.2 (A), R8.2
unnamed: D2.1 (K), Q2.3 (C)
unnamed: Q1.1 (B), U3.20 (PA3)
unnamed: Q2.1 (B), U3.21 (PA4)
unnamed: R4.1, RS1.3, RS1.8, TP1.1, U2.6 (A)
unnamed: R6.2, RS1.4, RS1.7, TP4.1, U2.7 (B)
unnamed: F1.1, RS2.2, RS2.3, RS2.8, RS2.9
unnamed: R3.2, U1.7 (VE1)
unnamed: R2.1, U1.10 (VE2)
unnamed: R1.1, TP2.1, U1.11 (VID), U2.1 (RO)
unnamed: TP5.1, U1.13 (VOB), U2.4 (DI)
unnamed: R7.2, TP3.1, U1.12 (VOC), U2.2 (~RE), U2.3 (DE)
unnamed: C7.1, FB1.2, U3.7 (VREF+)
unnamed: C14.1, L1.2, U4.2 (IN+)

Notes on the sheet:
SPI2_SCK
SPI2_MISO
Analog IN

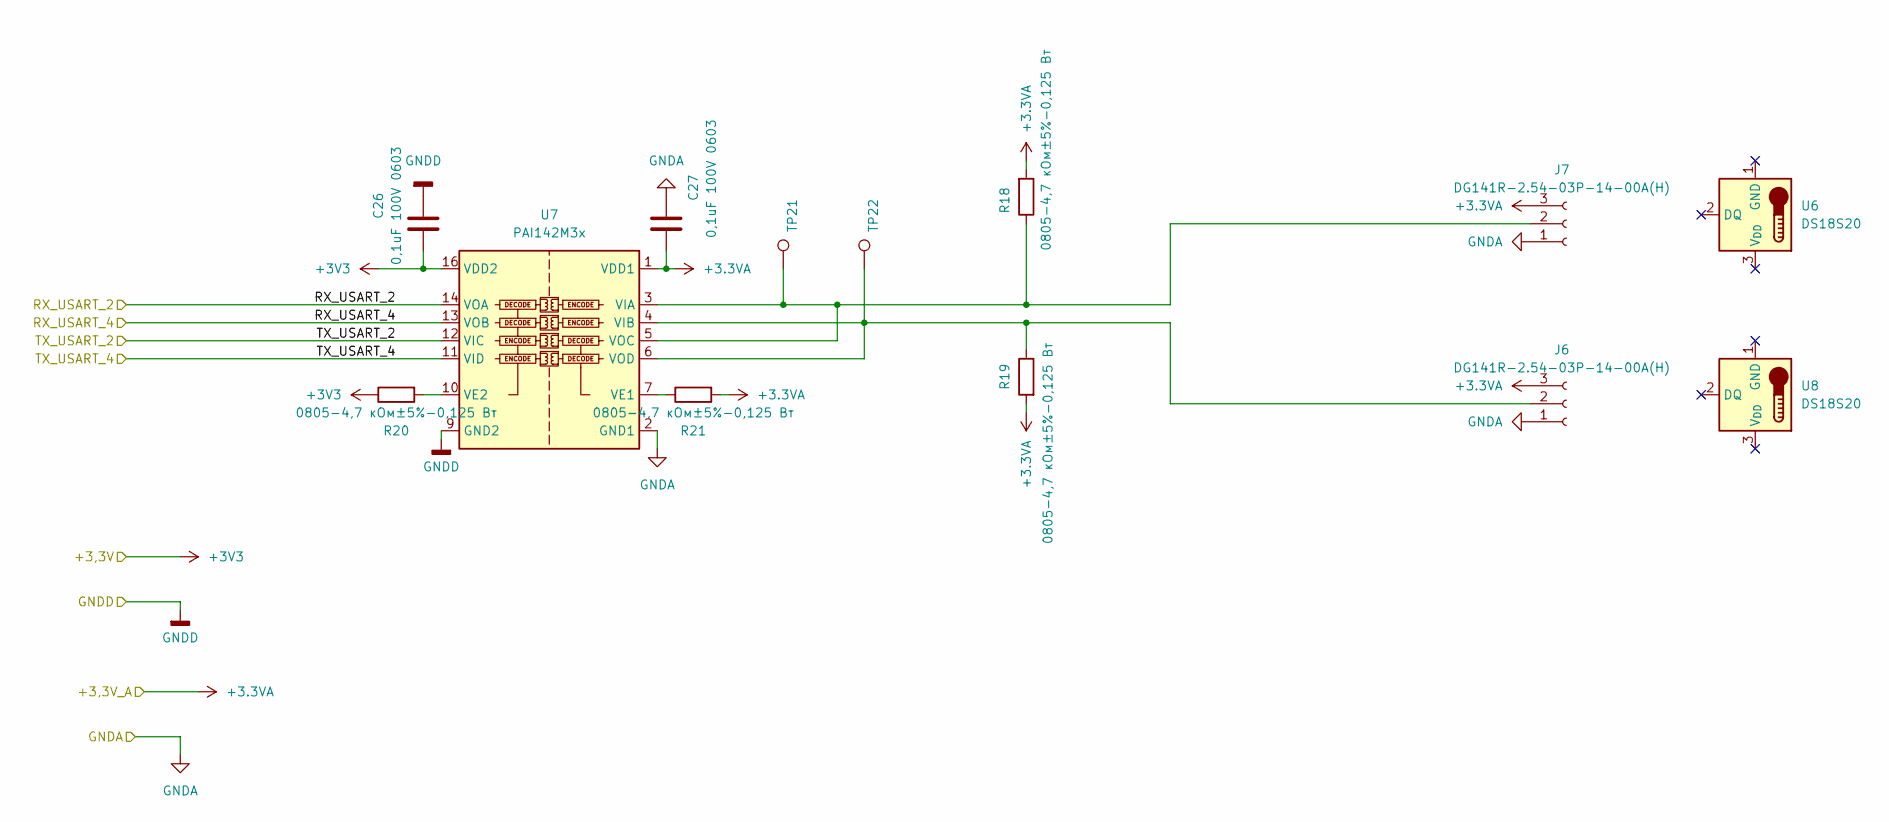
[picture p30: schematic Temp_Det.kicad_sch]

Parts:
C26, C27: 0,1uF 100V 0603; C_0603_1608Metric
J6, J7: DG141R-2.54-03P-14-00A(H); DG141R-2.54-03P
R18, R19, R20, R21: 0805-4,7 кОм±5%-0,125 Вт; R_0805_2012Metric
TP21, TP22: TestPoint; TestPoint_Pad_D1.0mm
U6, U8: DS18S20; TO-92_Inline
U7: PAI142M3x; SOIC-16_3.9x9.9mm_P1.27mm

Connections:
+3.3VA: C27.2, J6.3, J7.3, R18.2, R19.2, R21.2, U7.1 (VDD1); also elsewhere on the board
+3V3: C26.2, R20.1, U7.16 (VDD2); also elsewhere on the board
/RX_USART_2: U7.14 (VOA); also elsewhere on the board
/RX_USART_4: U7.13 (VOB); also elsewhere on the board
/TX_USART_2: U7.12 (VIC); also elsewhere on the board
/TX_USART_4: U7.11 (VID); also elsewhere on the board
GNDA: C27.1, J6.1, J7.1, U7.2 (GND1), U7.8 (GND1); also elsewhere on the board
GNDD: C26.1, U7.9 (GND2), U7.15 (GND2); also elsewhere on the board
unnamed: J6.2, R19.1, TP22.1, U7.4 (VIB), U7.6 (VOD)
unnamed: J7.2, R18.1, TP21.1, U7.3 (VIA), U7.5 (VOC)
unnamed: R21.1, U7.7 (VE1)
unnamed: R20.2, U7.10 (VE2)

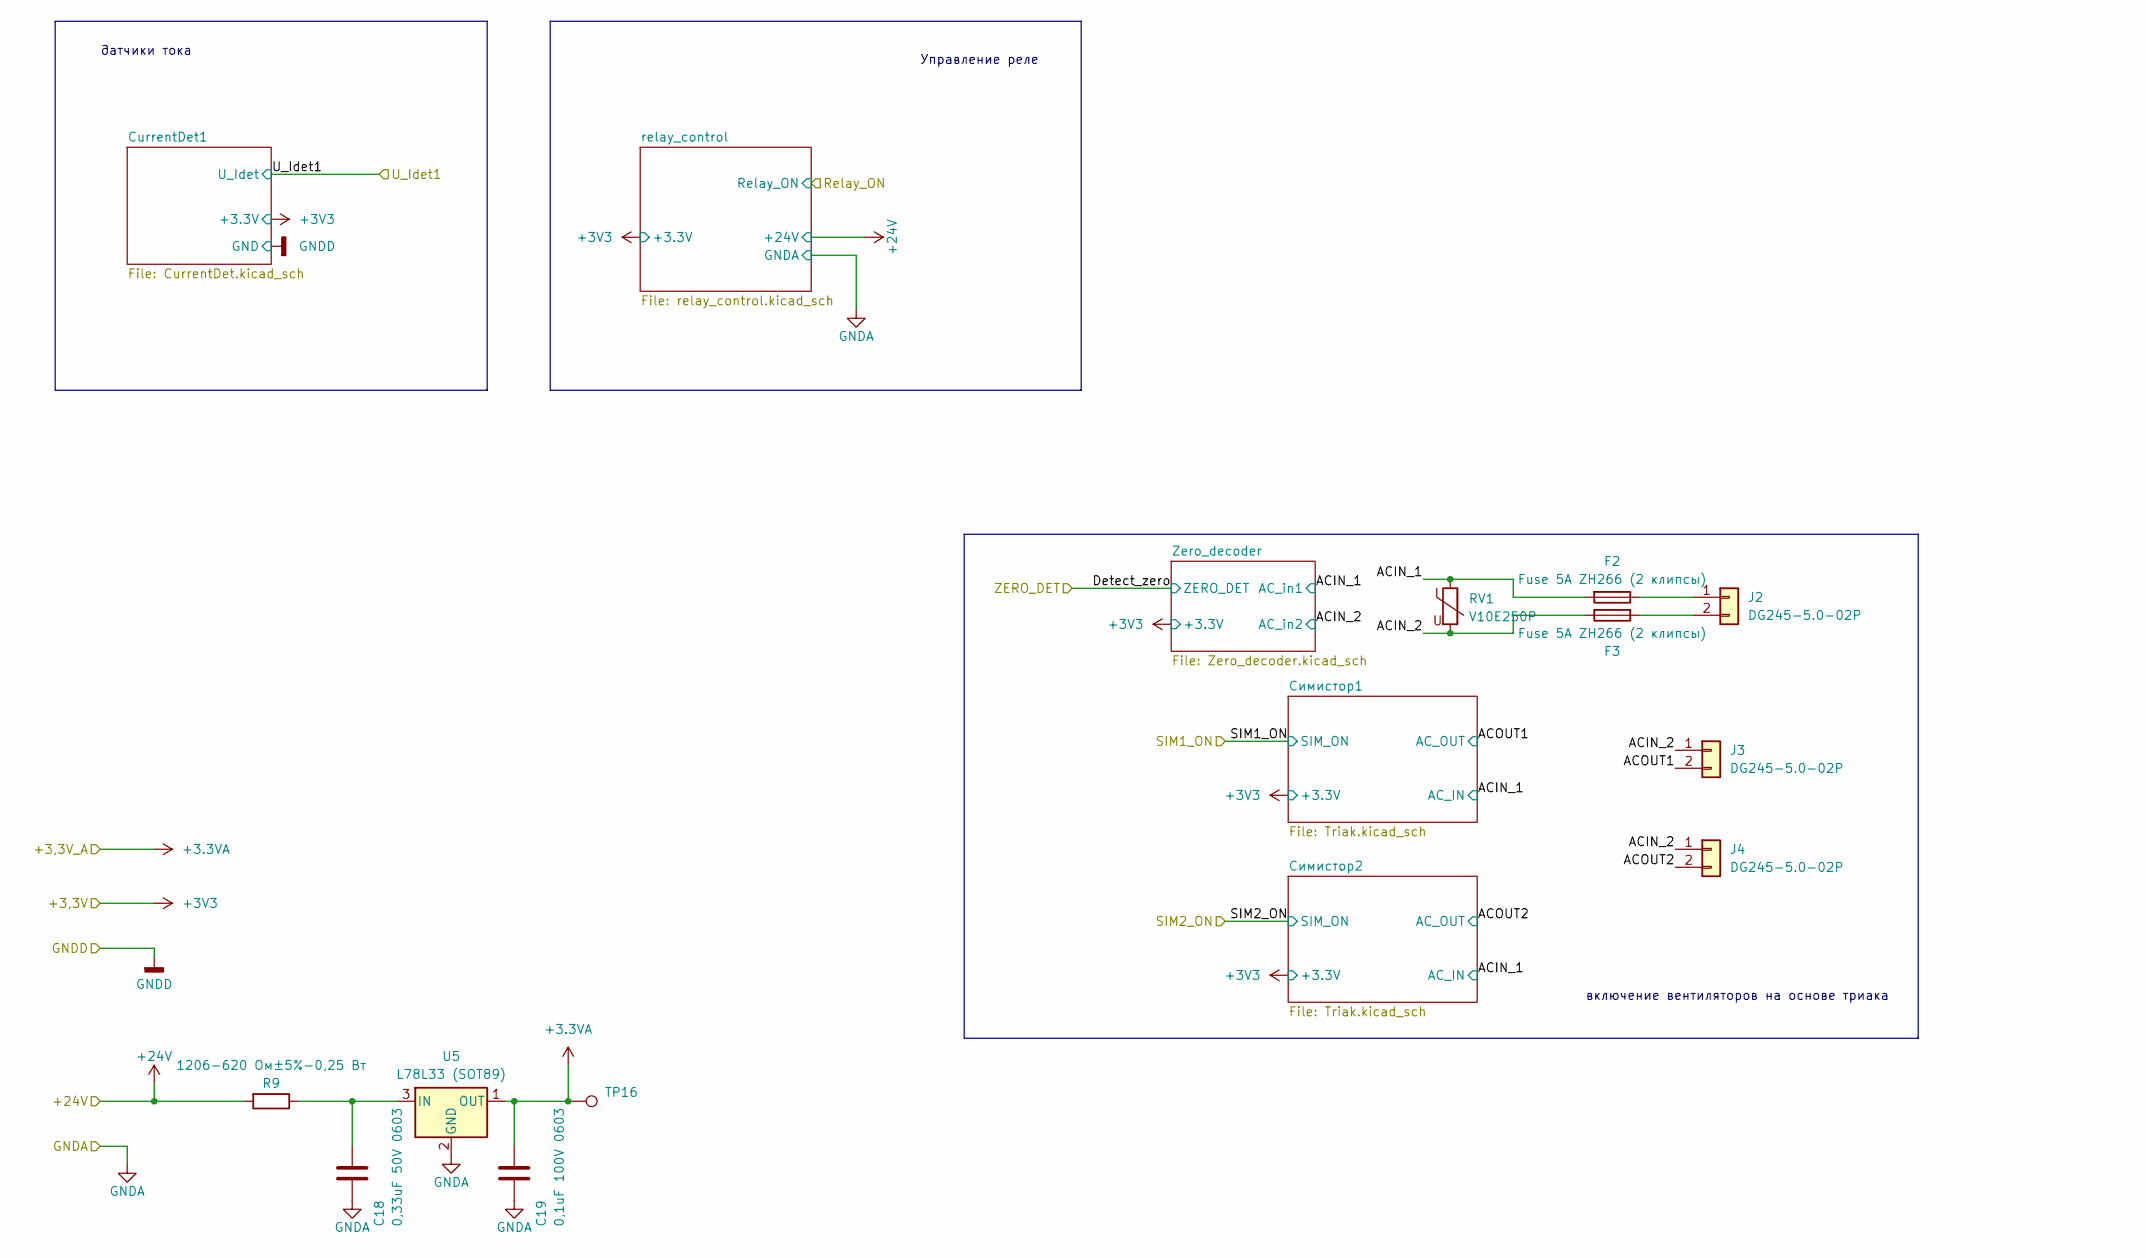
[picture p31: schematic AddSchems.kicad_sch]

Parts:
C18: 0,33uF 50V 0603; C_0603_1608Metric
C19: 0,1uF 100V 0603; C_0603_1608Metric
F2, F3: Fuse 5A ZH266 (2 клипсы); Fuseholder_100_series_5x20mm_D1,5
J2, J3, J4: DG245-5.0-02P
R9: 1206-620 Ом±5%-0,25 Вт; R_1206_3216Metric
RV1: V10E250P; RV_Disc_D12mm_W5.8mm_P7.5mm
TP16: TestPoint; TestPoint_Pad_D1.0mm
U5: L78L33 (SOT89); SOT-89-3

Connections:
+3.3VA: C19.1, TP16.1, U5.1 (OUT); also elsewhere on the board
+24V: R9.2; also elsewhere on the board
/AddSchems/ACIN_1: F2.2, RV1.1; also elsewhere on the board
/AddSchems/ACIN_2: F3.1, J3.1, J4.1, RV1.2; also elsewhere on the board
/AddSchems/ACOUT1: J3.2; also elsewhere on the board
/AddSchems/ACOUT2: J4.2; also elsewhere on the board
GNDA: C18.2, C19.2, U5.2 (GND); also elsewhere on the board
unnamed: F2.1, J2.1
unnamed: F3.2, J2.2
unnamed: C18.1, R9.1, U5.3 (IN)

Notes on the sheet:
Управление реле
включение вентиляторов на основе триака
датчики тока

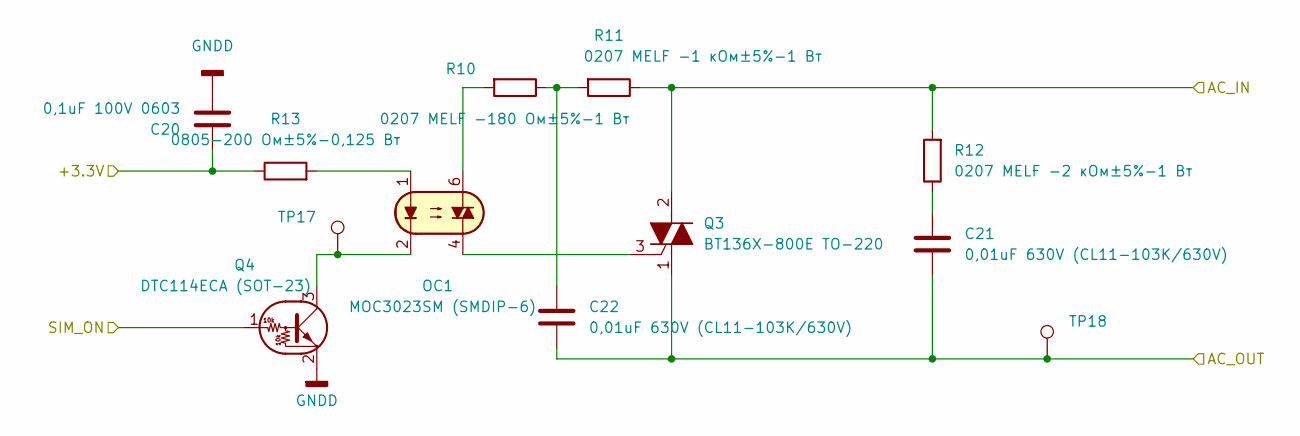
[picture p32: schematic Triak.kicad_sch]

Parts:
C20: 0,1uF 100V 0603; C_0603_1608Metric
C21, C22: 0,01uF 630V (CL11-103K/630V); C_Rect_L7.0mm_W4.5mm_P5.00mm
OC1: MOC3023SM (SMDIP-6); SMDIP-6_W9.53mm
Q3: BT136X-800E TO-220; TO-220-3_Horizontal_TabDown
Q4: DTC114ECA (SOT-23); SOT-23
R10: 0207 MELF -180 Ом±5%-1 Вт; R_MELF_MMB-0207
R11: 0207 MELF -1 кОм±5%-1 Вт; R_MELF_MMB-0207
R12: 0207 MELF -2 кОм±5%-1 Вт; R_MELF_MMB-0207
R13: 0805-200 Ом±5%-0,125 Вт; R_0805_2012Metric
TP17, TP18: TestPoint; TestPoint_Pad_D1.0mm

Connections:
+3V3: C20.1, R13.1; also elsewhere on the board
/AddSchems/ACIN_1: Q3.2 (A2), R11.1, R12.2; also elsewhere on the board
/AddSchems/ACOUT1: C21.2, C22.2, Q3.1 (A1), TP18.1; also elsewhere on the board
/SIM1_ON: Q4.1 (B); also elsewhere on the board
GNDD: C20.2, Q4.2 (E); also elsewhere on the board
unnamed: C21.1, R12.1
unnamed: C22.1, R10.1, R11.2
unnamed: OC1.1, R13.2
unnamed: OC1.6, R10.2
unnamed: OC1.4, Q3.3 (G)
unnamed: OC1.2, Q4.3 (C), TP17.1

Parts of its further copies:
C23: 0,1uF 100V 0603; C_0603_1608Metric
C24, C39: 0,01uF 630V (CL11-103K/630V); C_Rect_L7.0mm_W4.5mm_P5.00mm
OC2: MOC3023SM (SMDIP-6); SMDIP-6_W9.53mm
Q5: BT136X-800E TO-220; TO-220-3_Horizontal_TabDown
Q6: DTC114ECA (SOT-23); SOT-23
R17: 0805-200 Ом±5%-0,125 Вт; R_0805_2012Metric
R38: 0207 MELF -2 кОм±5%-1 Вт; R_MELF_MMB-0207
R39: 0207 MELF -180 Ом±5%-1 Вт; R_MELF_MMB-0207
R40: 0207 MELF -1 кОм±5%-1 Вт; R_MELF_MMB-0207
TP19, TP20: TestPoint; TestPoint_Pad_D1.0mm

Connections of its further copies:
+3V3: C23.1, R17.1; also elsewhere on the board
/AddSchems/ACIN_1: Q5.2 (A2), R38.2, R40.1; also elsewhere on the board
/AddSchems/ACOUT2: C24.2, C39.2, Q5.1 (A1), TP20.1; also elsewhere on the board
/SIM2_ON: Q6.1 (B); also elsewhere on the board
GNDD: C23.2, Q6.2 (E); also elsewhere on the board
unnamed: C24.1, R39.1, R40.2
unnamed: C39.1, R38.1
unnamed: OC2.1, R17.2
unnamed: OC2.6, R39.2
unnamed: OC2.4, Q5.3 (G)
unnamed: OC2.2, Q6.3 (C), TP19.1

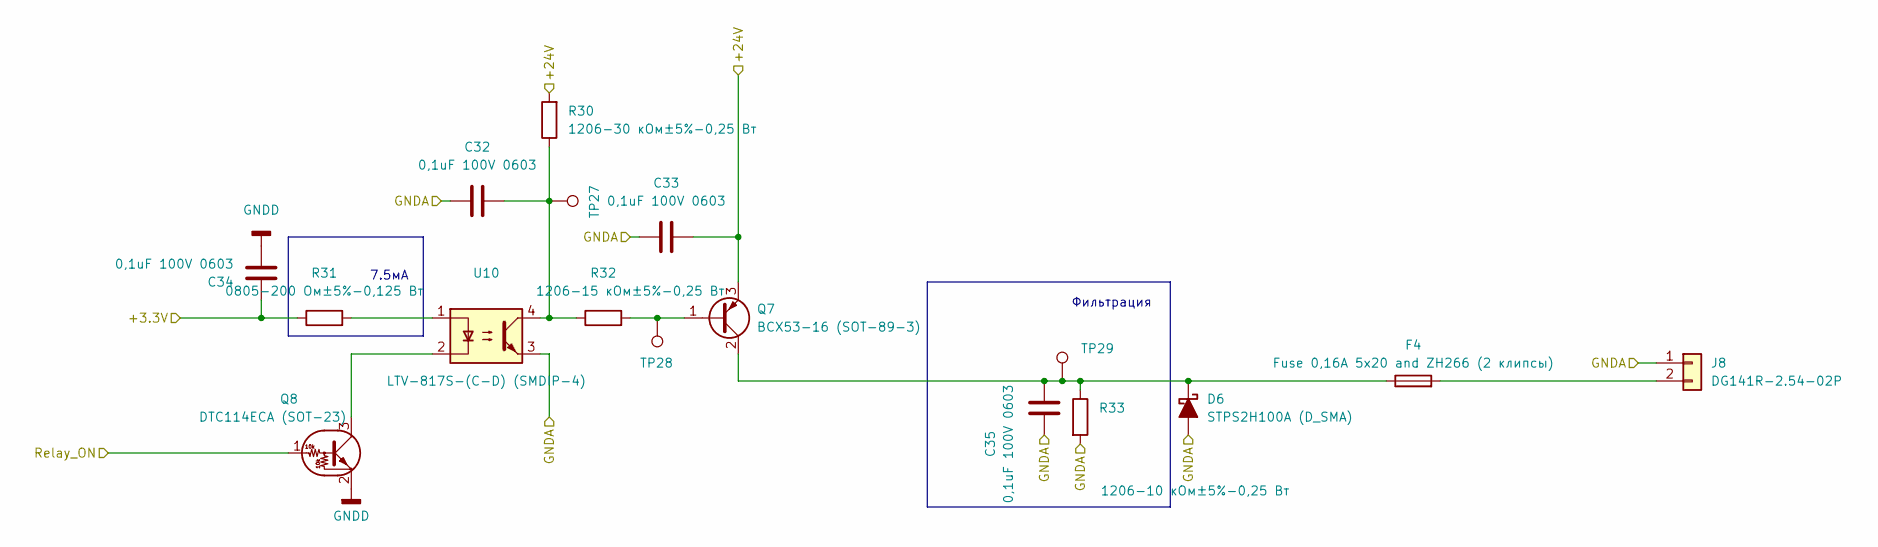
[picture p33: schematic relay_control.kicad_sch]

Parts:
C32, C33, C34, C35: 0,1uF 100V 0603; C_0603_1608Metric
D6: STPS2H100A (D_SMA); D_SMA
F4: Fuse 0,16A 5x20 and ZH266 (2 клипсы); Fuseholder_100_series_5x20mm_D1,5
J8: DG141R-2.54-02P; DG141R-02
Q7: BCX53-16 (SOT-89-3); SOT-89-3
Q8: DTC114ECA (SOT-23); SOT-23
R30: 1206-30 кОм±5%-0,25 Вт; R_1206_3216Metric
R31: 0805-200 Ом±5%-0,125 Вт; R_0805_2012Metric
R32: 1206-15 кОм±5%-0,25 Вт; R_1206_3216Metric
R33: 1206-10 кОм±5%-0,25 Вт; R_1206_3216Metric
TP27, TP28, TP29: TestPoint; TestPoint_Pad_D1.0mm
U10: LTV-817S-(С-D) (SMDIP-4); SMDIP-4_W9.53mm

Connections:
+3V3: C34.1, R31.1; also elsewhere on the board
+24V: C33.1, Q7.3 (E), R30.2; also elsewhere on the board
/Relay_ON: Q8.1 (B); also elsewhere on the board
GNDA: C32.2, C33.2, C35.2, D6.2 (A), J8.1, R33.2, U10.3; also elsewhere on the board
GNDD: C34.2, Q8.2 (E); also elsewhere on the board
unnamed: C32.1, R30.1, R32.1, TP27.1, U10.4
unnamed: C35.1, D6.1 (K), F4.1, Q7.2 (C), R33.1, TP29.1
unnamed: F4.2, J8.2
unnamed: Q7.1 (B), R32.2, TP28.1
unnamed: Q8.3 (C), U10.2
unnamed: R31.2, U10.1

Parts of its further copies:
C23: 0,1uF 100V 0603; C_0603_1608Metric
Q6: DTC114ECA (SOT-23); SOT-23

Connections of its further copies:
+3V3: C23.1; also elsewhere on the board
/SIM2_ON: Q6.1 (B); also elsewhere on the board
GNDD: C23.2, Q6.2 (E); also elsewhere on the board
unnamed 64: Q6.3 (C); also elsewhere on the board

Notes on the sheet:
7.5мА
Фильтрация

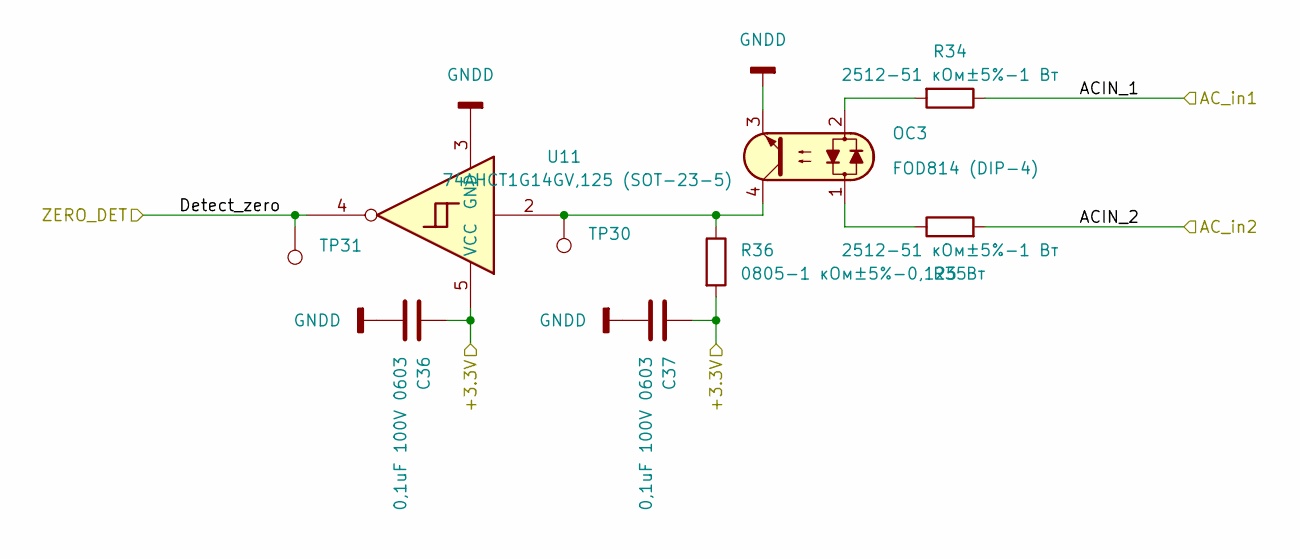
[picture p34: schematic Zero_decoder.kicad_sch]

Parts:
C36, C37: 0,1uF 100V 0603; C_0603_1608Metric
OC3: FOD814 (DIP-4); DIP-4_W7.62mm_LongPads
R34, R35: 2512-51 кОм±5%-1 Вт; R_2512_6332Metric
R36: 0805-1 кОм±5%-0,125 Вт; R_0805_2012Metric_Pad1.20x1.40mm_HandSolder
TP30, TP31: TestPoint; TestPoint_Pad_D1.0mm
U11: 74AHCT1G14GV,125 (SOT-23-5); SOT-23-5

Connections:
+3V3: C36.1, C37.1, R36.2, U11.5 (VCC); also elsewhere on the board
/AddSchems/ACIN_1: R34.1; also elsewhere on the board
/AddSchems/ACIN_2: R35.2; also elsewhere on the board
/Detect_zero: TP31.1, U11.4; also elsewhere on the board
GNDD: C36.2, C37.2, OC3.3, U11.3 (GND); also elsewhere on the board
unnamed: OC3.1, R35.1
unnamed: OC3.2, R34.2
unnamed: OC3.4, R36.1, TP30.1, U11.2

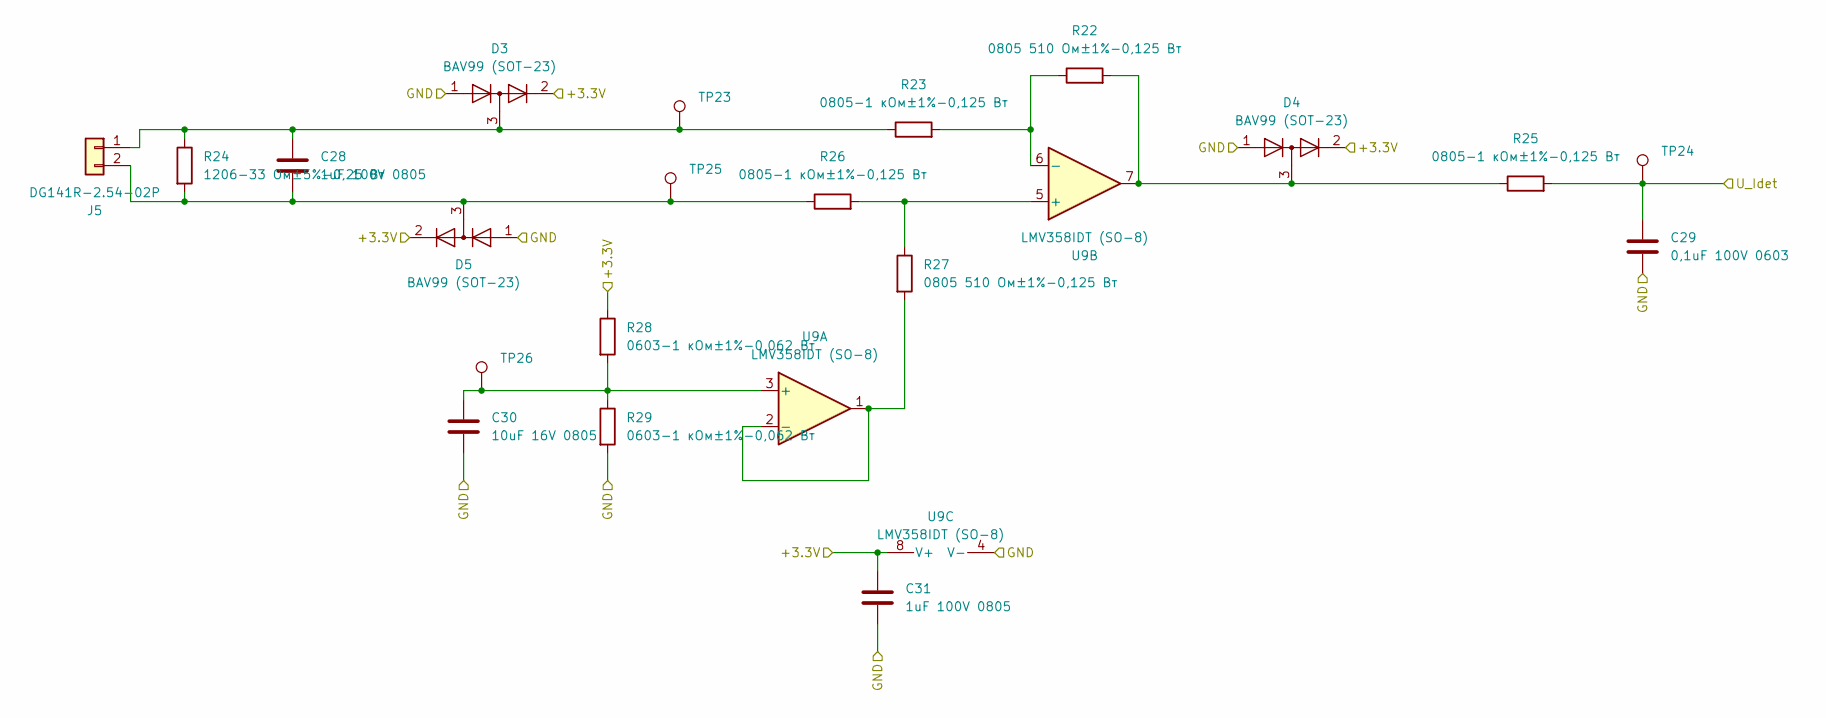
[picture p35: schematic CurrentDet.kicad_sch]

Parts:
C28, C31: 1uF 100V 0805; C_0805_2012Metric
C29: 0,1uF 100V 0603; C_0603_1608Metric
C30: 10uF 16V 0805; C_0805_2012Metric
D3, D4, D5: BAV99 (SOT-23); SOT-23
J5: DG141R-2.54-02P; DG141R-02
R22, R27: 0805 510 Ом±1%-0,125 Вт; R_0805_2012Metric
R23, R25, R26: 0805-1 кОм±1%-0,125 Вт; R_0805_2012Metric
R24: 1206-33 Ом±5%-0,25 Вт; R_1206_3216Metric_Pad1.30x1.75mm_HandSolder
R28, R29: 0603-1 кОм±1%-0,062 Вт; R_0603_1608Metric
TP23, TP24, TP25, TP26: TestPoint; TestPoint_Pad_D1.0mm
U9: LMV358IDT (SO-8); SO-8_3.9x4.9mm_P1.27mm

Connections:
+3V3: C31.1, D3.2 (A), D4.2 (A), D5.2 (A), R28.1, U9.8 (V+); also elsewhere on the board
/U_Idet1: C29.1, R25.2, TP24.1; also elsewhere on the board
GNDD: C29.2, C30.2, C31.2, D3.1 (K), D4.1 (K), D5.1 (K), R29.2, U9.4 (V-); also elsewhere on the board
unnamed: D4.3 (K), R22.2, R25.1, U9.7
unnamed: C28.1, D3.3 (K), J5.1, R23.1, R24.1, TP23.1
unnamed: C28.2, D5.3 (K), J5.2, R24.2, R26.1, TP25.1
unnamed: C30.1, R28.2, R29.1, TP26.1, U9.3 (+)
unnamed: R27.2, U9.1, U9.2 (-)
unnamed: R26.2, R27.1, U9.5 (+)
unnamed: R22.1, R23.2, U9.6 (-)
