borzeman/PzbElectronics/analog_io_board/analog_io_board.kicad_pcb

## KiCad design analog_io_board/analog_io_board.kicad_pcb (continued)

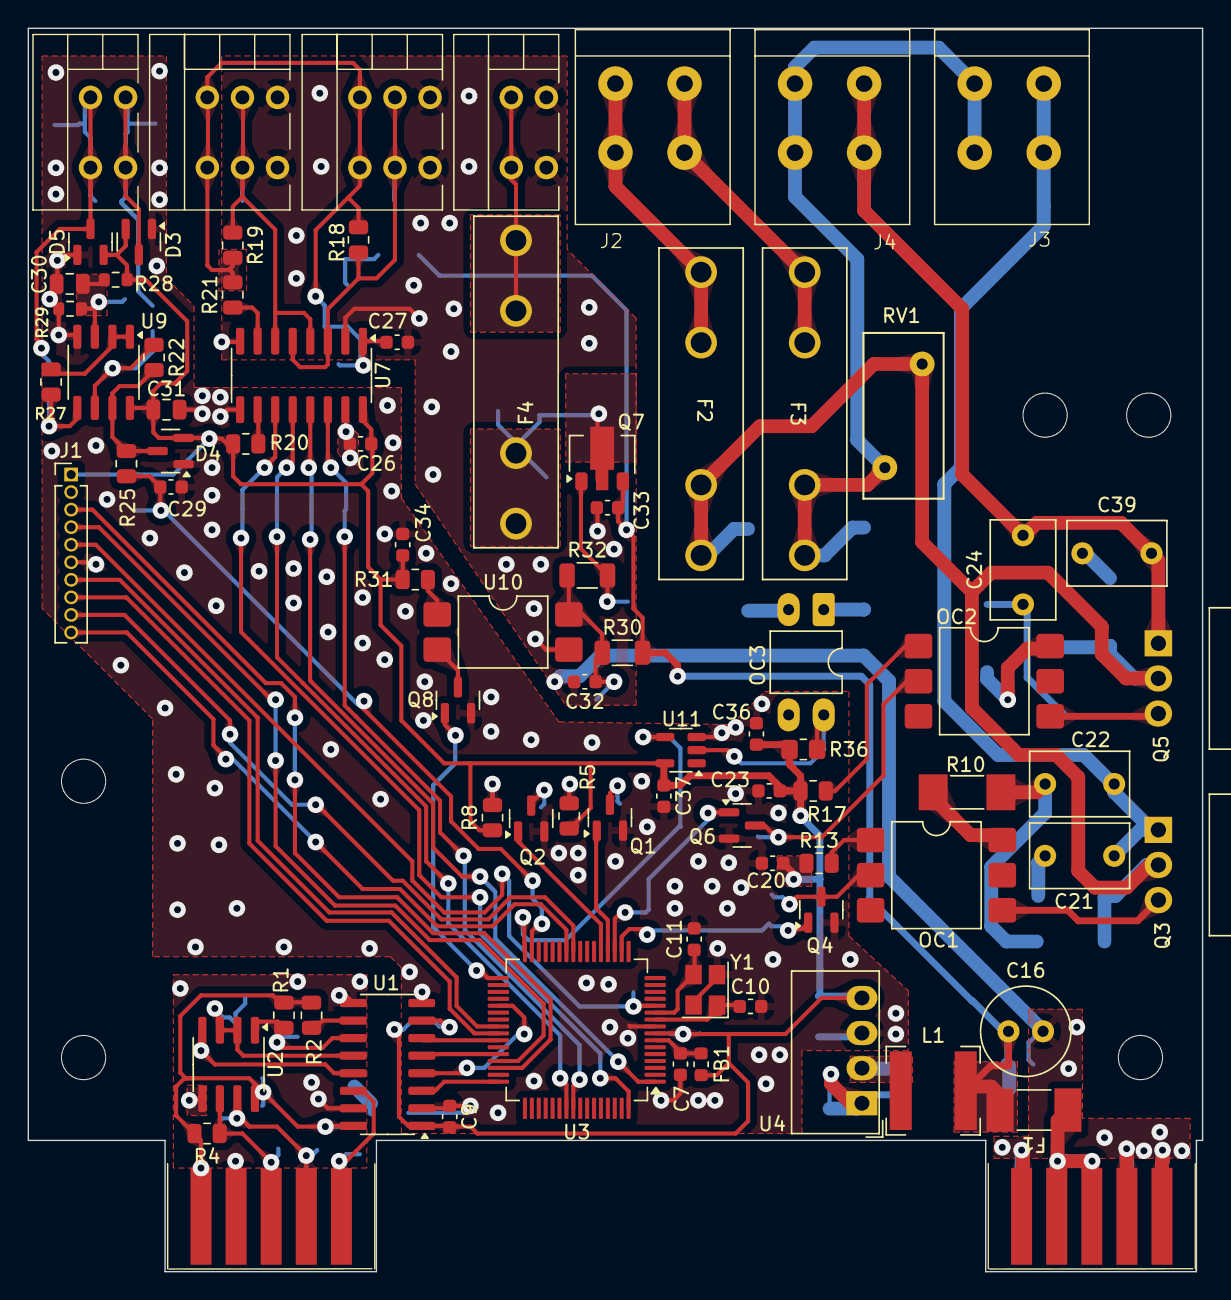
[picture p36: board analog_io_board.kicad_pcb from above]

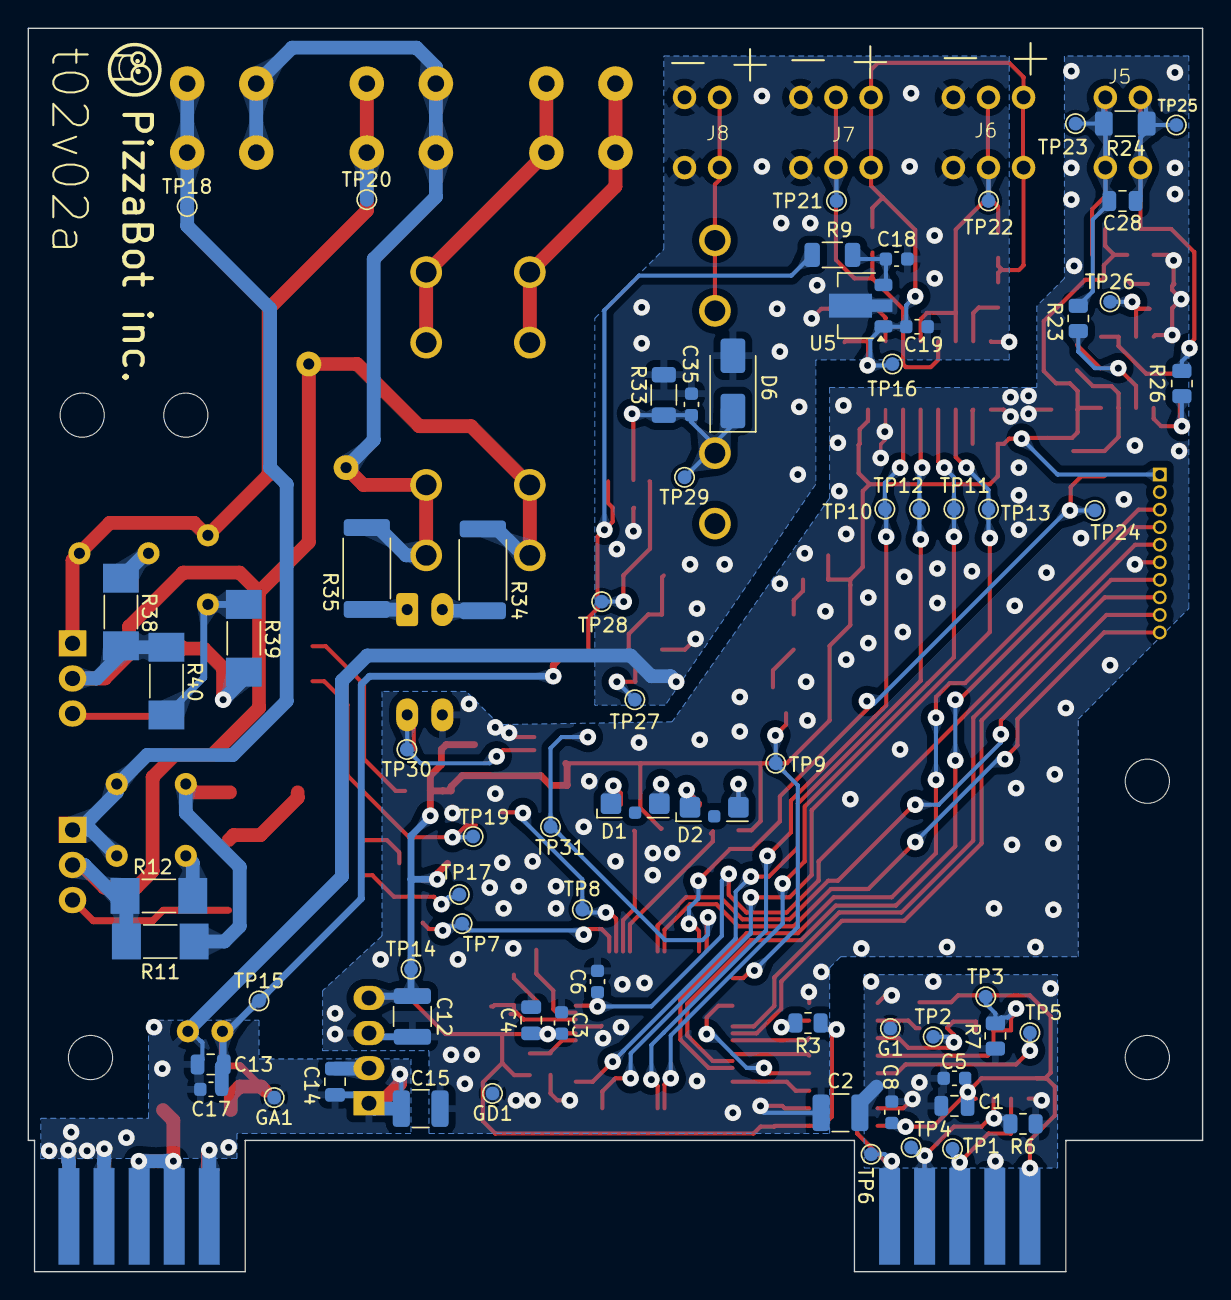
[picture p37: board analog_io_board.kicad_pcb from below]

Board: 2 copper layers, 85.0 x 90.0 mm, 156 parts (69 on the bottom side), 85 nets.
