borzeman/PzbElectronics/motherboard/motherboard.kicad_pcb

## KiCad design motherboard/motherboard.kicad_pcb (2025-10-31)

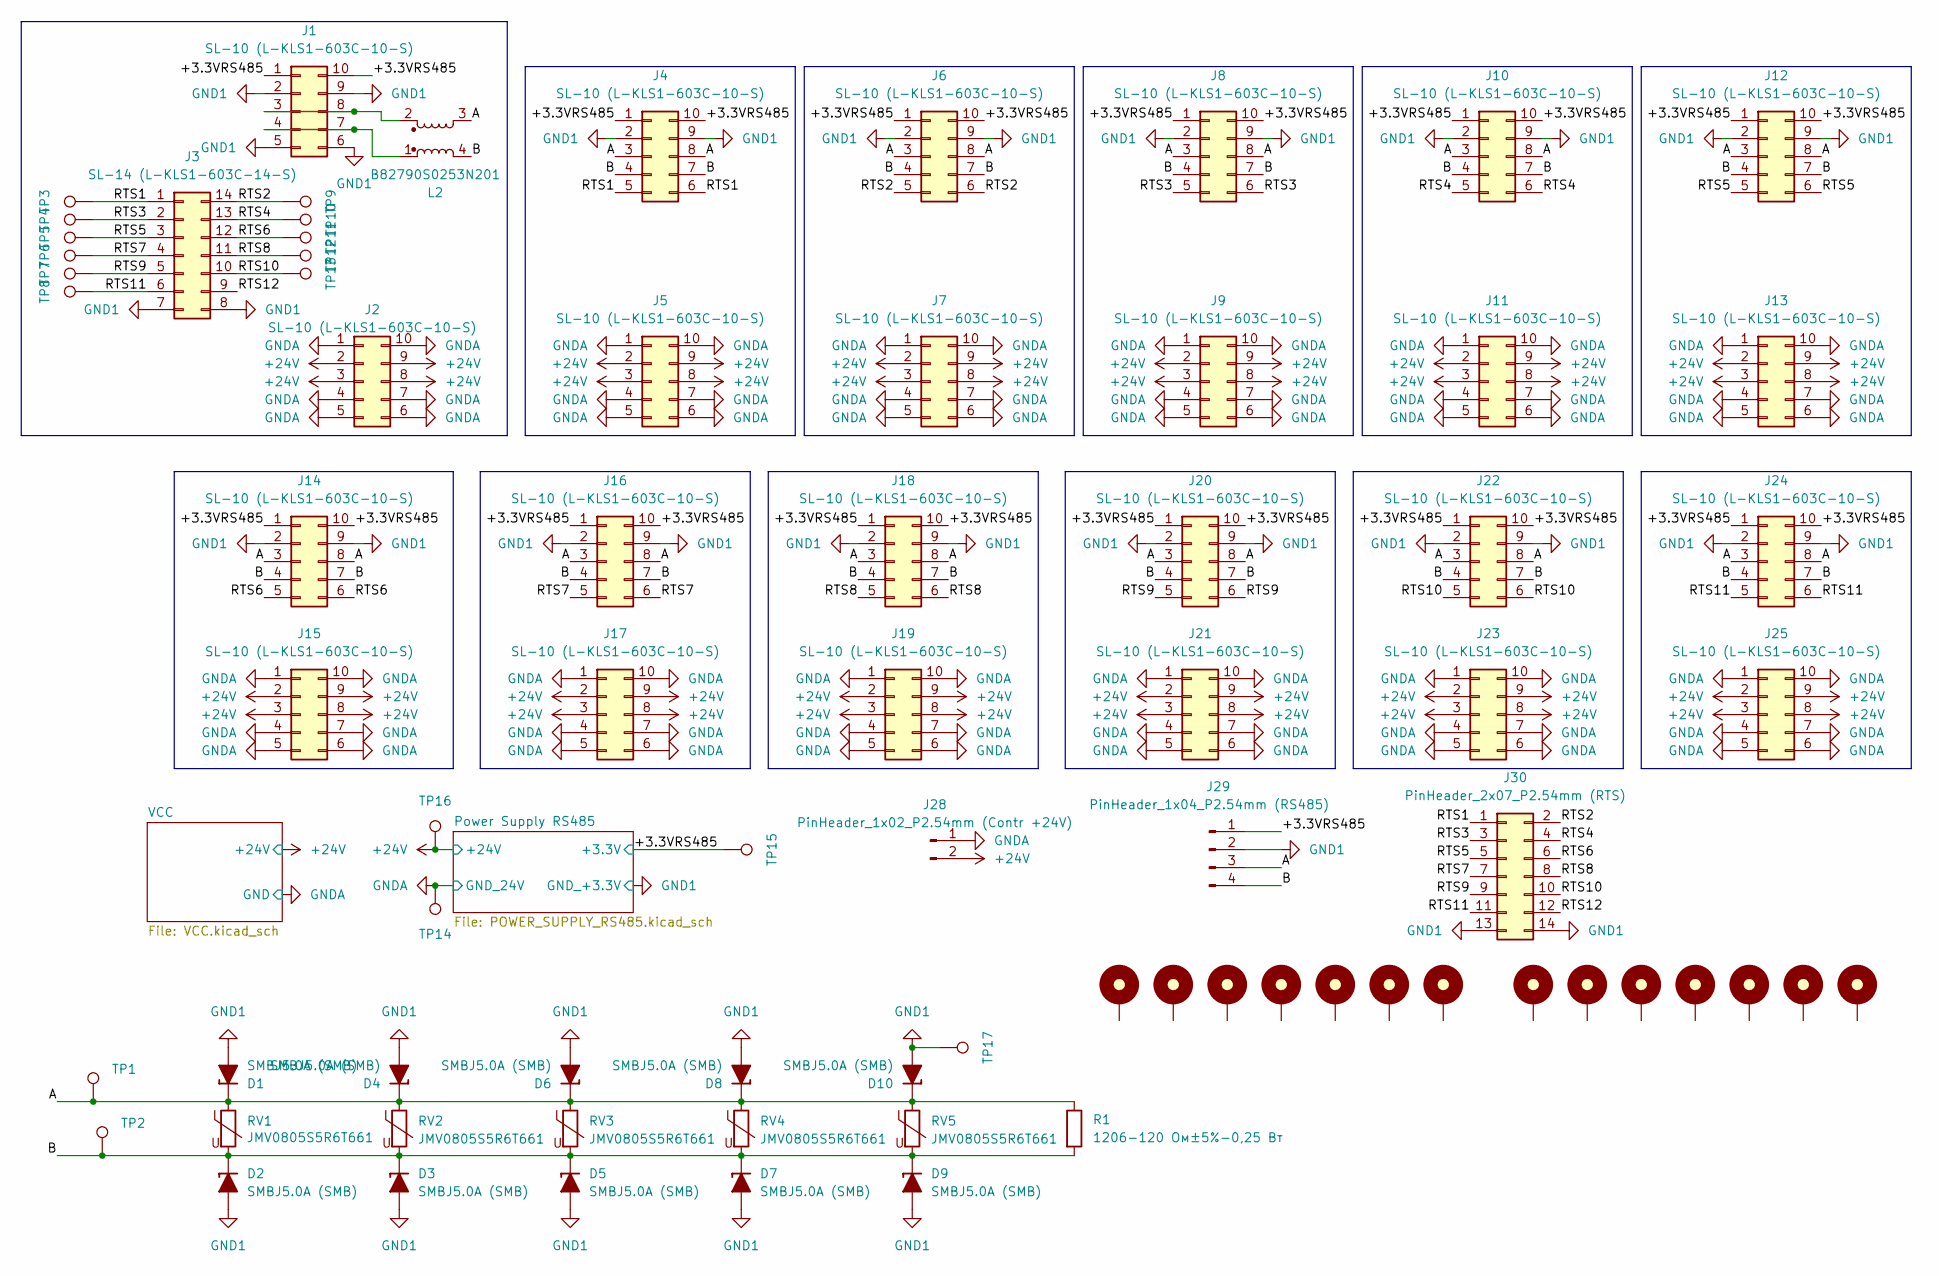
[picture p38: schematic motherboard.kicad_sch]

Parts:
D1, D2, D3, D4, D5, D6, D7, D8, D9, D10: SMBJ5.0A (SMB); D_SMB
H1, H2, H3, H4, H5, H6, H7, H8, H9, H10, H11, H12, H13, H14: MountingHole_M3_3.2mm_Pad; MountingHole_3.2mm_M3
J1, J2, J4, J5, J6, J7, J8, J9, J10, J11, J12, J13, J14, J15, J16, J17, J18, J19, J20, J21, J22, J23, J24, J25: SL-10 (L-KLS1-603C-10-S)
J3: SL-14 (L-KLS1-603C-14-S)
J28: PinHeader_1x02_P2.54mm (Contr +24V); PinHeader_1x02_P2.54mm_Vertical
J29: PinHeader_1x04_P2.54mm (RS485); PinHeader_1x04_P2.54mm_Vertical
J30: PinHeader_2x07_P2.54mm (RTS); PinHeader_2x07_P2.54mm_Vertical
L2: B82790S0253N201; L_CommonMode_Delevan_4222
R1: 1206-120 Ом±5%-0,25 Вт; R_1206_3216Metric
RV1, RV2, RV3, RV4, RV5: JMV0805S5R6T661; R_0805_2012Metric
TP1, TP2, TP3, TP17: TestPoint; TestPoint_Pad_D1.0mm
TP4, TP5, TP6, TP7, TP8, TP9, TP10, TP11, TP12, TP13, TP14, TP15, TP16: TestPoint; TestPoint_D1

Connections:
+24V: J2.2, J2.3, J2.8, J2.9, J5.2, J5.3, J5.8, J5.9, J7.2, J7.3, J7.8, J7.9, J9.2, J9.3, J9.8, J9.9, J11.2, J11.3, J11.8, J11.9, J13.2, J13.3, J13.8, J13.9, J15.2, J15.3, J15.8, J15.9, J17.2, J17.3, J17.8, J17.9, J19.2, J19.3, J19.8, J19.9, J21.2, J21.3, J21.8, J21.9, J23.2, J23.3, J23.8, J23.9, J25.2, J25.3, J25.8, J25.9, J28.2, TP16.1; also elsewhere on the board
/+3.3VRS485: J1.1, J1.10, J4.1, J4.10, J6.1, J6.10, J8.1, J8.10, J10.1, J10.10, J12.1, J12.10, J14.1, J14.10, J16.1, J16.10, J18.1, J18.10, J20.1, J20.10, J22.1, J22.10, J24.1, J24.10, J29.1, TP15.1; also elsewhere on the board
/A: D1.1 (K), D4.1 (K), D6.1 (K), D8.1 (K), D10.1 (K), J4.3, J4.8, J6.3, J6.8, J8.3, J8.8, J10.3, J10.8, J12.3, J12.8, J14.3, J14.8, J16.3, J16.8, J18.3, J18.8, J20.3, J20.8, J22.3, J22.8, J24.3, J24.8, J29.3, L2.3, R1.1, RV1.1, RV2.1, RV3.1, RV4.1, RV5.1, TP1.1
/B: D2.1 (K), D3.1 (K), D5.1 (K), D7.1 (K), D9.1 (K), J4.4, J4.7, J6.4, J6.7, J8.4, J8.7, J10.4, J10.7, J12.4, J12.7, J14.4, J14.7, J16.4, J16.7, J18.4, J18.7, J20.4, J20.7, J22.4, J22.7, J24.4, J24.7, J29.4, L2.4, R1.2, RV1.2, RV2.2, RV3.2, RV4.2, RV5.2, TP2.1
/RTS1: J3.1, J4.5, J4.6, J30.1, TP3.1
/RTS2: J3.14, J6.5, J6.6, J30.2, TP9.1
/RTS3: J3.2, J8.5, J8.6, J30.3, TP4.1
/RTS4: J3.13, J10.5, J10.6, J30.4, TP10.1
/RTS5: J3.3, J12.5, J12.6, J30.5, TP5.1
/RTS6: J3.12, J14.5, J14.6, J30.6, TP11.1
/RTS7: J3.4, J16.5, J16.6, J30.7, TP6.1
/RTS8: J3.11, J18.5, J18.6, J30.8, TP12.1
/RTS9: J3.5, J20.5, J20.6, J30.9, TP7.1
/RTS10: J3.10, J22.5, J22.6, J30.10, TP13.1
/RTS11: J3.6, J24.5, J24.6, J30.11, TP8.1
/RTS12: J3.9, J30.12
GND1: D1.2 (A), D2.2 (A), D3.2 (A), D4.2 (A), D5.2 (A), D6.2 (A), D7.2 (A), D8.2 (A), D9.2 (A), D10.2 (A), J1.2, J1.5, J1.6, J1.9, J3.7, J3.8, J4.2, J4.9, J6.2, J6.9, J8.2, J8.9, J10.2, J10.9, J12.2, J12.9, J14.2, J14.9, J16.2, J16.9, J18.2, J18.9, J20.2, J20.9, J22.2, J22.9, J24.2, J24.9, J29.2, J30.13, J30.14, TP17.1; also elsewhere on the board
GNDA: J2.1, J2.4, J2.5, J2.6, J2.7, J2.10, J5.1, J5.4, J5.5, J5.6, J5.7, J5.10, J7.1, J7.4, J7.5, J7.6, J7.7, J7.10, J9.1, J9.4, J9.5, J9.6, J9.7, J9.10, J11.1, J11.4, J11.5, J11.6, J11.7, J11.10, J13.1, J13.4, J13.5, J13.6, J13.7, J13.10, J15.1, J15.4, J15.5, J15.6, J15.7, J15.10, J17.1, J17.4, J17.5, J17.6, J17.7, J17.10, J19.1, J19.4, J19.5, J19.6, J19.7, J19.10, J21.1, J21.4, J21.5, J21.6, J21.7, J21.10, J23.1, J23.4, J23.5, J23.6, J23.7, J23.10, J25.1, J25.4, J25.5, J25.6, J25.7, J25.10, J28.1, TP14.1; also elsewhere on the board
unnamed: J1.3, J1.8, L2.2
unnamed: J1.4, J1.7, L2.1

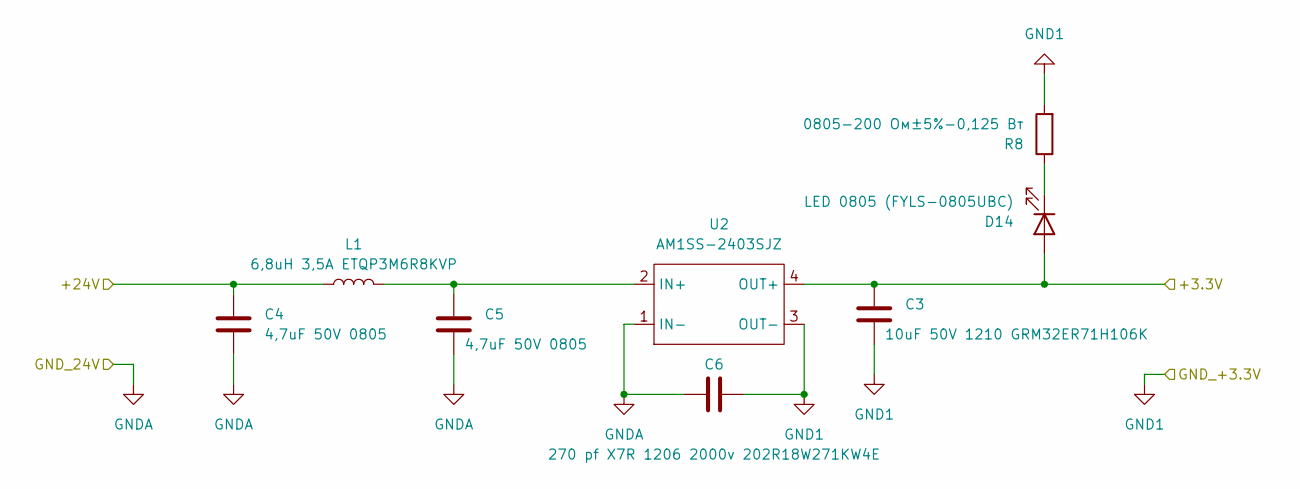
[picture p39: schematic POWER_SUPPLY_RS485.kicad_sch]

Parts:
C3: 10uF 50V 1210 GRM32ER71H106K; C_1210_3225Metric
C4, C5: 4,7uF 50V 0805; C_0805_2012Metric
C6: 270 pf X7R 1206 2000v 202R18W271KW4E; C_1210_3225Metric
D14: LED 0805 (FYLS-0805UBC); LED_0805_2012Metric_Pad1.15x1.40mm_HandSolder
L1: 6,8uH 3,5A ETQP3M6R8KVP; L_Bourns-SRN6028
R8: 0805-200 Ом±5%-0,125 Вт; R_0805_2012Metric
U2: AM1SS-2403SJZ; Converter_DCDC_Murata_CRE1xxxxxx3C_THT

Connections:
+24V: C4.1, L1.1; also elsewhere on the board
/+3.3VRS485: C3.1, D14.2 (A), U2.4 (OUT+); also elsewhere on the board
GND1: C3.2, C6.2, R8.2, U2.3 (OUT-); also elsewhere on the board
GNDA: C4.2, C5.2, C6.1, U2.1 (IN-); also elsewhere on the board
unnamed: D14.1 (K), R8.1
unnamed: C5.1, L1.2, U2.2 (IN+)

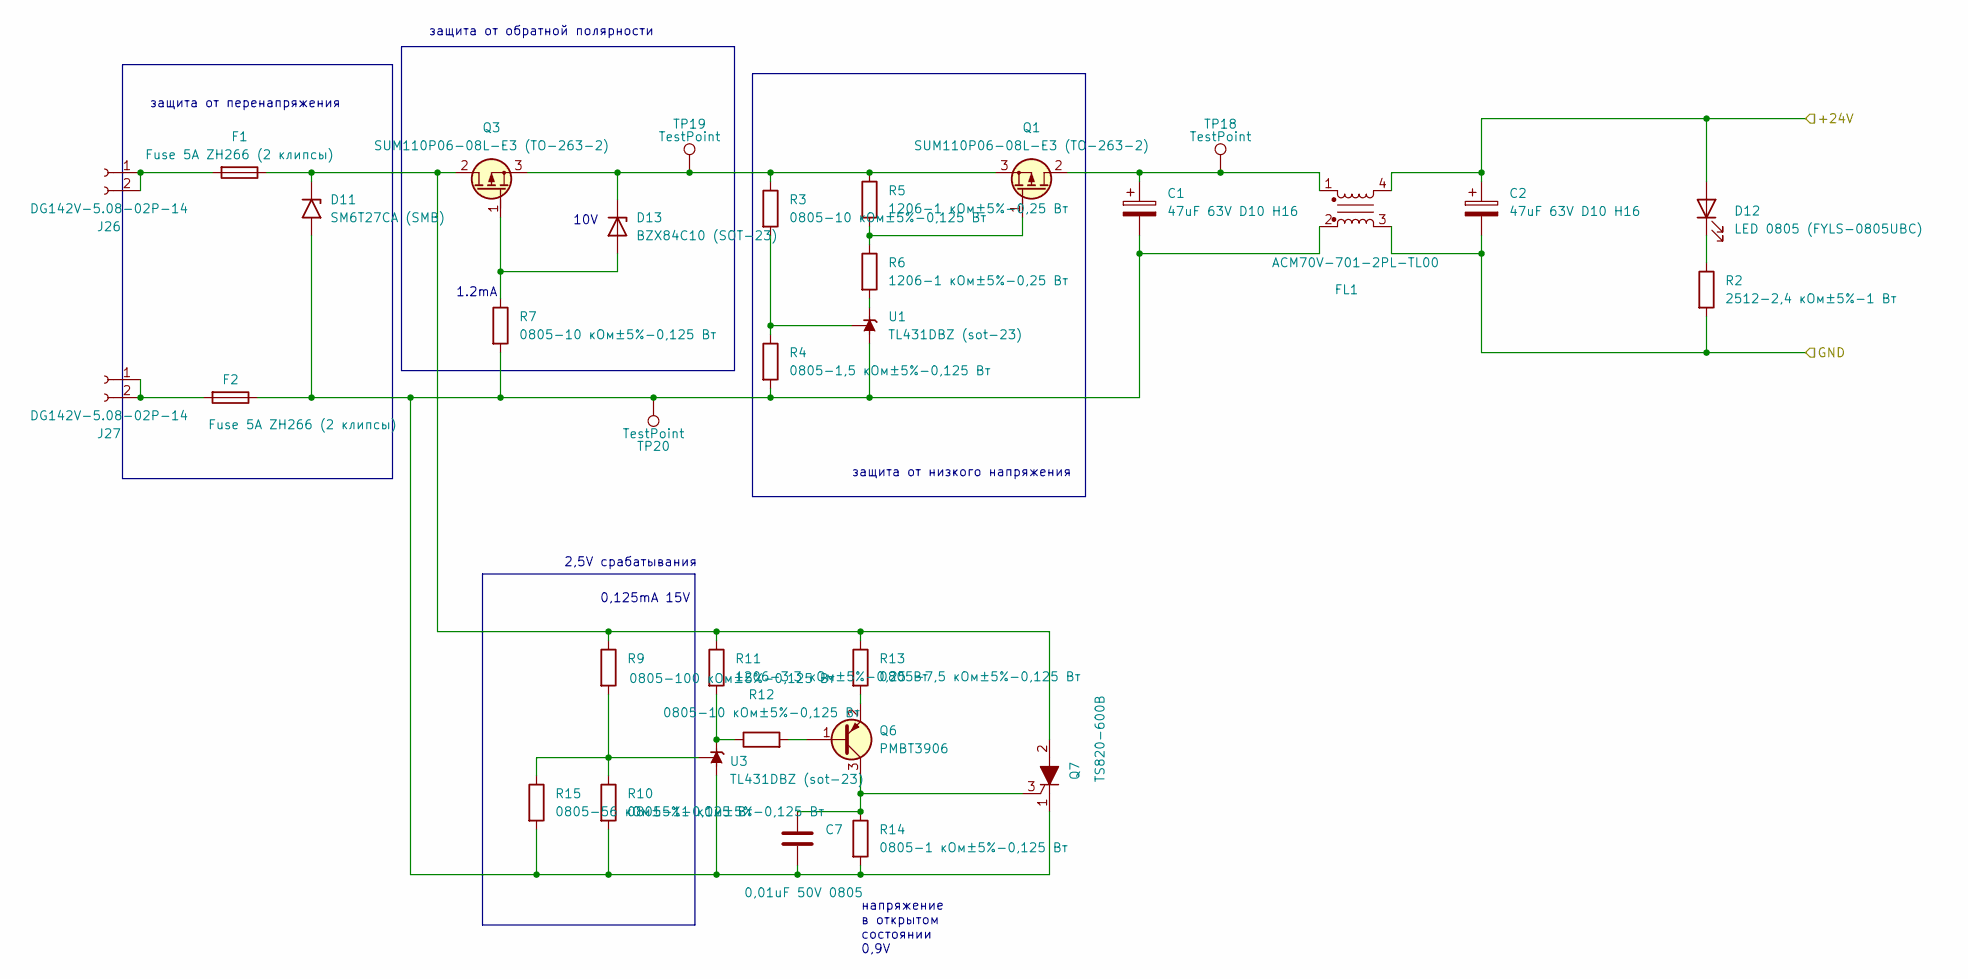
[picture p40: schematic VCC.kicad_sch]

Parts:
C1, C2: 47uF 63V D10 H16; CP_Radial_D10.0mm_P5.00mm
C7: 0,01uF 50V 0805; C_0805_2012Metric
D11: SM6T27CA (SMB); D_SMB
D12: LED 0805 (FYLS-0805UBC); LED_0805_2012Metric_Pad1.15x1.40mm_HandSolder
D13: BZX84C10 (SOT-23); SOT-23
F1, F2: Fuse 5A ZH266 (2 клипсы); Fuseholder_Littelfuse_100_series_5x20mm
FL1: ACM70V-701-2PL-TL00; ACM12V
J26, J27: DG142V-5.08-02P-14
Q1, Q3: SUM110P06-08L-E3 (TO-263-2); TO-263-2
Q6: PMBT3906; SOT-23-3
Q7: TS820-600B; TO-252-2
R2: 2512-2,4 кОм±5%-1 Вт; R_2512_6332Metric
R3, R7, R12: 0805-10 кОм±5%-0,125 Вт; R_0805_2012Metric
R4: 0805-1,5 кОм±5%-0,125 Вт; R_0805_2012Metric
R5, R6: 1206-1 кОм±5%-0,25 Вт; R_1206_3216Metric
R9: 0805-100 кОм±5%-0,125 Вт; R_0805_2012Metric
R10: 0805-11 кОм±5%-0,125 Вт; R_0805_2012Metric
R11: 1206-3,3 кОм±5%-0,25 Вт; R_1206_3216Metric
R13: 0805-7,5 кОм±5%-0,125 Вт; R_0805_2012Metric
R14: 0805-1 кОм±5%-0,125 Вт; R_0805_2012Metric
R15: 0805-56 кОм±5%-0,125 Вт; R_0805_2012Metric
TP18, TP19: TestPoint; TestPoint_Pad_D1.0mm
TP20: TestPoint; TestPoint_D1
U1, U3: TL431DBZ (sot-23); SOT-23

Connections:
+24V: C2.1, D12.2 (A), FL1.4; also elsewhere on the board
GNDA: C2.2, FL1.3, R2.2; also elsewhere on the board
unnamed: D11.1 (A1), F1.1, Q3.2 (D), Q7.2 (A), R9.1, R11.1, R13.1
unnamed: C1.2, C7.2, D11.2 (A2), F2.1, FL1.2, Q7.1 (K), R4.2, R7.2, R10.2, R14.2, R15.2, TP20.1, U1.3 (A), U3.3 (A)
unnamed: D12.1 (K), R2.1
unnamed: D13.1 (A), Q3.1 (G), R7.1
unnamed: D13.3 (K), Q1.3 (S), Q3.3 (S), R3.1, R5.1, TP19.1
unnamed: F1.2, J26.1, J26.2
unnamed: F2.2, J27.1, J27.2
unnamed: C1.1, FL1.1, Q1.2 (D), TP18.1
unnamed: Q1.1 (G), R5.2, R6.1
unnamed: Q6.1 (B), R12.2
unnamed: C7.1, Q6.3 (C), Q7.3 (G), R14.1
unnamed: Q6.2 (E), R13.2
unnamed: R6.2, U1.1 (K)
unnamed: R3.2, R4.1, U1.2 (REF)
unnamed: R11.2, R12.1, U3.1 (K)
unnamed: R9.2, R10.1, R15.1, U3.2 (REF)

Notes on the sheet:
защита от обратной полярности
10V
защита от низкого напряжения
напряжение в открытом состоянии 0,9V
защита от перенапряжения
2,5V срабатывания
1.2mA
0,125mA 15V

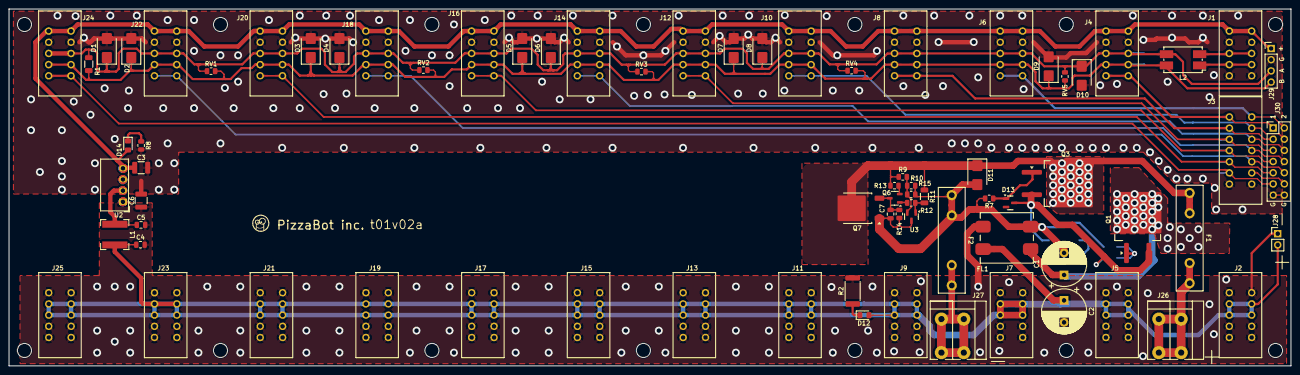
[picture p41: board motherboard.kicad_pcb from above]

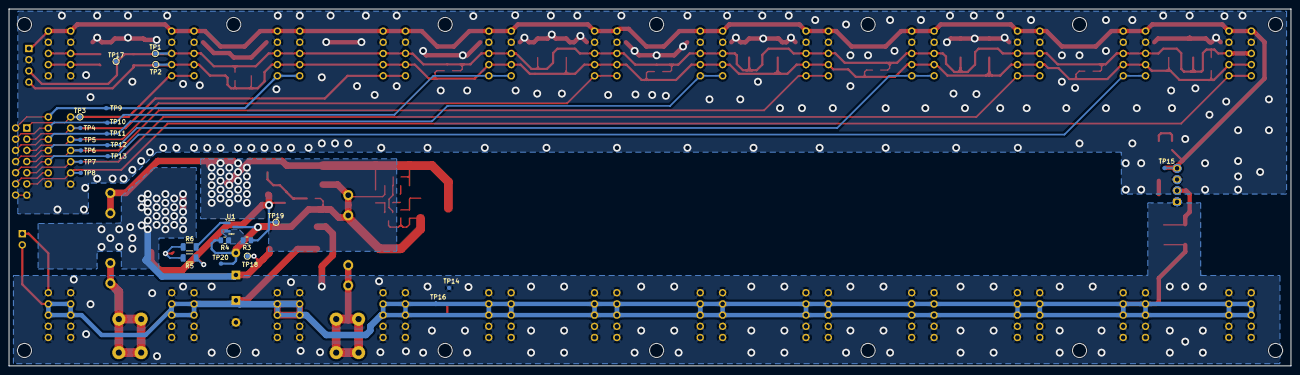
[picture p42: board motherboard.kicad_pcb from below]

Board: 2 copper layers, 291.0 x 81.0 mm, 117 parts (25 on the bottom side), 38 nets.
