borzeman/PzbElectronics/LED_give/Led_give.kicad_pcb

## KiCad design LED_give/Led_give.kicad_pcb (2025-04-09)

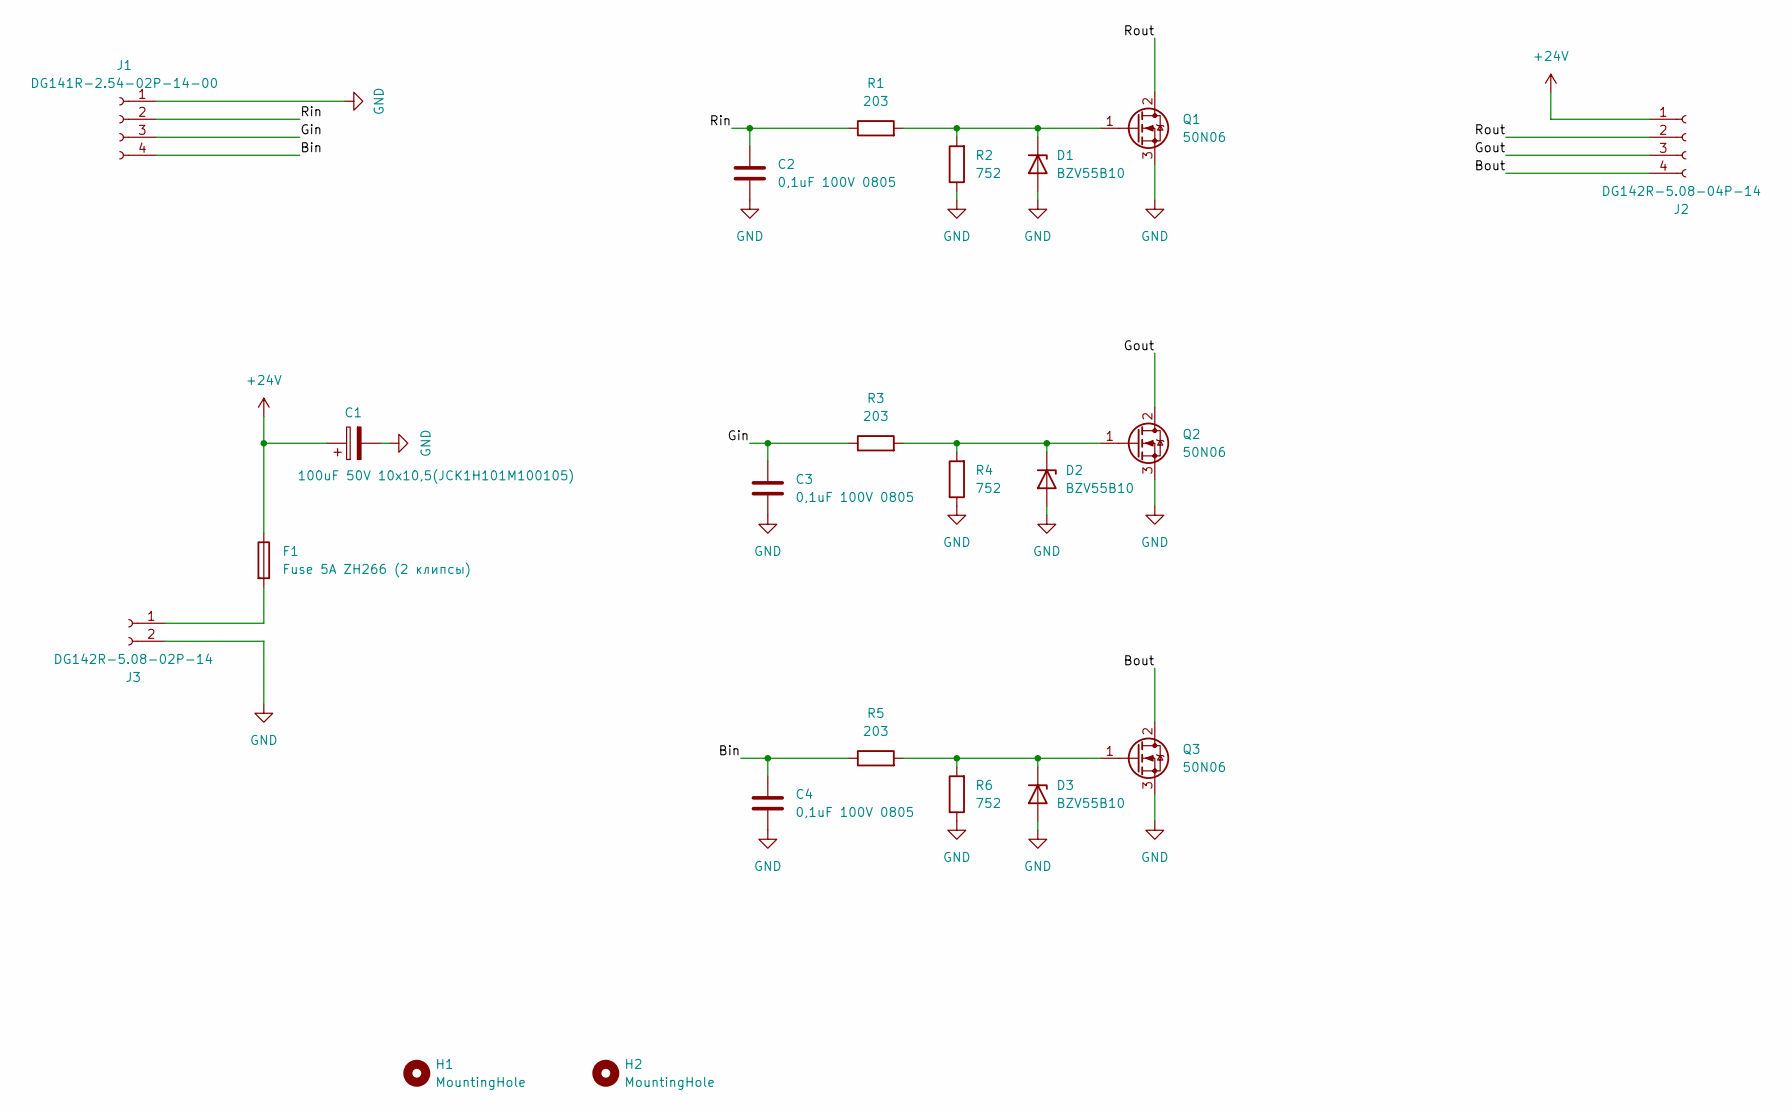
[picture p43: schematic Led_give.kicad_sch]

Parts:
C1: 100uF 50V 10x10,5(JCK1H101M100105); CP_Elec_10x10.5
C2, C3, C4: 0,1uF 100V 0805; C_0805_2012Metric
D1, D2, D3: BZV55B10; D_MiniMELF
F1: Fuse 5A ZH266 (2 клипсы); Fuseholder_100_series_5x20mm_D1,5
H1, H2: MountingHole; MountingHole_3.2mm_M3_Pad
J1: DG141R-2.54-02P-14-00; DG141R-04
J2: DG142R-5.08-04P-14
J3: DG142R-5.08-02P-14
Q1, Q2, Q3: 50N06; TO-252-2
R1, R3, R5: 203; R_0805_2012Metric
R2, R4, R6: 752; R_0805_2012Metric

Connections:
+24V: C1.1, F1.1, J2.1
/Bin: C4.1, J1.4, R5.1
/Bout: J2.4, Q3.2 (D)
/Gin: C3.1, J1.3, R3.1
/Gout: J2.3, Q2.2 (D)
/Rin: C2.1, J1.2, R1.1
/Rout: J2.2, Q1.2 (D)
GND: C1.2, C2.2, C3.2, C4.2, D1.2 (A), D2.2 (A), D3.2 (A), J1.1, J3.2, Q1.3 (S), Q2.3 (S), Q3.3 (S), R2.1, R4.1, R6.1
unnamed: D1.1 (K), Q1.1 (G), R1.2, R2.2
unnamed: D2.1 (K), Q2.1 (G), R3.2, R4.2
unnamed: D3.1 (K), Q3.1 (G), R5.2, R6.2
unnamed: F1.2, J3.1

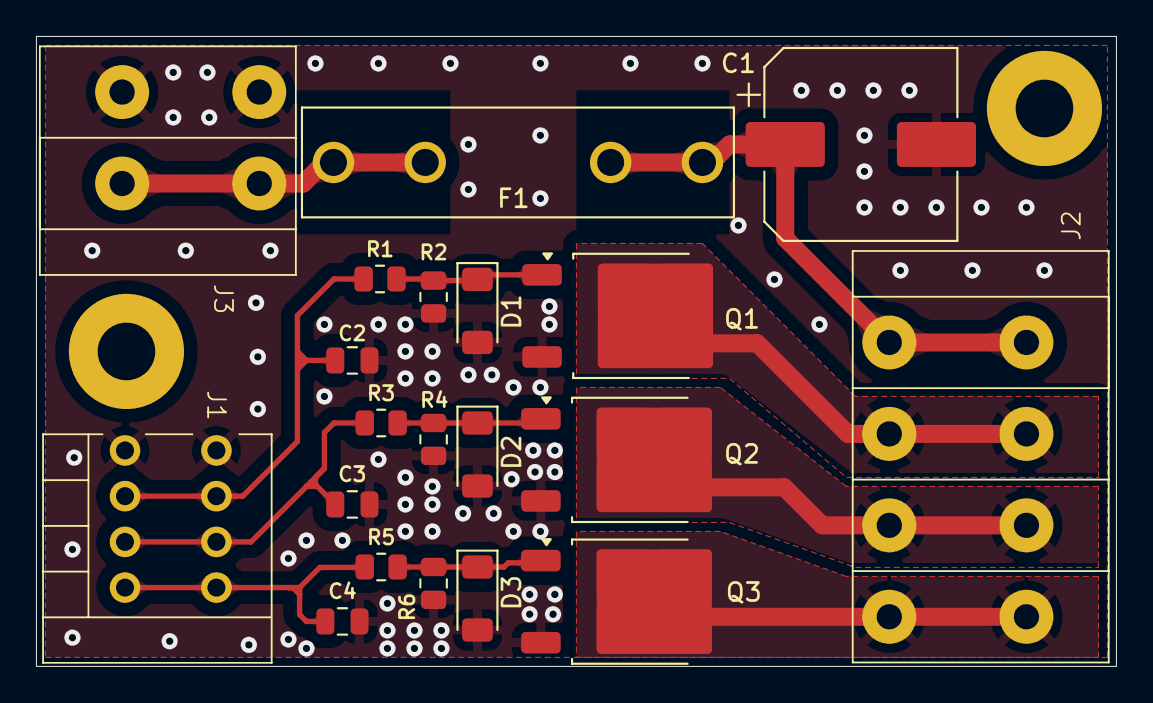
[picture p44: board Led_give.kicad_pcb from above]

Board: 2 copper layers, 60.0 x 35.0 mm, 22 parts (0 on the bottom side), 12 nets.
