borzeman/PzbElectronics/manipulator_attachment/manipulator_attachment.kicad_pcb

## KiCad design manipulator_attachment/manipulator_attachment.kicad_pcb (2024-12-30)

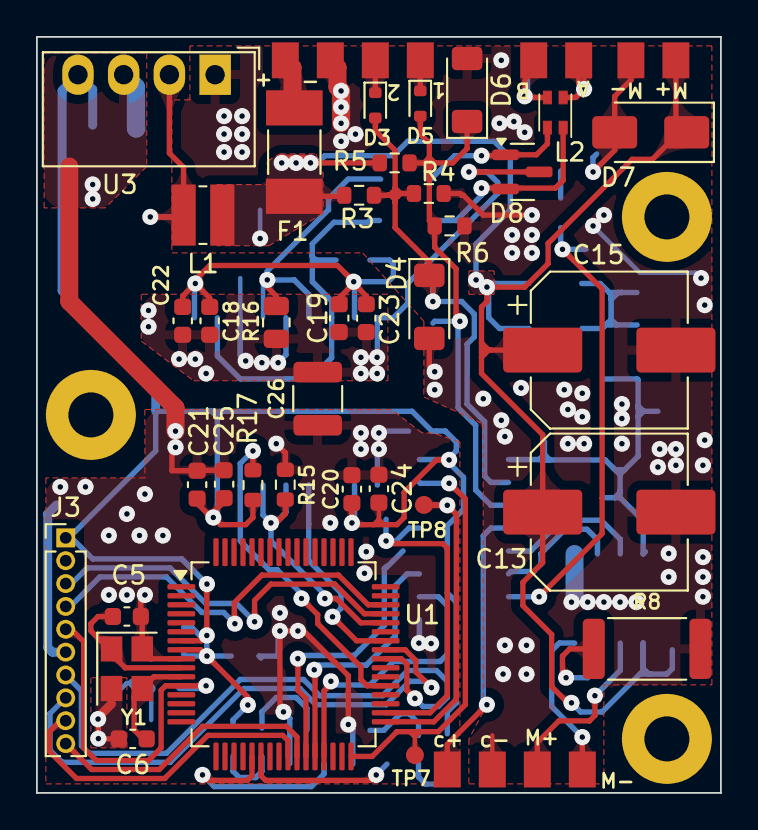
[picture p45: board manipulator_attachment.kicad_pcb from above]

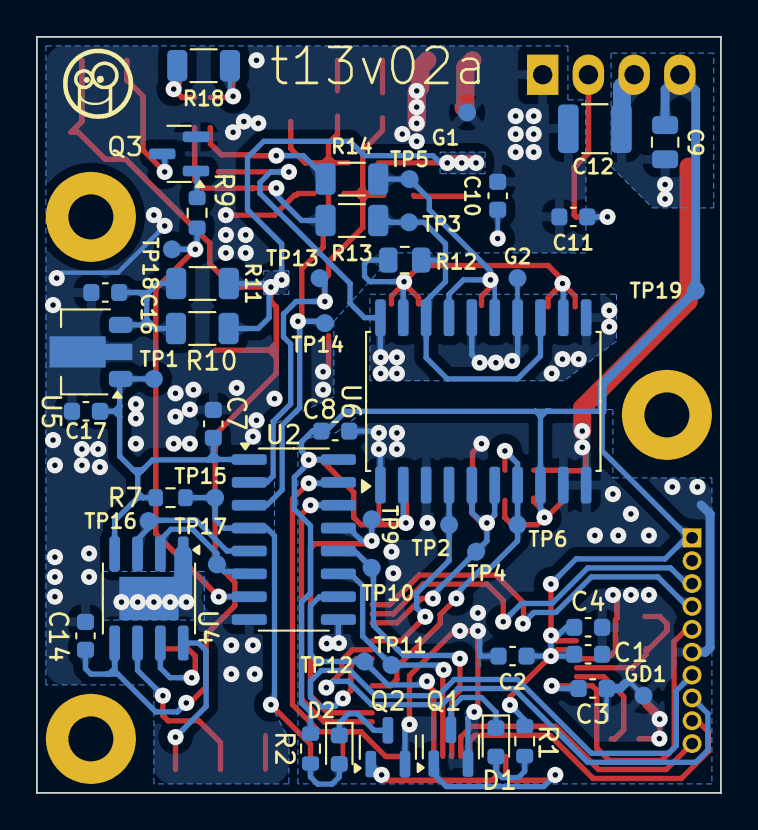
[picture p46: board manipulator_attachment.kicad_pcb from below]

Board: 2 copper layers, 38.0 x 42.0 mm, 95 parts (52 on the bottom side), 53 nets.

Parts:
C1, C3, C4, C7, C8, C17, C19, C20, C22, C25: 0,1uF 100V 0603; C_0603_1608Metric
C2, C10, C11: 4,7uF 50V 0603; C_0603_1608Metric
C5, C6: 20pF 50V 0603; C_0603_1608Metric
C9: 10uF 50V 0805; C_0805_2012Metric
C12, C26: 270 pf X7R 1206 2000v 202R18W271KW4E; C_1210_3225Metric
C13: 100uF 50V (SMD 8х10); CP_Elec_8x10.5
C14: 0.22uF 50V 0603; C_0603_1608Metric
C15: 47uF 63V SMD; CP_Elec_8x10.5
C16: 0,33uF 50V 0603; C_0603_1608Metric
C18, C21: 10uF 16V 0603; C_0603_1608Metric
C23, C24: 10nF 50V 0603; C_0603_1608Metric
D1, D2: TO-1608BC-BF; LED_0603_1608Metric
D3, D5: 1PS79SB30; D_SOD-523
D4, D6: BZV55B3V3; D_MiniMELF
D7: SS16; D_SMA
D8: PSM712; SOT-23
F1: 045201.5MRL; Fuse_Littelfuse-NANO2-451_453
G1, G2: TestPoint; TestPoint_Pad_D1.0mm
GD1: TestPoint; TestPoint_Pad_D1.0mm
H1, H2, H3: MountingHole; MountingHole_2.5mm_Pad
J1: RS485; PAD_1.5x2mm_2
J3: DS1031-01-1х10 (PLL - 1x10) (prog); PinHeader_1x10_P1.27mm_Vertical
J4: Magnit; PAD_1.5x2mm_2
J5: Control; PAD_1.5x2mm_4
J6: IN_VCC_DO; PAD_1.5x2mm_4
L1: 6,8uH 0,95A (SM3521-6R8MT); L_Wuerth_MAPI-3020
L2: DLW21SN900SQ2L; L_CommonModeChoke_Coilcraft_0805USB
Q1, Q2: DTC114ECA (SOT-23); SOT-23
Q3: FDN5630; SOT-23
R1, R2: 0603-150 Ом±5%-0,0625 Вт; R_0603_1608Metric
R3, R5: 24k 0603; R_0603_1608Metric
R4, R6: 3.6k 0603; R_0603_1608Metric
R7: 0603 10 кОм; R_0603_1608Metric
R8: 0R51 2512; R_2512_6332Metric
R9: 101 0603; R_0603_1608Metric
R10: 1206-620 Ом±5%-0,25 Вт; R_1206_3216Metric
R11: 1206 opt; R_1206_3216Metric
R12, R16: 0805-560 Ом±5%-0,125 Вт; R_0805_2012Metric
R13, R14: 1206-100 Ом±5%-0,25 Вт; R_1206_3216Metric
R15, R17: 0603-10 кОм±5%-0,0625 Вт; R_0603_1608Metric
R18: 1206-120 Ом±5%-0,25 Вт; R_1206_3216Metric
TP1, TP2, TP3, TP4, TP5, TP6, TP7, TP8, TP9, TP10, TP11, TP12, TP13, TP14, TP15, TP16, TP17, TP18, TP19: TestPoint; TestPoint_Pad_D1.0mm
U1: STM32G070RBTx (LQFP-64); LQFP-64_10x10mm_P0.5mm
U2: π163M3x; SOIC-16_3.9x9.9mm_P1.27mm
U3: AM1SS-2403SJZ; Converter_DCDC_Murata_MEE1SxxxxSC_THT
U4: A4950E; SOIC-8-1EP_3.9x4.9mm_P1.27mm_EP2.41x3.3mm
U5: L78L33_SOT89; SOT-89-3
U6: ADM2587E (SOIC-20); SOIC-20W_7.5x12.8mm_P1.27mm
Y1: Crystal_3225 8MHz; Crystal_SMD_3225-4Pin_3.2x2.5mm

Connections:
+3.3VA: C7.2, C17.1, R7.1, TP1.1, U2.1 (VDD1), U4.4 (VREF), U5.1 (OUT)
+3V3: C1.1, C2.1, C4.1, C8.2, C9.1, C20.1, C21.2, C24.1, C25.2, J3.1, R1.2, R2.2, R17.1, TP19.1, U1.7 (VREF+), U1.8 (VDD), U2.16 (VDD2), U3.4 (OUT+), U6.2 (VCC), U6.8 (VCC)
+24V: C10.1, C13.1, C14.2, C15.1, D7.1 (K), F1.1, J4.2, L1.1, R3.1, R5.2, R10.2, R11.2, U4.5 (VBB)
/A: J1.2, L2.2, R18.2
/B: J1.1, L2.3, R18.1
/Catch: TP16.1, U2.5 (VOD), U4.3 (IN1)
/Catch_contr: TP10.1, U1.27 (PB0), U2.12 (VID)
/Contact+: J5.1, R7.2, TP15.1, U2.4 (VIC)
/Contakt_signal_contr: TP9.1, U1.34 (PB14), U2.13 (VOC)
/DE_USART_1: R15.1, TP4.1, U1.44 (PA12/PA10), U6.5 (~RE), U6.6 (DE)
/GPIO1: J3.9, U1.25 (PC4)
/GPIO2: J3.10, U1.26 (PC5)
/Magnit-: D7.2 (A), J4.1, Q3.3 (D)
/Motor+: J5.3, U4.6 (OUT1)
/Motor-: J5.4, U4.8 (OUT2)
/NRST: C3.2, J3.5, U1.12 (NRST)
/ON/OFF magnet: R9.1, TP18.1, U2.7 (VOF)
/ON/OFF magnet_contr: TP12.1, U1.29 (PB2), U2.10 (VIF)
/OSC_IN: C5.1, U1.10 (PF0), Y1.1
/OSC_OUT: C6.1, U1.11 (PF1), Y1.3
/RX_USART_1: TP2.1, U1.42 (PA10/NC), U6.4 (RxD)
/SWCLK: J3.4, U1.46 (PA14)
/SWDIO: J3.3, U1.45 (PA13)
/TX_USART_1: R17.2, TP6.1, U1.37 (PA9/NC), U6.7 (TxD)
/UART_RX: J3.8, U1.41 (PD9)
/UART_TX: J3.7, U1.40 (PD8)
/Uncatch: TP17.1, U2.6 (VOE), U4.2 (IN2)
/Uncatch_contr: TP11.1, U1.28 (PB1), U2.11 (VIE)
/gripper_signal: D5.2 (A), D6.1 (K), R5.1, R6.1, TP14.1, U2.3 (VIB)
/gripper_signal_contr: TP8.1, U1.33 (PB13), U2.14 (VOB)
/magnit_signal: D3.2 (A), D4.1 (K), R3.2, R4.1, TP13.1, U2.2 (VIA)
/magnit_signal_contr: TP7.1, U1.32 (PB12), U2.15 (VOA)
GND: C7.1, C10.2, C11.2, C12.1, C13.2, C14.1, C15.2, C16.2, C17.2, D4.2 (A), D6.2 (A), G1.1, J5.2, J6.2, Q3.2 (S), R4.2, R6.2, R8.2, U2.8 (GND1), U3.1 (IN-), U4.1 (GND), U4.9 (PAD), U5.2 (GND)
GND2: C18.2, C19.1, C22.2, C23.1, C26.2, D8.3 (Com), G2.1, R16.1, U6.11 (GND2), U6.14 (GND2), U6.16 (GND2), U6.20 (GND2)
GNDD: C1.2, C2.2, C3.1, C4.2, C5.2, C6.2, C8.1, C9.2, C12.2, C20.2, C21.1, C24.2, C25.1, C26.1, GD1.1, J3.6, Q1.2 (E), Q2.2 (E), R15.2, U1.9 (VSS), U2.9 (GND2), U3.3 (OUT-), U6.1 (GND1), U6.3 (GND1), U6.9 (GND1), U6.10 (GND1), Y1.2, Y1.4
unnamed: D1.2 (A), R1.1
unnamed: D1.1 (K), Q1.3 (C)
unnamed: D2.2 (A), R2.1
unnamed: D2.1 (K), Q2.3 (C)
unnamed: D3.1 (K), J6.3
unnamed: D5.1 (K), J6.4
unnamed: D8.1 (A1), L2.4, R14.1
unnamed: D8.2 (A2), L2.1, R13.2
unnamed: F1.2, J6.1
unnamed: Q1.1 (B), U1.21 (PA4)
unnamed: Q2.1 (B), U1.22 (PA5)
unnamed: Q3.1 (G), R9.2
unnamed: C11.1, L1.2, U3.2 (IN+)
unnamed: R8.1, U4.7 (LSS)
unnamed: C16.1, R10.1, R11.1, U5.3 (IN)
unnamed: R12.2, R13.1, TP3.1, U6.13 (Y), U6.18 (A)
unnamed: R14.2, R16.2, TP5.1, U6.15 (Z), U6.17 (B)
unnamed: C18.1, C19.2, C22.1, C23.2, R12.1, U6.12 (Visoout), U6.19 (Visoin)
