borzeman/PzbElectronics/controller_board/controller_board.kicad_pcb

## KiCad design controller_board/controller_board.kicad_pcb (2024-12-24)

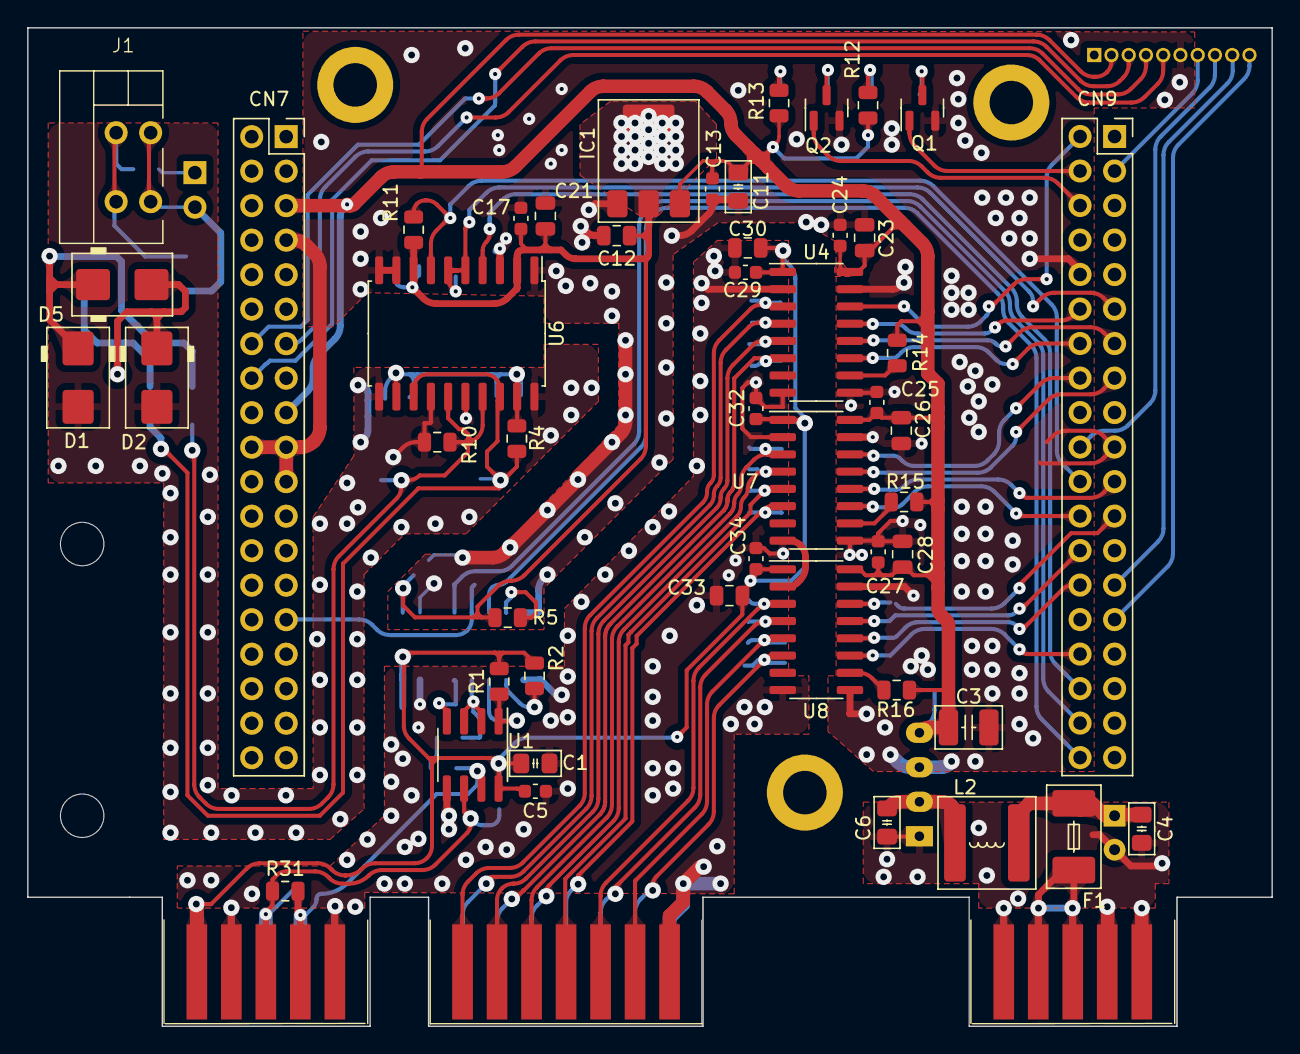
[picture p47: board controller_board.kicad_pcb from above]

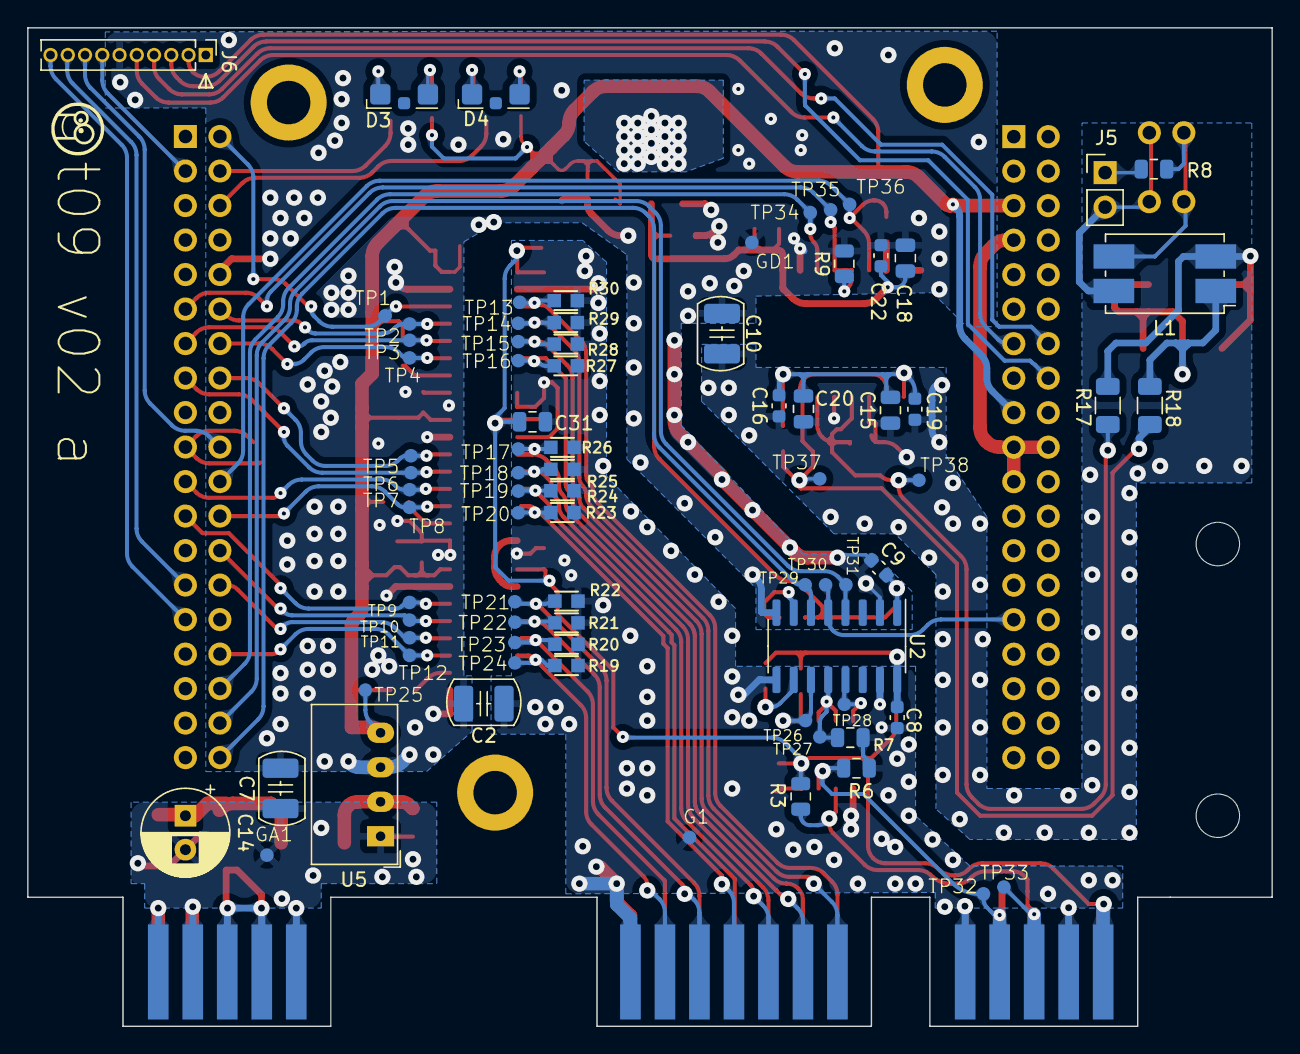
[picture p48: board controller_board.kicad_pcb from below]

Board: 2 copper layers, 91.6 x 73.5 mm, 137 parts (80 on the bottom side), 71 nets.

Parts:
C1, C11: 1uF 50V 0805; C_0805_2012Metric_Pad1.18x1.45mm_HandSolder
C2, C7, C10: 270 pf X7R 1206 2000v 202R18W271KW4E; C_1210_3225Metric_Pad1.42x2.65mm
C3: 10uF 50V 1210 GRM32ER71H106K; C_1210_3225Metric_Pad1.42x2.65mm_HandSolder
C4, C6: 4,7uF 50V 0805; C_0805_2012Metric_Pad1.18x1.45mm_HandSolder
C5, C8, C9, C13, C16, C17, C19, C22, C24, C25, C27, C29, C32, C34: 0,1uF 100V 0603; C_0603_1608Metric
C12, C15, C18, C23, C26, C28, C30, C31, C33: 10uF 16V 0805; C_0805_2012Metric
C14: 47uF 63V D6,3 H11; CP_Radial_D6.3mm_P2.50mm
C20, C21: 10nF 50V 0805; C_0805_2012Metric
CN7, CN9: DS1023-2x19S21; PinSocket_2x19_P2.54mm_Vertical
D1, D2: SMBJ5.0A; D_SMB
D3, D4: KPA-3010CGCK; LED_Kingbright_KPA-3010_3x2x1mm
D5: SMBJ10CA; D_SMB
F1: 0452.500MRL; Fuse_Littelfuse-NANO2-451_453
G1: TestPoint; TestPoint_D1
GA1: TestPoint; TestPoint_D1
GD1: TestPoint; TestPoint_D1
H1, H2: MountingHole; MountingHole_3.2mm_M3
H3, H4, H5: MountingHole; MountingHole_3.2mm_M3_DIN965_Pad
IC1: LD1117-3.3V-SOT223; SOT-223-3_TabPin2
J1: DG141R-02 (RS485); DG141R-02
J5: DS1027-2B и PinHeader_2x01_P2.54mm; PinHeader_1x02_P2.54mm_Vertical
J6: PLL-10 (Prog); PinHeader_1x10_P1.27mm_Vertical
L1: B82790S0253N201; L_CommonMode_Delevan_4222
L2: 6,8uH 3,5A (ETQP3M6R8KVP); L_Bourns-SRN6028
Q1, Q2: DTC114ECA (SOT-23); SOT-23
R1, R7, R9, R11: 0805-10 кОм±5%-0,125 Вт; R_0805_2012Metric
R2, R5: 0805-4,7 кОм±5%-0,125 Вт; R_0805_2012Metric
R3, R6: 0805-430 Ом±5%-0,125 Вт; R_0805_2012Metric
R4, R10: 0805-560 Ом±5%-0,125 Вт; R_0805_2012Metric
R8, R31: 0805 -120 Ом±5%-0,125 Вт; R_0805_2012Metric
R12, R13: 0805-300 Ом±5%-0,125 Вт; R_0805_2012Metric
R14, R15, R16: 0805-100 Ом±5%-0,125 Вт; R_0805_2012Metric
R17, R18: 1206-100 Ом±5%-0,25 Вт; R_1206_3216Metric
R19, R20, R21, R22, R23, R24, R25, R26, R27, R28, R29, R30: 0603-10 кОм±5%-0,062 Вт; R_0603
RS1, RS2: SL-10 (L-KLS1-603C-10-S); Edge_Conn_KLS1-603-10
RS3: SL-14 (L-KLS1-603C-14-S) RTS; Edge_Conn_KLS1-603-14
TP1, TP2, TP3, TP4, TP5, TP6, TP7, TP8, TP9, TP10, TP11, TP12, TP13, TP14, TP15, TP16, TP17, TP18, TP19, TP20, TP21, TP22, TP23, TP24, TP25, TP26, TP27, TP28, TP29, TP30, TP31, TP32, TP33, TP34, TP35, TP36, TP37, TP38: TestPoint; TestPoint_D1
U1: ADM3485EARZ-REEL (SOIC-8); SOIC-8_3.9x4.9mm_P1.27mm
U2: pia141M30 (SOIC-16); SOIC-16_3.9x9.9mm_P1.27mm
U4, U7, U8: pia140M30 (SOIC-16); SOIC-16_3.9x9.9mm_P1.27mm
U5: SMU02N-05; Converter_DCDC_Murata_CRE1xxxxxxSC_THT
U6: ADM2587E (SOIC-20); SOIC-20W_7.5x12.8mm_P1.27mm

Connections:
+3V3: C9.2, C12.1, C17.2, C18.2, C21.2, C22.1, IC1.2 (OUT), R5.1, R11.1, U2.1 (VDD1), U6.2 (VCC), U6.8 (VCC)
+5V: C3.1, C11.1, C13.1, C23.2, C24.1, C25.1, C26.2, C27.1, C28.2, CN7.5, CN7.17, IC1.3 (IN), J6.2, R12.2, R13.1, R14.1, R15.1, R16.1, TP25.1, U4.16 (VDD2), U5.4 (OUT+), U7.16 (VDD2), U8.16 (VDD2)
+24V: C4.1, C14.1, F1.2, L2.1
/+3.3VRS485: C1.2, C5.2, C8.2, C29.1, C30.2, C31.2, C32.1, C33.2, C34.1, R1.2, R2.2, R3.2, RS1.1, RS1.10, U1.8 (VCC), U2.16 (VDD2), U4.1 (VDD1), U7.1 (VDD1), U8.1 (VDD1)
/LED1: CN9.4, Q1.1 (B)
/LED2: CN9.6, Q2.1 (B)
/NUCLEO-64F411/GPIO1: CN9.27, J6.9
/NUCLEO-64F411/GPIO2: CN9.29, J6.10
/NUCLEO-64F411/RESET: CN7.13, J6.5
/NUCLEO-64F411/SWCLK: CN7.16, J6.3
/NUCLEO-64F411/SWDIO: CN7.14, J6.4
/NUCLEO-64F411/USART6_RX: CN9.20, J6.8
/NUCLEO-64F411/USART6_TX: CN9.3, J6.7
/RTS1: R30.1, RS3.1, TP13.1, U4.3 (VIA)
/RTS1_cont: CN9.2, TP1.1, U4.14 (VOA)
/RTS2: R29.1, RS3.14, TP14.1, U4.4 (VIB)
/RTS2_cont: CN9.12, TP2.1, U4.13 (VOB)
/RTS3: R28.1, RS3.2, TP15.1, U4.5 (VIC)
/RTS3_cont: CN9.13, TP3.1, U4.12 (VOC)
/RTS4: R27.1, RS3.13, TP16.1, U4.6 (VID)
/RTS4_cont: CN9.14, TP4.1, U4.11 (VOD)
/RTS5: R26.1, RS3.3, TP17.1, U7.3 (VIA)
/RTS5_cont: CN9.16, TP5.1, U7.14 (VOA)
/RTS6: R25.1, RS3.12, TP18.1, U7.4 (VIB)
/RTS6_cont: CN9.15, TP6.1, U7.13 (VOB)
/RTS7: R24.1, RS3.4, TP19.1, U7.5 (VIC)
/RTS7_cont: CN9.21, TP7.1, U7.12 (VOC)
/RTS8: R23.1, RS3.11, TP20.1, U7.6 (VID)
/RTS8_cont: CN9.24, TP8.1, U7.11 (VOD)
/RTS9: R22.1, RS3.5, TP21.1, U8.3 (VIA)
/RTS9_cont: CN9.23, TP9.1, U8.14 (VOA)
/RTS10: R21.1, RS3.10, TP22.1, U8.4 (VIB)
/RTS10_cont: CN9.26, TP10.1, U8.13 (VOB)
/RTS11: R20.1, RS3.6, TP23.1, U8.5 (VIC)
/RTS11_cont: CN9.28, TP11.1, U8.12 (VOC)
/RTS12: R19.1, RS3.9, TP24.1, U8.6 (VID)
/RTS12_cont: CN9.32, TP12.1, U8.11 (VOD)
/USART1_RTS: CN9.11, R9.1, TP35.1, U6.5 (~RE), U6.6 (DE)
/USART1_RX: CN9.34, TP34.1, U6.4 (RxD)
/USART1_TX: CN9.22, R11.2, TP36.1, U6.7 (TxD)
/USART2_RTS: CN7.29, TP30.1, U2.5 (VIC)
/USART2_RX: CN9.38, TP29.1, U2.6 (VOD)
/USART2_TX: CN9.36, TP31.1, U2.4 (VIB)
GND1: C1.1, C2.1, C5.1, C8.1, C29.2, C30.1, C31.1, C32.2, C33.1, C34.2, G1.1, R6.1, R7.1, R19.2, R20.2, R21.2, R22.2, R23.2, R24.2, R25.2, R26.2, R27.2, R28.2, R29.2, R30.2, RS1.2, RS1.5, RS1.6, RS1.9, RS3.7, RS3.8, U1.5 (GND), U2.9 (GND2), U2.15 (GND2), U4.2 (GND1), U4.8 (GND1), U7.2 (GND1), U7.8 (GND1), U8.2 (GND1), U8.8 (GND1)
GND2: C10.2, C15.1, C16.1, C19.1, C20.1, D1.2 (A), D2.2 (A), R10.1, U6.11 (GND2), U6.14 (GND2), U6.16 (GND2), U6.20 (GND2)
GNDA: C4.2, C6.2, C7.1, C14.2, GA1.1, RS2.1, RS2.4, RS2.5, RS2.6, RS2.7, RS2.10, U5.1 (IN-)
GNDD: C2.2, C3.2, C7.2, C9.1, C10.1, C11.2, C12.2, C13.2, C17.1, C18.1, C21.1, C22.2, C23.1, C24.2, C25.2, C26.1, C27.2, C28.1, CN7.7, CN7.19, CN7.20, CN7.21, CN9.10, CN9.19, GD1.1, IC1.1 (ADJ), J6.6, Q1.2 (E), Q2.2 (E), R9.2, U2.2 (GND1), U2.8 (GND1), U4.9 (GND2), U4.15 (GND2), U5.3 (OUT-), U6.1 (GND1), U6.3 (GND1), U6.9 (GND1), U6.10 (GND1), U7.9 (GND2), U7.15 (GND2), U8.9 (GND2), U8.15 (GND2)
unnamed: D1.1 (K), D5.1 (K), L1.2, R18.1
unnamed: D2.1 (K), D5.2 (A), L1.1, R17.2
unnamed: D3.2 (A), R12.1
unnamed: D3.1 (K), Q1.3 (C)
unnamed: D4.2 (A), R13.2
unnamed: D4.1 (K), Q2.3 (C)
unnamed: J1.1, J5.2, L1.4
unnamed: J1.2, L1.3, R8.1
unnamed: J5.1, R8.2
unnamed: R3.1, R31.2, RS1.3, RS1.8, TP33.1, U1.6 (A)
unnamed: R6.2, R31.1, RS1.4, RS1.7, TP32.1, U1.7 (B)
unnamed: F1.1, RS2.2, RS2.3, RS2.8, RS2.9
unnamed: R7.2, TP27.1, U1.2 (~RE), U1.3 (DE), U2.12 (VOC)
unnamed: TP28.1, U1.4 (DI), U2.13 (VOB)
unnamed: R1.1, TP26.1, U1.1 (RO), U2.11 (VID)
unnamed: R5.2, U2.7 (VE1)
unnamed: R2.1, U2.10 (VE2)
unnamed: R14.2, U4.10 (VE2)
unnamed: C6.1, L2.2, U5.2 (IN+)
unnamed: R4.2, R17.1, TP37.1, U6.13 (Y), U6.18 (A)
unnamed: R10.2, R18.2, TP38.1, U6.15 (Z), U6.17 (B)
unnamed: C15.2, C16.2, C19.2, C20.2, R4.1, U6.12 (Visoout), U6.19 (Visoin)
unnamed: R15.2, U7.10 (VE2)
unnamed: R16.2, U8.10 (VE2)
