borzeman/PzbElectronics/(commit log)

2024-04-30 Загрузка файлов первоначальная
    [Stepper_Motor_Control.kicad_sch, Плата внешних шаговых двигателей.kicad_pcb, Плата внешних шаговых двигателей.kicad_sch]
2024-04-30 add first file
    [Darlington.kicad_sch, IN_OUT_Detector.kicad_sch, NUCLEO-64F411.kicad_sch, Optopair.kicad_sch, PS5V.kicad_sch, PhotoTransistor.kicad_sch, Pump.kicad_sch, Pump_Control.kicad_sch]
2024-05-01 MB added protect,LED
    [VCC.kicad_sch, Материнская плата.kicad_pcb]
2024-05-04 Modify Digit_IN, Motherbord, Step motors
    [IN_OUT_Detector.kicad_sch, Optopair.kicad_sch, Stepper_Motor_Control.kicad_sch, TriggerSchmitta.kicad_sch, VCC.kicad_sch, Vcc_control.kicad_sch, Плата внешних шаговых двигателей.kicad_pcb, Плата внешних шаговых двигателей.kicad_sch]
2024-05-07 Modify Digit_IN, Motherbord, Step motors, photo
    [NUCLEO-64F411.kicad_sch, RS485_out.kicad_sch, RTS_ISO.kicad_sch, VCC.kicad_sch, Плата внешних шаговых двигателей.kicad_sch, Плата дискретных входов.kicad_sch, Плата основного контроллера.kicad_sch, Плата фото светодиоды.kicad_sch]
2024-05-20 Modify Motherbord Schems and PCB
    [POWER_SUPPLY_RS485.kicad_sch, VCC.kicad_sch, Материнская плата.kicad_pcb, Материнская плата.kicad_sch]
2024-05-20 Modify Motherbord Schems and PCB1
2024-05-22 Modify MainController Schems and PCB1
    [NUCLEO-64F411.kicad_sch, RS485_out.kicad_sch, RTS_ISO.kicad_sch, Плата основного контроллера.kicad_pcb, Плата основного контроллера.kicad_sch]
2024-05-22 Modify Pump Schems and PCB1
    [PS5V.kicad_sch, Pump.kicad_sch, Pump_Control.kicad_sch, Плата насосов.kicad_sch]
2024-05-22 Modify Triac Schems and PCB1
    [Simister.kicad_sch, Simisters.kicad_sch, Плата симистров.kicad_pcb, Плата симистров.kicad_sch]
2024-05-22 Modify StepMotor Schems and PCB1
    [Detectors.kicad_sch, Stepper_Motor_Control.kicad_sch, Плата внешних шаговых двигателей.kicad_pcb, Плата внешних шаговых двигателей.kicad_sch]
2024-05-22 Modify DiscretIN Schems and PCB1
    [DescretInput.kicad_sch, DiscretOut.kicad_sch, Optopair.kicad_sch, Плата дискретных входов.kicad_pcb, Плата дискретных входов.kicad_sch]
2024-05-27 Modify Mian controller, stepmotor, motor 25.05.24
    [Detectors.kicad_sch, NUCLEO-64F411.kicad_sch, Pump_Control.kicad_sch, RS485_out.kicad_sch, Stepper_Motor_Control.kicad_sch, Плата внешних шаговых двигателей.kicad_sch, Плата насосов.kicad_sch, Плата основного контроллера.kicad_pcb]
2024-06-03 Add DE USART 03.06.24
    [DescretInput.kicad_sch, NUCLEO-64F411.kicad_sch, Плата внешних шаговых двигателей.kicad_sch, Плата дискретных входов.kicad_sch, Плата насосов.kicad_sch, Плата основного контроллера.kicad_sch, Плата симистров.kicad_sch]
2024-06-03 Change ISOLATOR 03.06.24
    [RTS_ISO.kicad_sch, Stepper_Motor_Control.kicad_sch, Плата внешних шаговых двигателей.kicad_sch, Плата основного контроллера.kicad_sch]
2024-06-05 pcb and schems step 05.06.24
    [Stepper_Motor_Control.kicad_sch, Плата внешних шаговых двигателей.kicad_pcb, Плата внешних шаговых двигателей.kicad_sch]
2024-06-07 pcb and schems main controller 07.06.24
    [NUCLEO-64F411.kicad_sch, RS485_out.kicad_sch, RTS_ISO.kicad_sch, Плата основного контроллера.kicad_pcb, Плата основного контроллера.kicad_sch]
2024-06-10 renew motherbord (tvs) and new dc_motors 10.06.24
    [PS5V.kicad_sch, PumpV2.kicad_sch, VCC.kicad_sch, Материнская плата.kicad_pcb, Материнская плата.kicad_sch, Плата внешних шаговых двигателей.kicad_pcb, Плата насосов.kicad_sch]
2024-06-10 stepmotor add r41 10.06.24
    [Stepper_Motor_Control.kicad_sch, Плата внешних шаговых двигателей.kicad_pcb, Плата внешних шаговых двигателей.kicad_sch]
2024-06-11 Discret IN OUT schems
    [DescretInput.kicad_sch, DiscretOut.kicad_sch, Optopair.kicad_sch, Supply_Voltage_5V.kicad_sch, untitled.kicad_sch, Плата дискретных входов.kicad_pcb, Плата дискретных входов.kicad_sch]
2024-06-13 LED PhotoTrans schems and PCB
    [Плата фото светодиоды.kicad_pcb]
2024-06-17 Triak schems and PCB
    [Simister.kicad_sch, Simisters.kicad_sch, Плата симистров.kicad_pcb, Плата симистров.kicad_sch]
2024-06-18 Change TVS diods near optopair schems and PCB
    [Stepper_Motor_Control.kicad_sch, Плата внешних шаговых двигателей.kicad_pcb]
2024-06-18 add analog board reqs
2024-06-18 Main controller +3.3V RS485 schems and PCB
    [RS485_out.kicad_sch, Плата основного контроллера.kicad_pcb, Плата основного контроллера.kicad_sch]
2024-06-25 DIgit_IN renew schems
    [DescretInput.kicad_sch, DiscretOut.kicad_sch, Supply_Voltage_5V.kicad_sch, Плата дискретных входов.kicad_pcb, Плата дискретных входов.kicad_sch]
2024-06-26 Main controller renew schems and PCB
    [RTS_ISO.kicad_sch, Плата основного контроллера.kicad_pcb, Плата основного контроллера.kicad_sch]
2024-06-26 renew schems
    [PhotoTransistor.kicad_sch, Материнская плата-B_Cu.dxf, Материнская плата-Edge_Cuts.dxf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]
2024-06-27 DC motor schems
2024-06-28 Discret IN_OUT schems and PCB
    [DescretInput.kicad_sch, DiscretOut.kicad_sch, Supply_Voltage_5V.kicad_sch, Плата дискретных входов.kicad_pcb, Плата дискретных входов.kicad_sch]
2024-07-02 Renew footprint connectors PCB
    [Материнская плата.kicad_pcb, Плата внешних шаговых двигателей.kicad_pcb, Плата дискретных входов.kicad_pcb, Плата насосов.kicad_pcb, Плата основного контроллера.kicad_pcb, Плата симистров.kicad_pcb]
2024-07-03 Renew pin Prog connectors and schem Analog IO
    [AddSchems.kicad_sch, CurrentDet.kicad_sch, Detectors.kicad_sch, NUCLEO-64F411.kicad_sch, PumpV2.kicad_sch, Stepper_Motor_Control.kicad_sch, Supply_Voltage_5V.kicad_sch, Temp_Det.kicad_sch]
2024-07-04 digit IO terned LED
    [Плата дискретных входов.kicad_pcb]
2024-07-05 renew all schems and pcb for production
    [AddSchems.kicad_sch, CurrentDet.kicad_sch, Darlington.kicad_sch, DescretInput.kicad_sch, Detectors.kicad_sch, DiscretOut.kicad_sch, IN_OUT_Detector.kicad_sch, Optopair.kicad_sch]
2024-07-08 remove excess files
    [Материнская плата.kicad_pcb, Плата внешних шаговых двигателей.kicad_pcb, Плата дискретных входов.kicad_pcb, Плата основного контроллера.kicad_pcb, Плата симистров.kicad_pcb, Плата фото светодиоды.kicad_pcb]
2024-07-10 add relay control to analog board requirements
2024-07-10 PCB AND SCHEMS DC MOTOR
    [PumpV2.kicad_sch, Плата насосов.kicad_pcb, Плата насосов.kicad_sch]
2024-07-11 analog io control relay added
    [AddSchems.kicad_sch, relay_control.kicad_sch, Доп плата печи.kicad_sch]
2024-07-11 analog io control relay added1
    [AddSchems.kicad_sch, Доп плата печи.kicad_sch]
2024-07-17 anlog IO pcb and shcems
    [AddSchems.kicad_sch, CurrentDet.kicad_sch, Temp_Det.kicad_sch, Triak.kicad_sch, relay_control.kicad_sch, Доп плата печи.kicad_pcb, Доп плата печи.kicad_sch]
2024-07-18 add reqs to analog board to make it suitable for fridge control
2024-07-19 anlog IO shcems 2.0
    [Доп плата печи.kicad_sch]
2024-07-22 anlog IO shcems 2.1
    [AddSchems.kicad_sch, CurrentDet.kicad_sch, Temp_Det.kicad_sch, Zero_decoder.kicad_sch, relay_control.kicad_sch]
2024-07-23 QR code schems
    [USART.kicad_sch, Плата QR.kicad_sch]
2024-07-23 RENEW Analog IO schems
    [AddSchems.kicad_sch, relay_control.kicad_sch]
2024-07-25 QR board reqs
2024-07-26 qr code 1.1
    [Плата QR.kicad_pcb]
2024-07-27 analog board add mech relay diode requirement
2024-07-27 Remove relay signal current limiting requirement
2024-07-28 RENEW ALL BOARDS
    [AddSchems.kicad_sch, DescretInput.kicad_sch, DiscretOut.kicad_sch, PhotoTransistor.kicad_sch, Simisters.kicad_sch, Supply_Voltage_5V.kicad_sch, relay_control.kicad_sch, Доп плата печи.kicad_pcb]
2024-07-31 CHANGE CONNECTORS ON DG245
    [Simisters.kicad_sch, Плата симистров.kicad_pcb, Плата симистров.kicad_sch]
2024-08-01 IO ANALOG PCB
    [AddSchems.kicad_sch, relay_control.kicad_sch, Доп плата печи.kicad_pcb]
2024-08-08 qr code schems and pcb
    [USART.kicad_sch, Плата QR.kicad_pcb, Плата QR.kicad_sch]
2024-08-23 qr and analog refresh
    [AddSchems.kicad_sch, CurrentDet.kicad_sch, Temp_Det.kicad_sch, Triak.kicad_sch, USART.kicad_sch, Zero_decoder.kicad_sch, relay_control.kicad_sch, Доп плата печи.kicad_pcb]
2024-09-26 fix "pia" typo
    [AddSchems.kicad_sch, CurrentDet.kicad_sch, DescretInput.kicad_sch, Detectors.kicad_sch, DiscretOut.kicad_sch, NUCLEO-64F411.kicad_sch, PumpV2.kicad_sch, RS485_out.kicad_sch]
2024-10-03 rename files to snake case matching with their dir
    [AddSchems.kicad_sch, CurrentDet.kicad_sch, DC-DC5-3V.kicad_sch, DescretInput.kicad_sch, Detectors.kicad_sch, DiscretOut.kicad_sch, NUCLEO-64F411.kicad_sch, POWER_SUPPLY_RS485.kicad_sch]
2024-11-20 add manipulator attachment scheme
    [Magnit.kicad_sch, RS485.kicad_sch, VCC24-3R3.kicad_sch, grab.kicad_sch, manipulator_attachment.kicad_sch]
2024-11-20 fix dc board issues before manufacturing
    [PumpV2.kicad_sch, Supply_Voltage_5V.kicad_sch, dc_motor_board.kicad_pcb, dc_motor_board.kicad_sch]
2024-11-21 DC, contr, mb, step v2
    [Detectors.kicad_sch, NUCLEO-64F411.kicad_sch, RS485_out.kicad_sch, RTS_ISO.kicad_sch, Stepper_Motor_Control.kicad_sch, VCC.kicad_sch, controller_board.kicad_pcb, controller_board.kicad_sch]
2024-11-21 digit_in v2
    [DescretInput.kicad_sch, DiscretOut.kicad_sch, Supply_Voltage_5V.kicad_sch, digit_in_board.kicad_pcb, digit_in_board.kicad_sch]
2024-11-25 DC, contr, mb, digit in v2.1
    [Magnit.kicad_sch, NUCLEO-64F411.kicad_sch, POWER_SUPPLY_RS485.kicad_sch, PumpV2.kicad_sch, RS485.kicad_sch, RS485_out.kicad_sch, RTS_ISO.kicad_sch, Supply_Voltage_5V.kicad_sch]
2024-11-26 step v2.1
    [step_motor_board.kicad_pcb]
2024-11-27 Triak v2.1
    [NUCLEO-64F411.kicad_sch, RS485_out.kicad_sch, RTS_ISO.kicad_sch, Simister.kicad_sch, Simisters.kicad_sch, controller_board.kicad_sch, dc_motor_board.kicad_pcb, motherboard.kicad_pcb]
2024-11-29 manipulator 1.0
    [Magnit.kicad_sch, RS485.kicad_sch, VCC24-3R3.kicad_sch, grab.kicad_sch, manipulator_attachment.kicad_pcb, manipulator_attachment.kicad_sch, техплата программатора.kicad_pcb, техплата программатора.kicad_sch]
2024-12-02 controller убраны ловушки
    [PumpV2.kicad_sch, Supply_Voltage_5V.kicad_sch, dc_motor_board.kicad_pcb, dc_motor_board.kicad_sch]
2024-12-02 digit_in убраны ловушки
    [controller_board.kicad_pcb]
2024-12-02 step убраны ловушки
    [digit_in_board.kicad_pcb]
2024-12-02 mother убраны ловушки
    [motherboard.kicad_pcb, step_motor_board.kicad_pcb]
2024-12-02 created integration tests for all boards
2024-12-04 Step установлена бусинка
    [step_motor_board.kicad_pcb, step_motor_board.kicad_sch]
2024-12-05 led_and_photo замена цепь формирования выходного сигнала
    [Outrepiter.kicad_sch, PhotoTransistor.kicad_sch, Vref.kicad_sch, led_and_photodiode_board.kicad_sch]
2024-12-06 Step кондеры pai
    [step_motor_board.kicad_pcb]
2024-12-06 Step кислотные ловушки убраны
    [step_motor_board.kicad_pcb]
2024-12-06 motherboard установлены тестовые площадки
    [VCC.kicad_sch, motherboard.kicad_pcb, motherboard.kicad_sch]
2024-12-06 controller метализированные отверстия
    [controller_board.kicad_pcb, controller_board.kicad_sch]
2024-12-06 controller тестовые площадки
    [controller_board.kicad_pcb, controller_board.kicad_sch]
2024-12-06 controller кислотные ловушки
    [controller_board.kicad_pcb]
2024-12-06 controller кислотные ловушки1
    [controller_board.kicad_pcb]
2024-12-06 dc утолщение силовой части
    [dc_motor_board.kicad_pcb]
2024-12-06 dc Pai capasitor
    [dc_motor_board.kicad_pcb, dc_motor_board.kicad_sch]
2024-12-06 dc шелкография
    [dc_motor_board.kicad_pcb]
2024-12-07 digit in ловушки
    [digit_in_board.kicad_pcb]
2024-12-07 manipulator ловушки
    [digit_in_board.kicad_pcb, manipulator_attachment.kicad_pcb]
2024-12-07 manipulator крепежные отверстия
    [manipulator_attachment.kicad_pcb]
2024-12-07 ledphoto исправлена микросхема
    [Outrepiter.kicad_sch]
2024-12-07 step исправлены ловушки
    [step_motor_board.kicad_pcb]
2024-12-07 controller кондеры pai на одной стороне
    [controller_board.kicad_pcb]
2024-12-07 controller кондеры pai на одной стороне 2
    [controller_board.kicad_pcb]
2024-12-07 triak уменьшение нагрева
    [Simisters.kicad_sch, triac_board.kicad_pcb]
2024-12-07 digit in test point
    [digit_in_board.kicad_pcb]
2024-12-08 ledphoto коррекция схемы
    [Outrepiter.kicad_sch, PhotoTransistor.kicad_sch, Vref.kicad_sch, led_and_photodiode_board.kicad_sch]
2024-12-10 Triak поправлен нагрев дорожек
    [triac_board.kicad_pcb]
2024-12-10 культя добавлен логотип
    [manipulator_attachment.kicad_pcb]
2024-12-11 ledphoto обновление питания светодиодов
    [DC-DC 24-5V.kicad_sch, PhotoTransistor.kicad_sch, led_and_photodiode_board.kicad_sch]
2024-12-11 add raw list of boards' requirements
2024-12-11 add common boards' requirements
2024-12-11 update di's board requirements
2024-12-11 update led's requirements
2024-12-17 ledphoto обновлена схема и pcb
    [DC-DC 24-5V.kicad_sch, Outrepiter.kicad_sch, PhotoTransistor.kicad_sch, Vref.kicad_sch, led_and_photodiode_board.kicad_pcb, led_and_photodiode_board.kicad_sch]
2024-12-17 ledphoto скругление на заливках
    [led_and_photodiode_board.kicad_pcb]
2024-12-20 ledphoto замена компаратора на операционник, добавлен снаббер
    [DC-DC 24-5V.kicad_sch, Outrepiter.kicad_sch]
2024-12-20 triak обновлен снаббер
    [Simister.kicad_sch]
2024-12-20 triak убраны тестовые площадки с 220в
    [Simister.kicad_sch, Simisters.kicad_sch, triac_board.kicad_pcb]
2024-12-20 all замменил резисторы failsafe в плате контроллера и обрал из перечня во всех остальных
    [AddSchems.kicad_sch, CurrentDet.kicad_sch, Detectors.kicad_sch, Stepper_Motor_Control.kicad_sch, Temp_Det.kicad_sch, Triak.kicad_sch, USART.kicad_sch, Zero_decoder.kicad_sch]
2024-12-20 triak снаббер
    [Simister.kicad_sch, triac_board.kicad_pcb]
2024-12-21 triak снаббер pcb
    [triac_board.kicad_pcb]
2024-12-26 step,mother,digitin,dc,controller электронные сборочные
    [dc_motor_board.kicad_pcb, dc_motor_board.kicad_sch]
2024-12-30 manipulator углы и терминатор
    [Magnit.kicad_sch, RS485.kicad_sch, VCC24-3R3.kicad_sch, grab.kicad_sch, manipulator_attachment.kicad_pcb, manipulator_attachment.kicad_sch]
2025-01-08 led and photo топология
    [DC-DC 24-5V.kicad_sch, Outrepiter.kicad_sch, led_and_photodiode_board.kicad_pcb, led_and_photodiode_board.kicad_sch]
2025-03-14 rewrite RTS power interrupt logic
2025-03-25 remove excess di inputs checking
    only one firmware actually needs checking, moved it to a comment
2025-03-25 add missed power turning
2025-03-26 separate stepper noise, real load and max 24v load
2025-03-26 separate dc noise, real load and max 24v load
2025-03-26 separate triac noise, real load and max 24v load
2025-03-26 remove sensors tests
    will add them in new tests
2025-03-26 separate analog noise, real load and max 24v load
2025-03-27 return limit switch testing
2025-03-27 return current testing
2025-03-28 remove operator's start signal
    now tests start after a power up
2025-03-28 remove excess slave boards signals from test 1
    master's signals are enough
2025-03-28 remove slave boards signals for lim and photo tests
    now only master signals about test's state
2025-03-28 remove excess signals from slave boards
2025-03-28 remove parad function from sensors tests
    "previous firmwares" (*_013) use usart for rs testing, which collides
    with usart signals for sensors tests
2025-03-28 add temperature test
2025-03-28 remove unrelated checks and signals from real scenarios tests
    no need for start command - starting after a power up
    no need for signals either - only temp and behaviour should be validated
2025-04-04 QRcode udate size and schems
    [USART.kicad_sch, qr_code.kicad_pcb, qr_code.kicad_sch]
2025-04-04 added units
    [24Analog.kicad_sch, 24Digit.kicad_sch, 36V.kicad_sch, 7V_looks.kicad_sch, CASE 220V (2).kicad_sch, CASE 220V (3).kicad_sch, CASE 220V.kicad_sch, COFFE_MASHINE.kicad_sch]
2025-04-05 change cut schems
    [Connection table 1.kicad_sch, Motherboard and +24V digit.kicad_sch, RightSideConnectors.kicad_sch]
2025-04-09 add LED_give
    [Led_give.kicad_pcb, Led_give.kicad_sch]
2025-04-09 add LED_give PCB
    [Led_give.kicad_pcb, Led_give.kicad_sch]
2025-04-10 refresh ledfotodiod
    [DC-DC 24-5V.kicad_sch, Outrepiter.kicad_sch, PhotoTransistor.kicad_sch, Vref.kicad_sch, led_and_photodiode_board.kicad_pcb, led_and_photodiode_board.kicad_sch]
2025-04-30 remove temp sensors tests
2025-04-30 remove 2nd analog board
2025-05-05 remove current sensor test
2025-05-21 mother board refresh
    [POWER_SUPPLY_RS485.kicad_sch, VCC.kicad_sch, motherboard.kicad_pcb, motherboard.kicad_sch]
2025-06-02 analog board refresh
    [AddSchems.kicad_sch, CurrentDet.kicad_sch, Temp_Det.kicad_sch, Triak.kicad_sch, Zero_decoder.kicad_sch, analog_io_board.kicad_pcb, analog_io_board.kicad_sch, relay_control.kicad_sch]
2025-06-10 analog board refresh pcb
    [AddSchems.kicad_sch, CurrentDet.kicad_sch, Temp_Det.kicad_sch, Triak.kicad_sch, Zero_decoder.kicad_sch, analog_io_board.kicad_pcb, analog_io_board.kicad_sch, relay_control.kicad_sch]
2025-10-31 update schemas
    [24Analog.kicad_sch, 24Digit.kicad_sch, 36V.kicad_sch, 7V_looks.kicad_sch, CASE 220V (2).kicad_sch, CASE 220V (3).kicad_sch, CASE 220V.kicad_sch, COFFE_MASHINE.kicad_sch]
2025-10-31 add missed sheets
    [ConnectionTable_1.kicad_sch, ConnectionTable_2.kicad_sch, ConnectionTable_3.kicad_sch, ConnectionTable_4.kicad_sch, ConnectionTable_5.kicad_sch, ConnectionTable_6.kicad_sch, ConnectionTable_7.kicad_sch]
